busmaster/homebus/hardware/do8/do8_brd.png

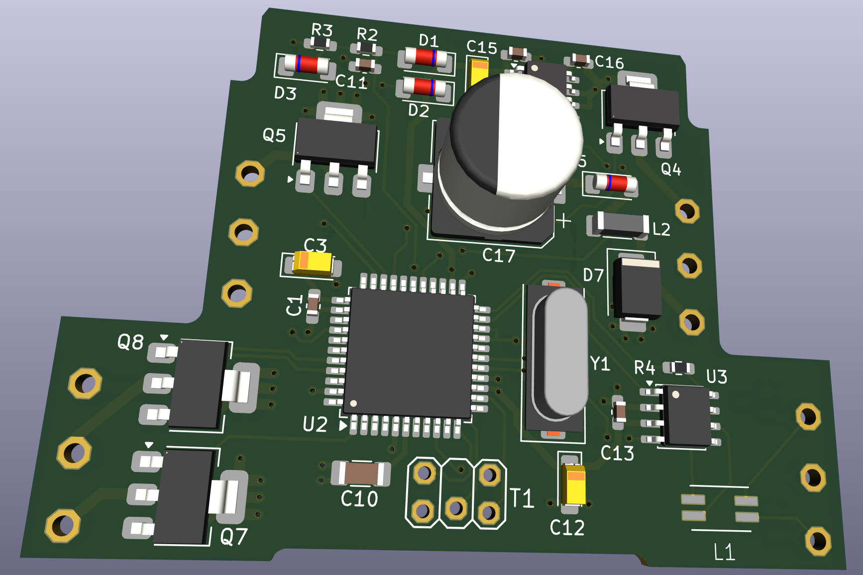
hardware/do8/do8_brd.png
