busmaster/homebus/hardware/cff3100if/cff3100if.jpg

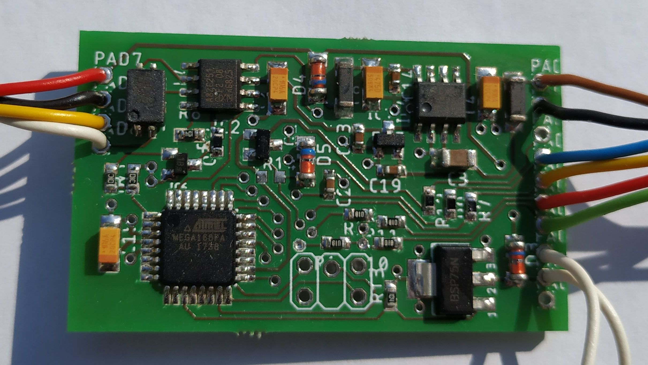
hardware/cff3100if/cff3100if.jpg
