busmaster/homebus/hardware/cff3100if/cff3100.jpg

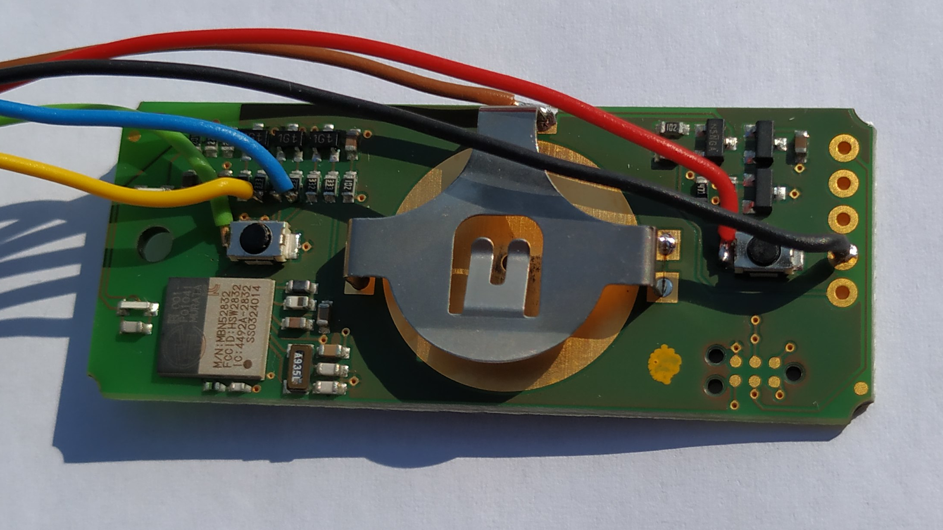
hardware/cff3100if/cff3100.jpg
