busmaster/homebus/hardware/cff3100if/cff3100if_brd.png

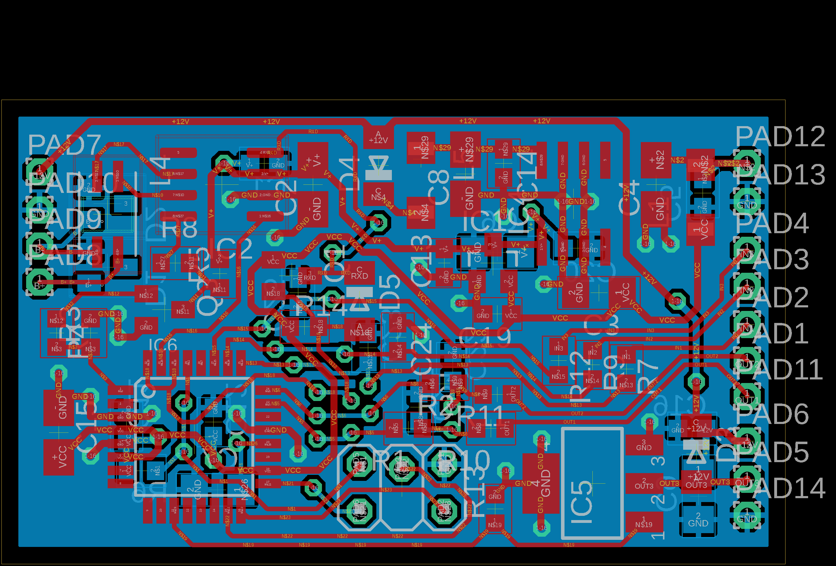
hardware/cff3100if/cff3100if_brd.png
