busmaster/homebus/hardware/cff3100if/cff3100if_sch.png

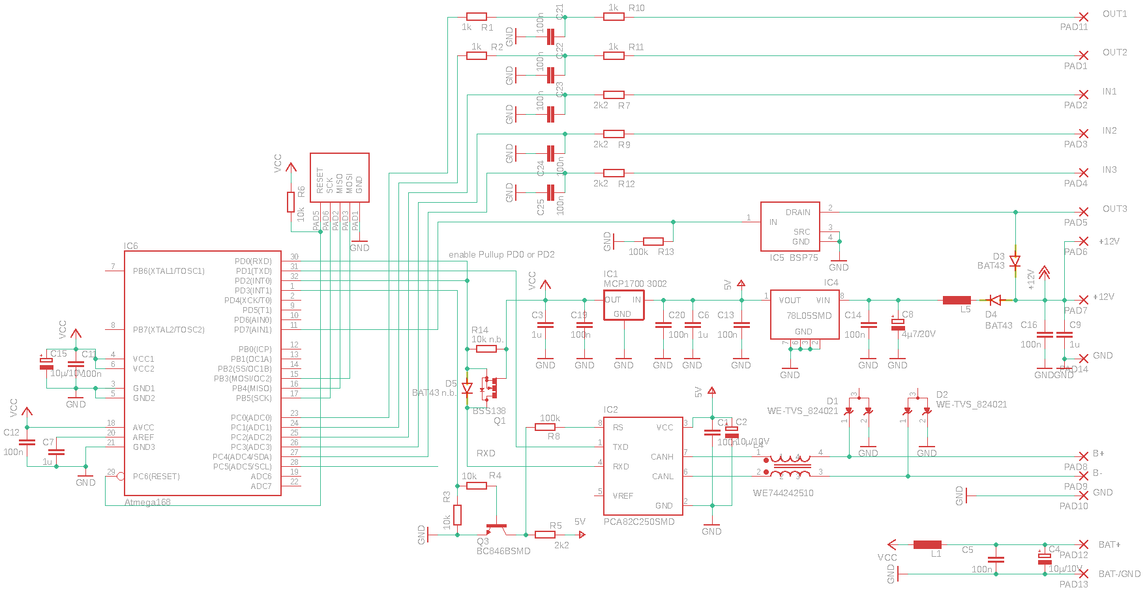
hardware/cff3100if/cff3100if_sch.png
