busmaster/homebus/hardware/do8/do8_sch.png

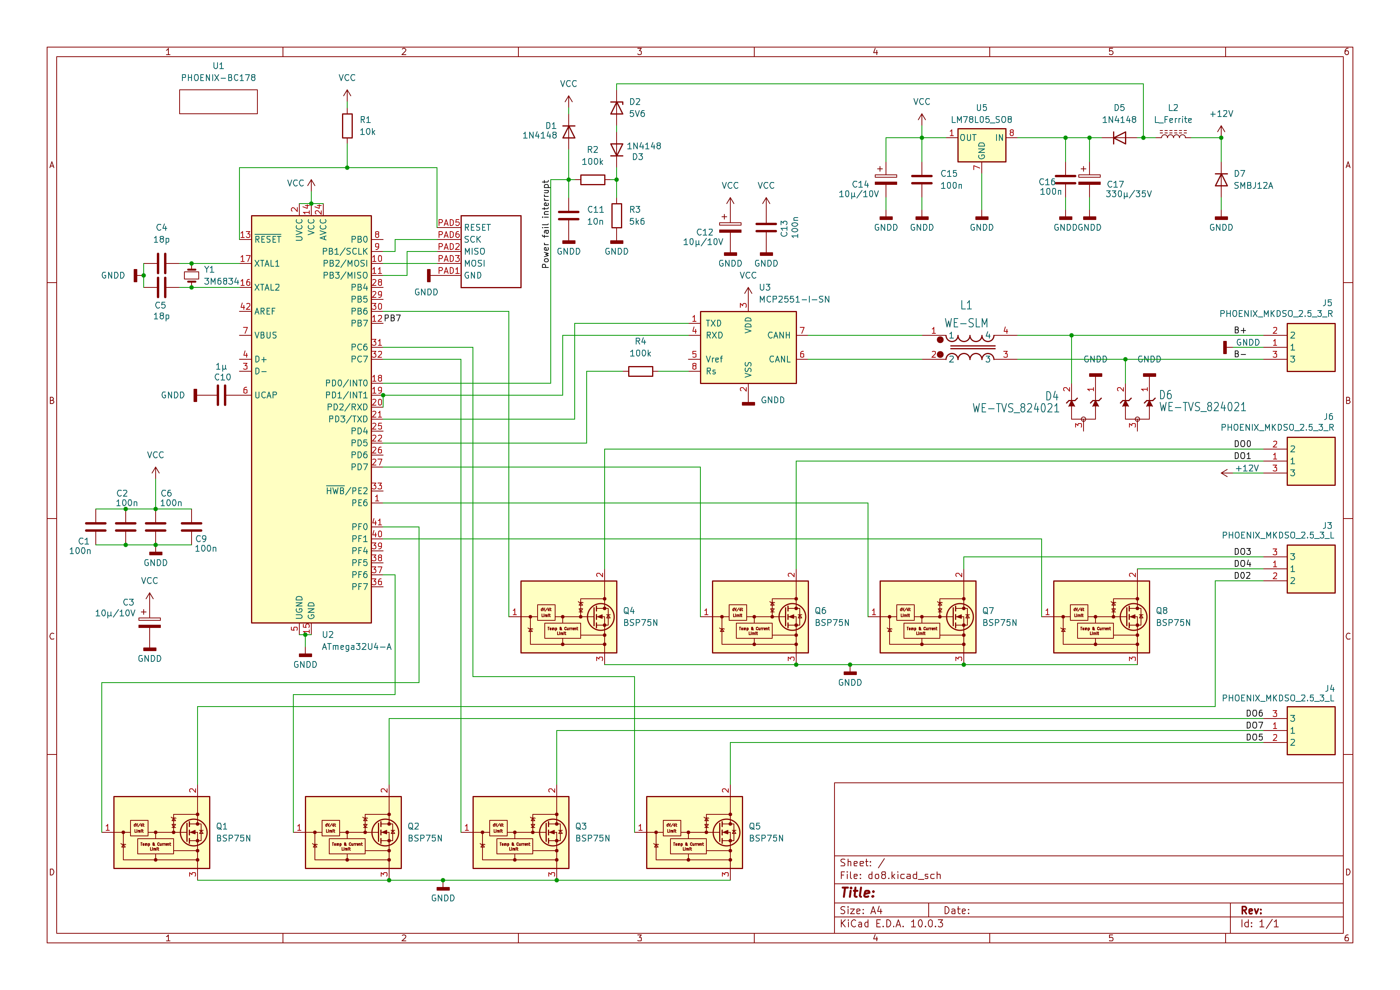
hardware/do8/do8_sch.png
