busmaster/homebus/hardware/do31/do31_brd.png

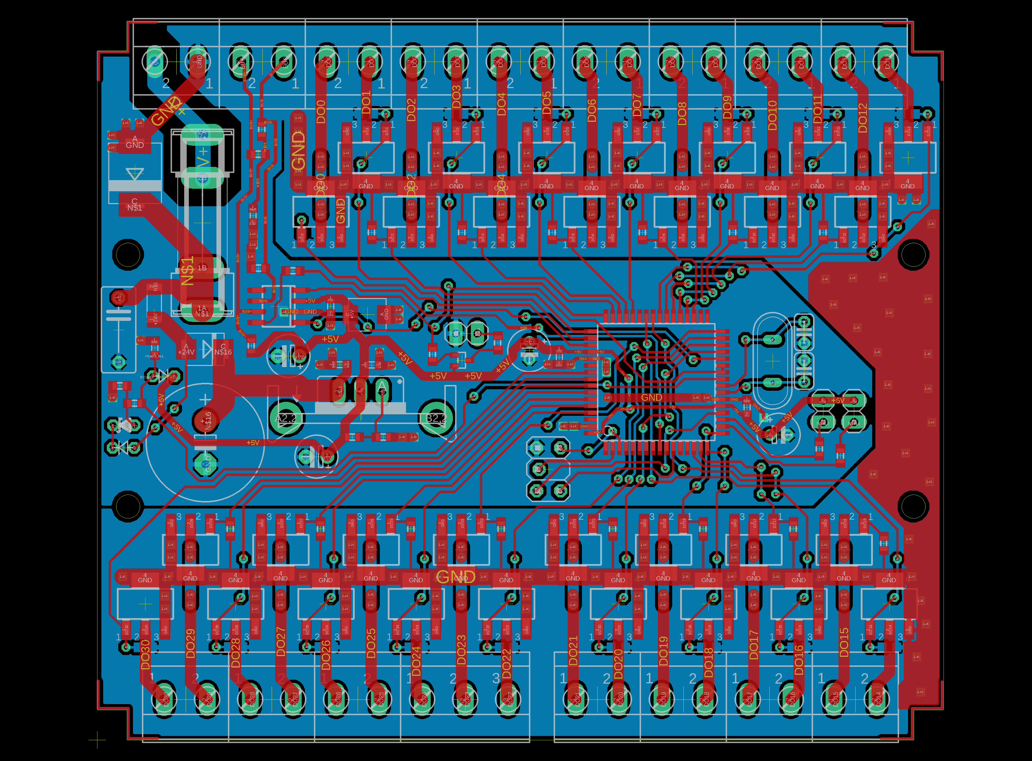
hardware/do31/do31_brd.png
