busmaster/homebus/hardware/do31/do31_sch.png

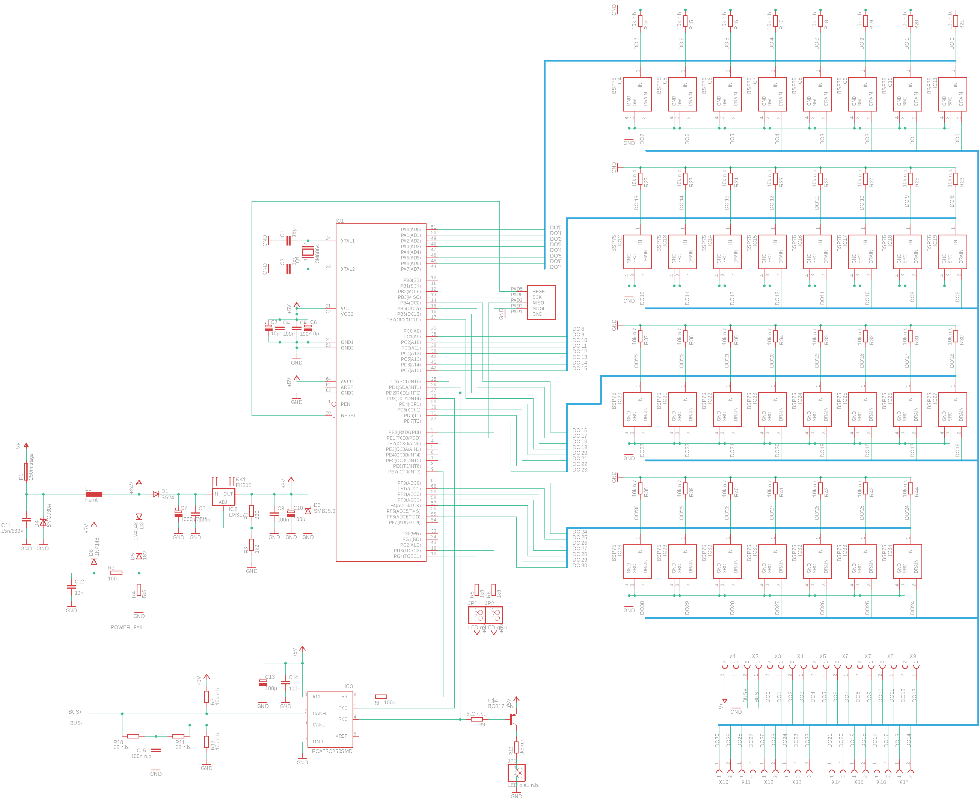
hardware/do31/do31_sch.png
