busmaster/homebus/hardware/smartmeterif/smartmeterif_2_brd.png

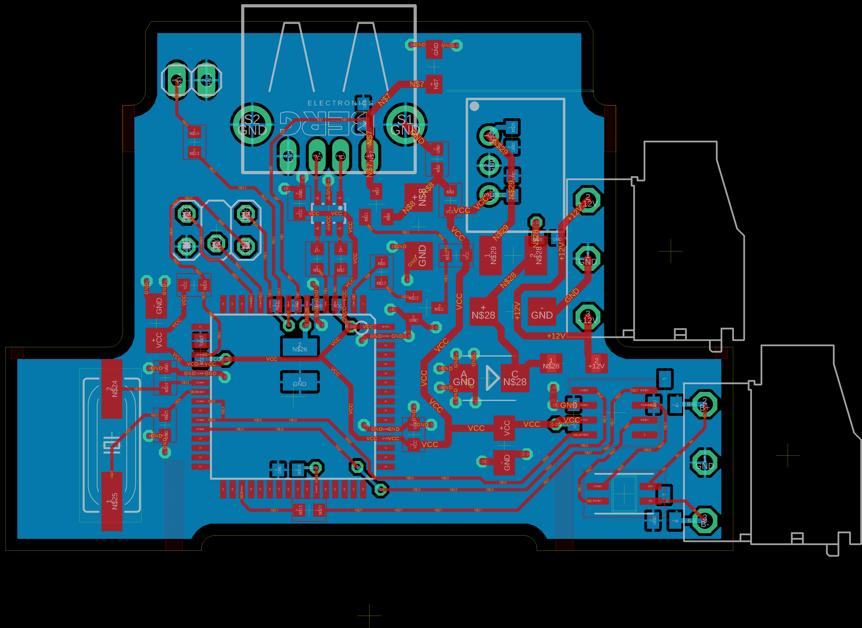
hardware/smartmeterif/smartmeterif_2_brd.png
