busmaster/homebus/hardware/smartmeterif/smartmeterif_2_sch.png

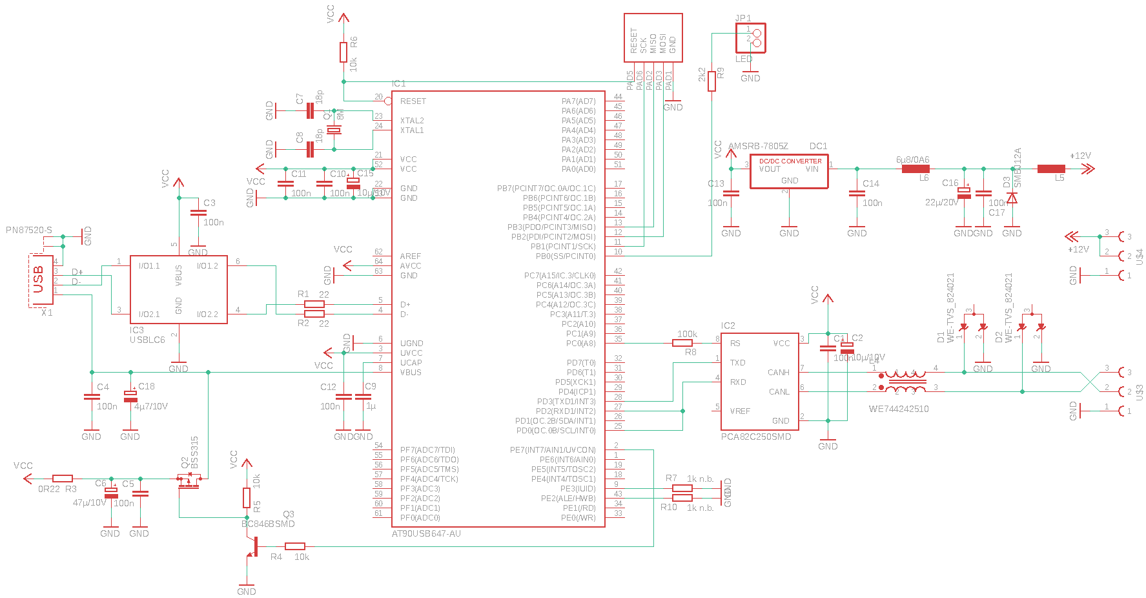
hardware/smartmeterif/smartmeterif_2_sch.png
