busmaster/homebus/hardware/smartmeterif/smartmeterif_brd.png

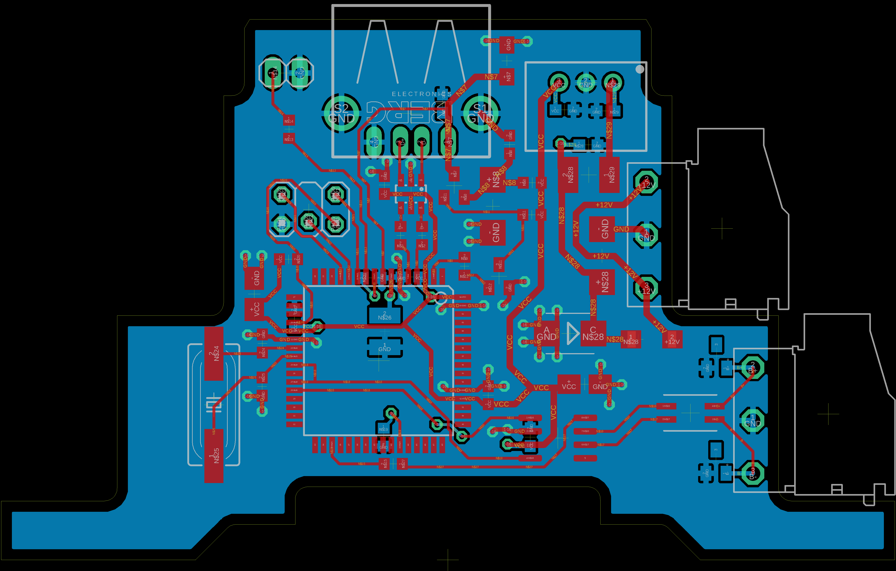
hardware/smartmeterif/smartmeterif_brd.png
