busmaster/homebus/hardware/stoveguard/stoveguard_brd.png

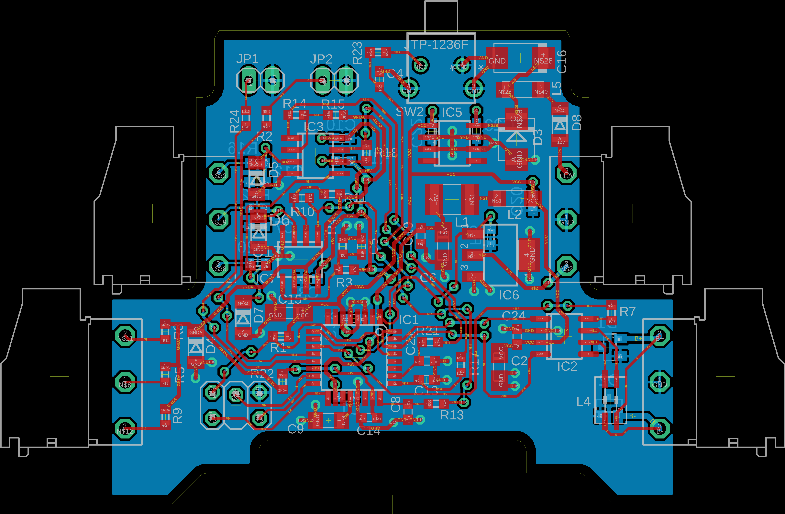
hardware/stoveguard/stoveguard_brd.png
