busmaster/homebus/hardware/stoveguard/stoveguard_sch.png

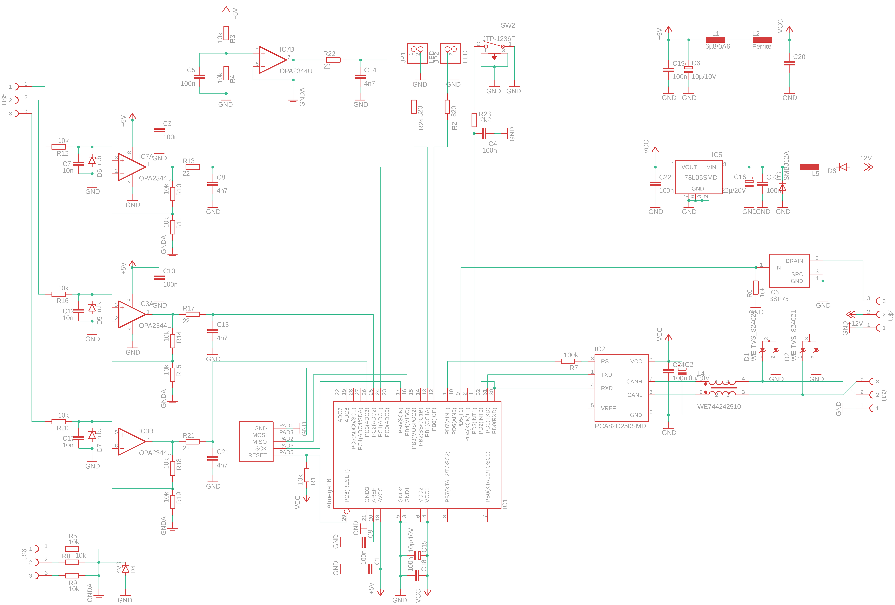
hardware/stoveguard/stoveguard_sch.png
