busmaster/homebus/hardware/usbif/usbif2.png

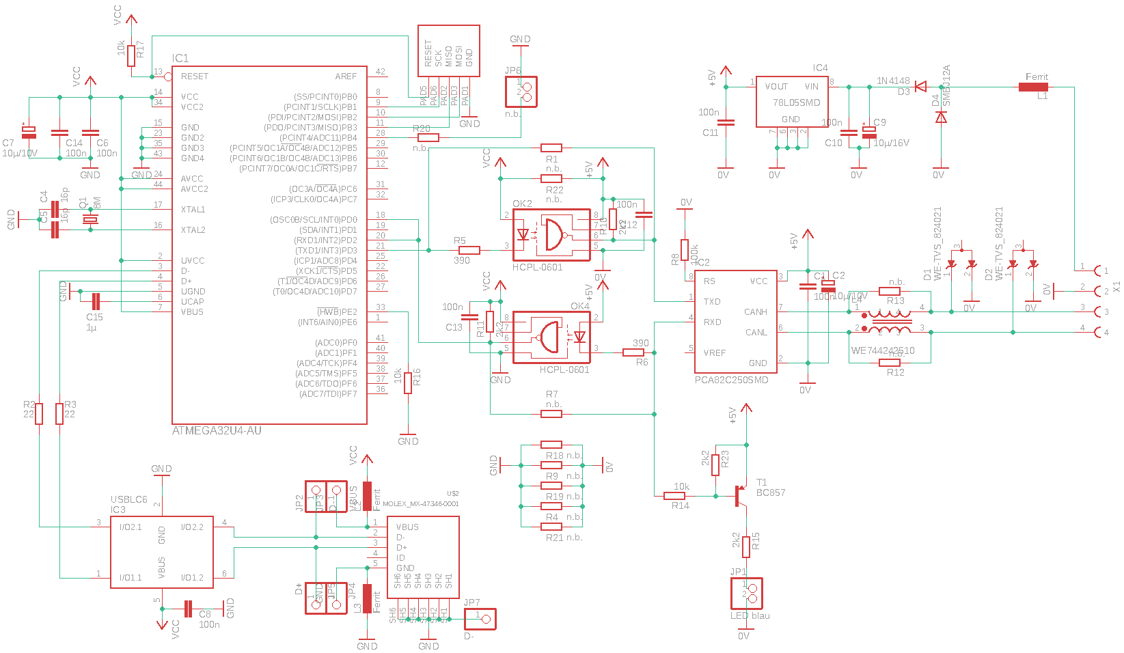
hardware/usbif/usbif2.png
