busmaster/homebus/hardware/do8/do8.kicad_pcb

## KiCad design hardware/do8/do8.kicad_pcb (2026-06-28)

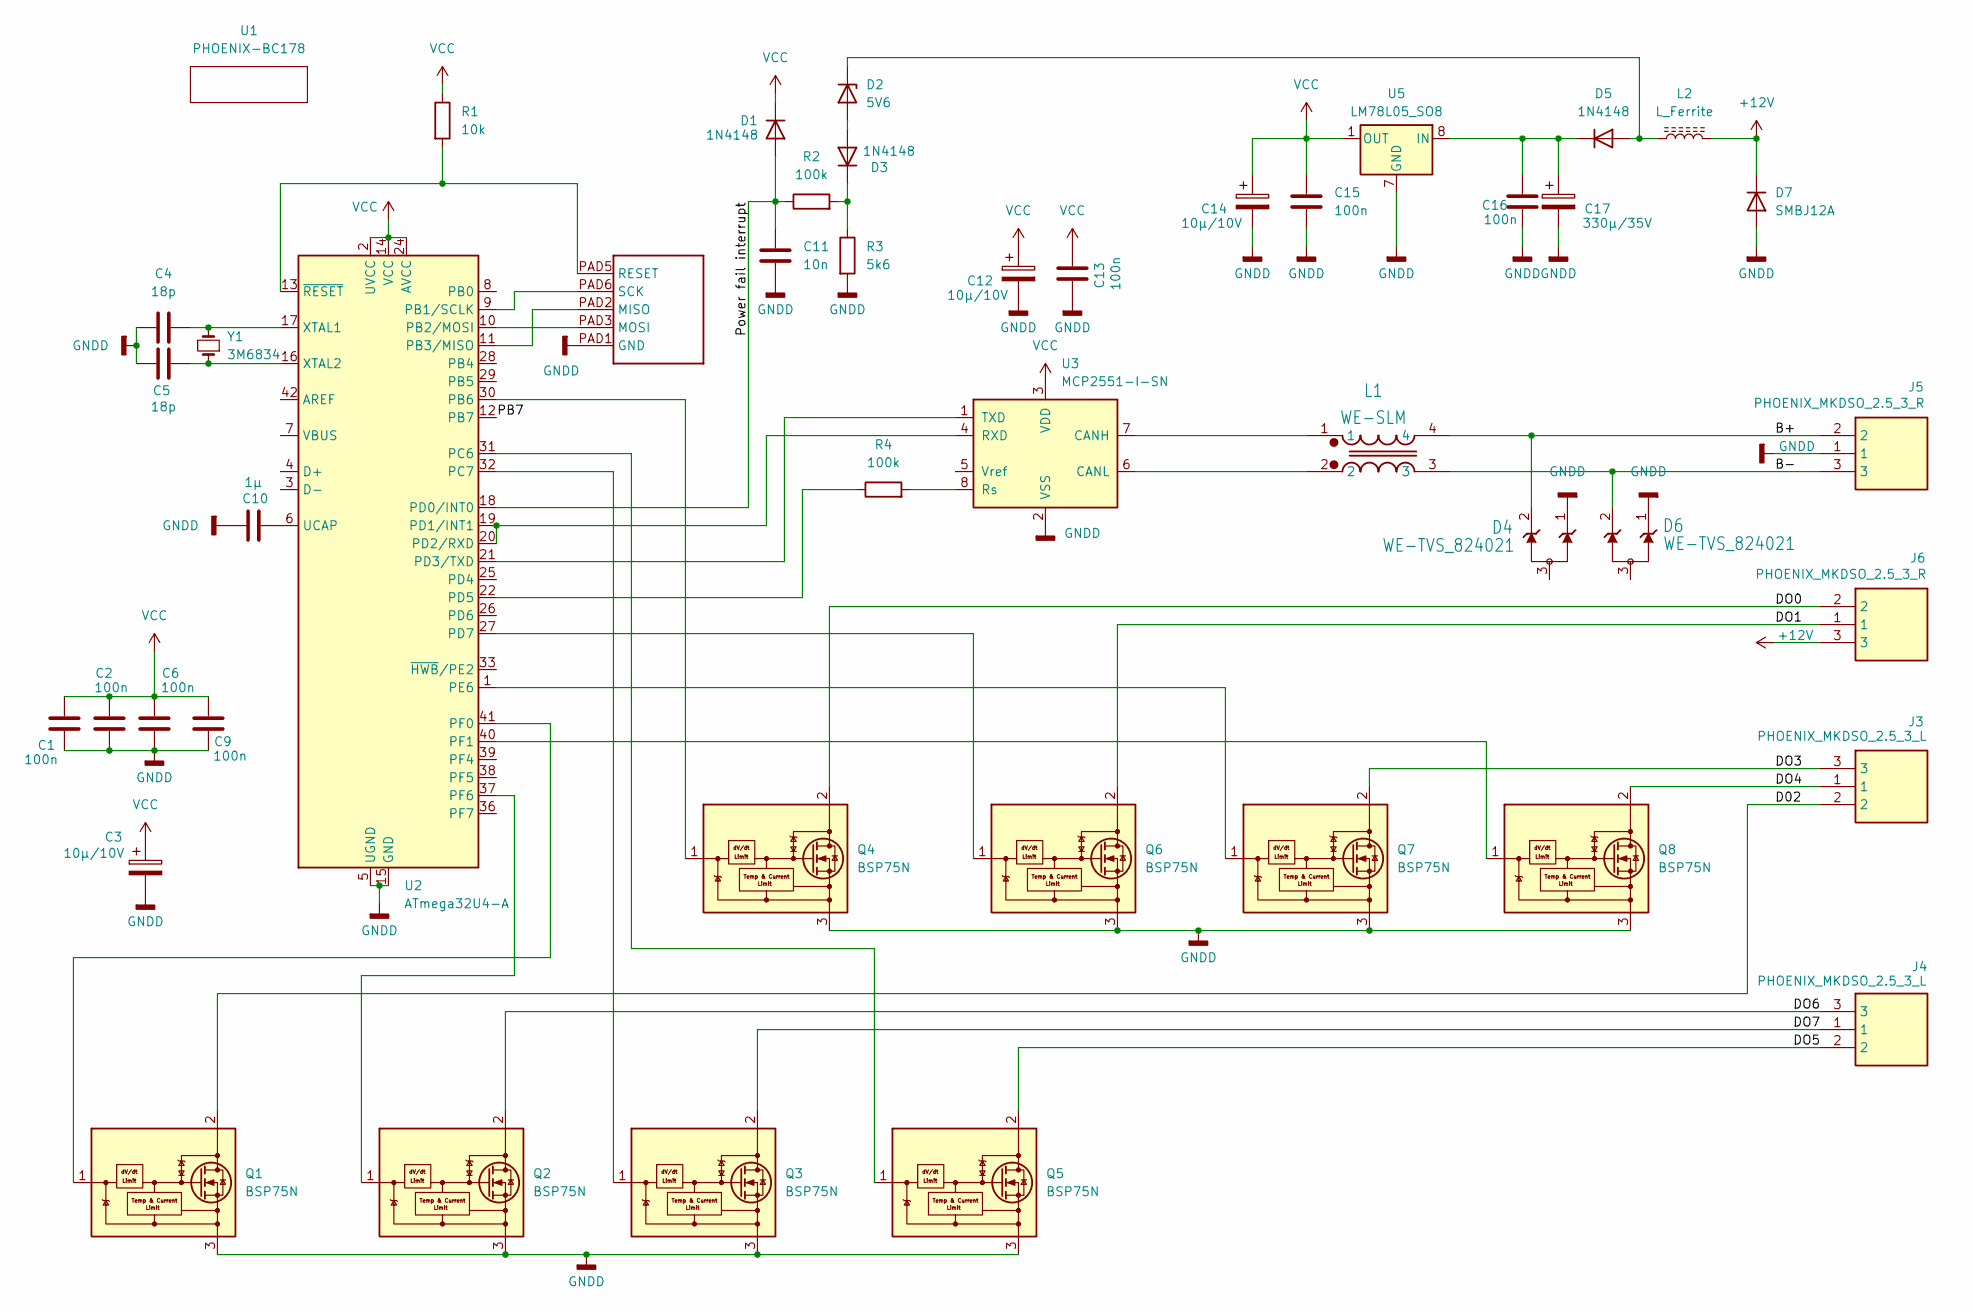
[picture p16: schematic do8.kicad_sch]

Parts:
C1, C2, C6, C9, C13, C15, C16: 100n; C_0603_1608Metric_Pad1.08x0.95mm_HandSolder
C3, C12, C14: 10µ/10V; CP_EIA-3216-18_Kemet-A_HandSolder
C4, C5: 18p; C_0603_1608Metric_Pad1.08x0.95mm_HandSolder
C10: 1µ; C_1206_3216Metric_Pad1.33x1.80mm_HandSolder
C11: 10n; C_0603_1608Metric_Pad1.08x0.95mm_HandSolder
C17: 330µ/35V; CP_Elec_10x10.5
D1, D3, D5: 1N4148; D_MiniMELF
D2: 5V6; D_MiniMELF
D4, D6: WE-TVS_824021
D7: SMBJ12A; D_SMB
J3, J4: PHOENIX_MKDSO_2.5_3_L; phoenix_mkdso_2.5_3_l; Manufacturer_Part_Number 2854102; Mouser Part Number 651-2854102
J5, J6: PHOENIX_MKDSO_2.5_3_R; phoenix_mkdso_2.5_3_r; Manufacturer_Part_Number 2854092; Mouser Part Number 651-2854092
L1: WE-SLM
L2: L_Ferrite; L_1806_4516Metric
Q1, Q2, Q3, Q4, Q5, Q6, Q7, Q8: BSP75N; SOT-223
R1: 10k; R_0603_1608Metric_Pad0.98x0.95mm_HandSolder
R2, R4: 100k; R_0603_1608Metric_Pad0.98x0.95mm_HandSolder
R3: 5k6; R_0603_1608Metric_Pad0.98x0.95mm_HandSolder
T1: atmel-isp
U1: PHOENIX-BC178; phoenix-bc178-reduced-3
U2: ATmega32U4-A; TQFP-44_10x10mm_P0.8mm
U3: MCP2551-I-SN; SOIC-8_3.9x4.9mm_P1.27mm
U5: LM78L05_SO8; SOIC-8_3.9x4.9mm_P1.27mm
Y1: 3M6834; Crystal_SMD_HC49-SD

Connections:
+12V: D7.1 (K), J6.3, L2.2
/B+: D4.2, J5.2, L1.4
/B-: D6.2, J5.3, L1.3
/D02: J3.2, Q1.2 (DRAIN)
/DO0: J6.2, Q4.2 (DRAIN)
/DO1: J6.1, Q6.2 (DRAIN)
/DO3: J3.3, Q7.2 (DRAIN)
/DO4: J3.1, Q8.2 (DRAIN)
/DO5: J4.2, Q5.2 (DRAIN)
/DO6: J4.3, Q2.2 (DRAIN)
/DO7: J4.1, Q3.2 (DRAIN)
/Power fail interrupt: C11.1, D1.2 (A), R2.1, U2.18 (PD0)
GNDD: C1.1, C2.1, C3.2, C4.1, C5.1, C6.1, C9.1, C10.2, C11.2, C12.2, C13.1, C14.2, C15.2, C16.2, C17.2, D4.1, D6.1, D7.2 (A), J5.1, Q1.3 (SOURCE), Q1.4 (SOURCE), Q2.3 (SOURCE), Q2.4 (SOURCE), Q3.3 (SOURCE), Q3.4 (SOURCE), Q4.3 (SOURCE), Q4.4 (SOURCE), Q5.3 (SOURCE), Q5.4 (SOURCE), Q6.3 (SOURCE), Q6.4 (SOURCE), Q7.3 (SOURCE), Q7.4 (SOURCE), Q8.3 (SOURCE), Q8.4 (SOURCE), R3.2, T1.PAD1 (GND), U2.5 (UGND), U2.15 (GND), U2.23 (GND), U2.35 (GND), U2.43 (GND), U3.2 (VSS), U5.2 (GND), U5.3 (GND), U5.6 (GND), U5.7 (GND)
unnamed: D2.2 (A), D3.2 (A)
unnamed: D2.1 (K), D5.2 (A), L2.1
unnamed: D3.1 (K), R2.2, R3.1
unnamed: C16.1, C17.1, D5.1 (K), U5.8 (IN)
unnamed: Q1.1 (IN), U2.41 (PF0)
unnamed: Q2.1 (IN), U2.37 (PF6)
unnamed: Q3.1 (IN), U2.32 (PC7)
unnamed: Q4.1 (IN), U2.30 (PB6)
unnamed: Q5.1 (IN), U2.31 (PC6)
unnamed: Q6.1 (IN), U2.27 (PD7)
unnamed: Q7.1 (IN), U2.1 (PE6)
unnamed: Q8.1 (IN), U2.40 (PF1)
unnamed: T1.PAD2 (MISO), U2.11 (PB3)
unnamed: T1.PAD3 (MOSI), U2.10 (PB2)
unnamed: R1.2, T1.PAD5 (RESET), U2.13 (~RESET)
unnamed: T1.PAD6 (SCK), U2.9 (PB1)
unnamed: U2.19 (PD1), U2.20 (PD2), U3.4 (RXD)
unnamed: U2.21 (PD3), U3.1 (TXD)
unnamed: R4.1, U2.22 (PD5)
unnamed: C10.1, U2.6 (UCAP)
unnamed: C4.2, U2.17 (XTAL1), Y1.2
unnamed: C5.2, U2.16 (XTAL2), Y1.1
unnamed: L1.1, U3.7 (CANH)
unnamed: L1.2, U3.6 (CANL)
unnamed: R4.2, U3.8 (Rs)
VCC: C1.2, C2.2, C3.1, C6.2, C9.2, C12.1, C13.2, C14.1, C15.1, D1.1 (K), R1.1, U2.2 (UVCC), U2.14 (VCC), U2.24 (AVCC), U2.34 (VCC), U2.44 (AVCC), U3.3 (VDD), U5.1 (OUT)

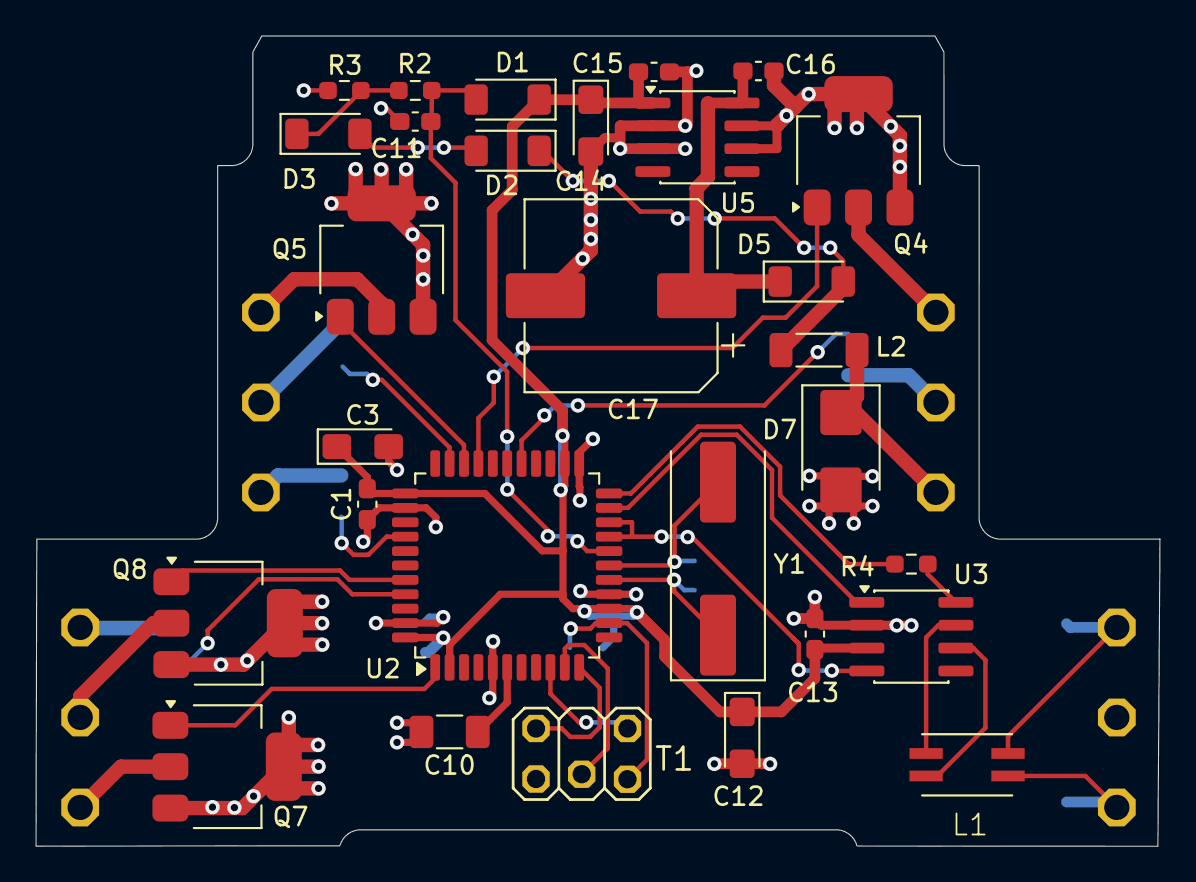
[picture p17: board do8.kicad_pcb from above]

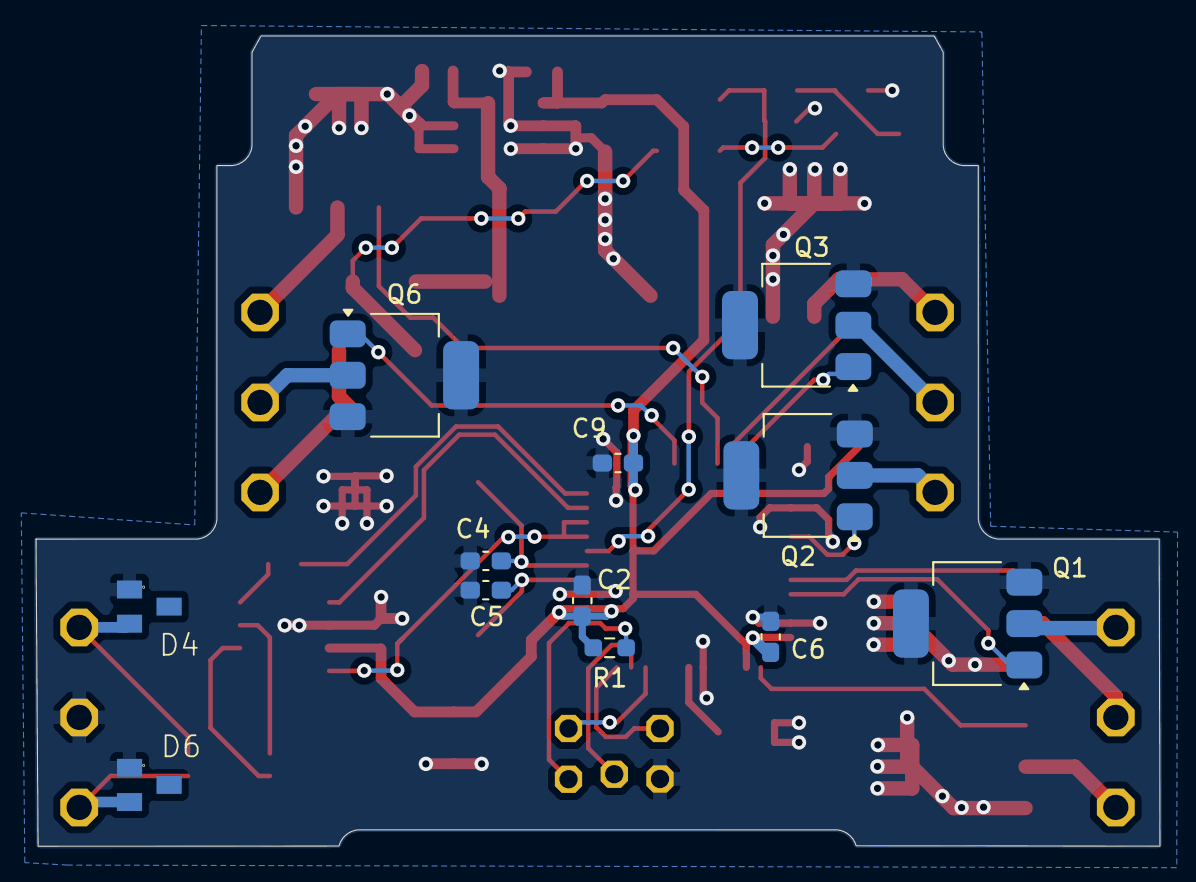
[picture p18: board do8.kicad_pcb from below]

Board: 2 copper layers, 62.4 x 45.0 mm, 46 parts (12 on the bottom side), 39 nets.
