busmaster/homebus/hardware/do31/do31.brd

## EAGLE design hardware/do31/do31.brd (2023-08-31)

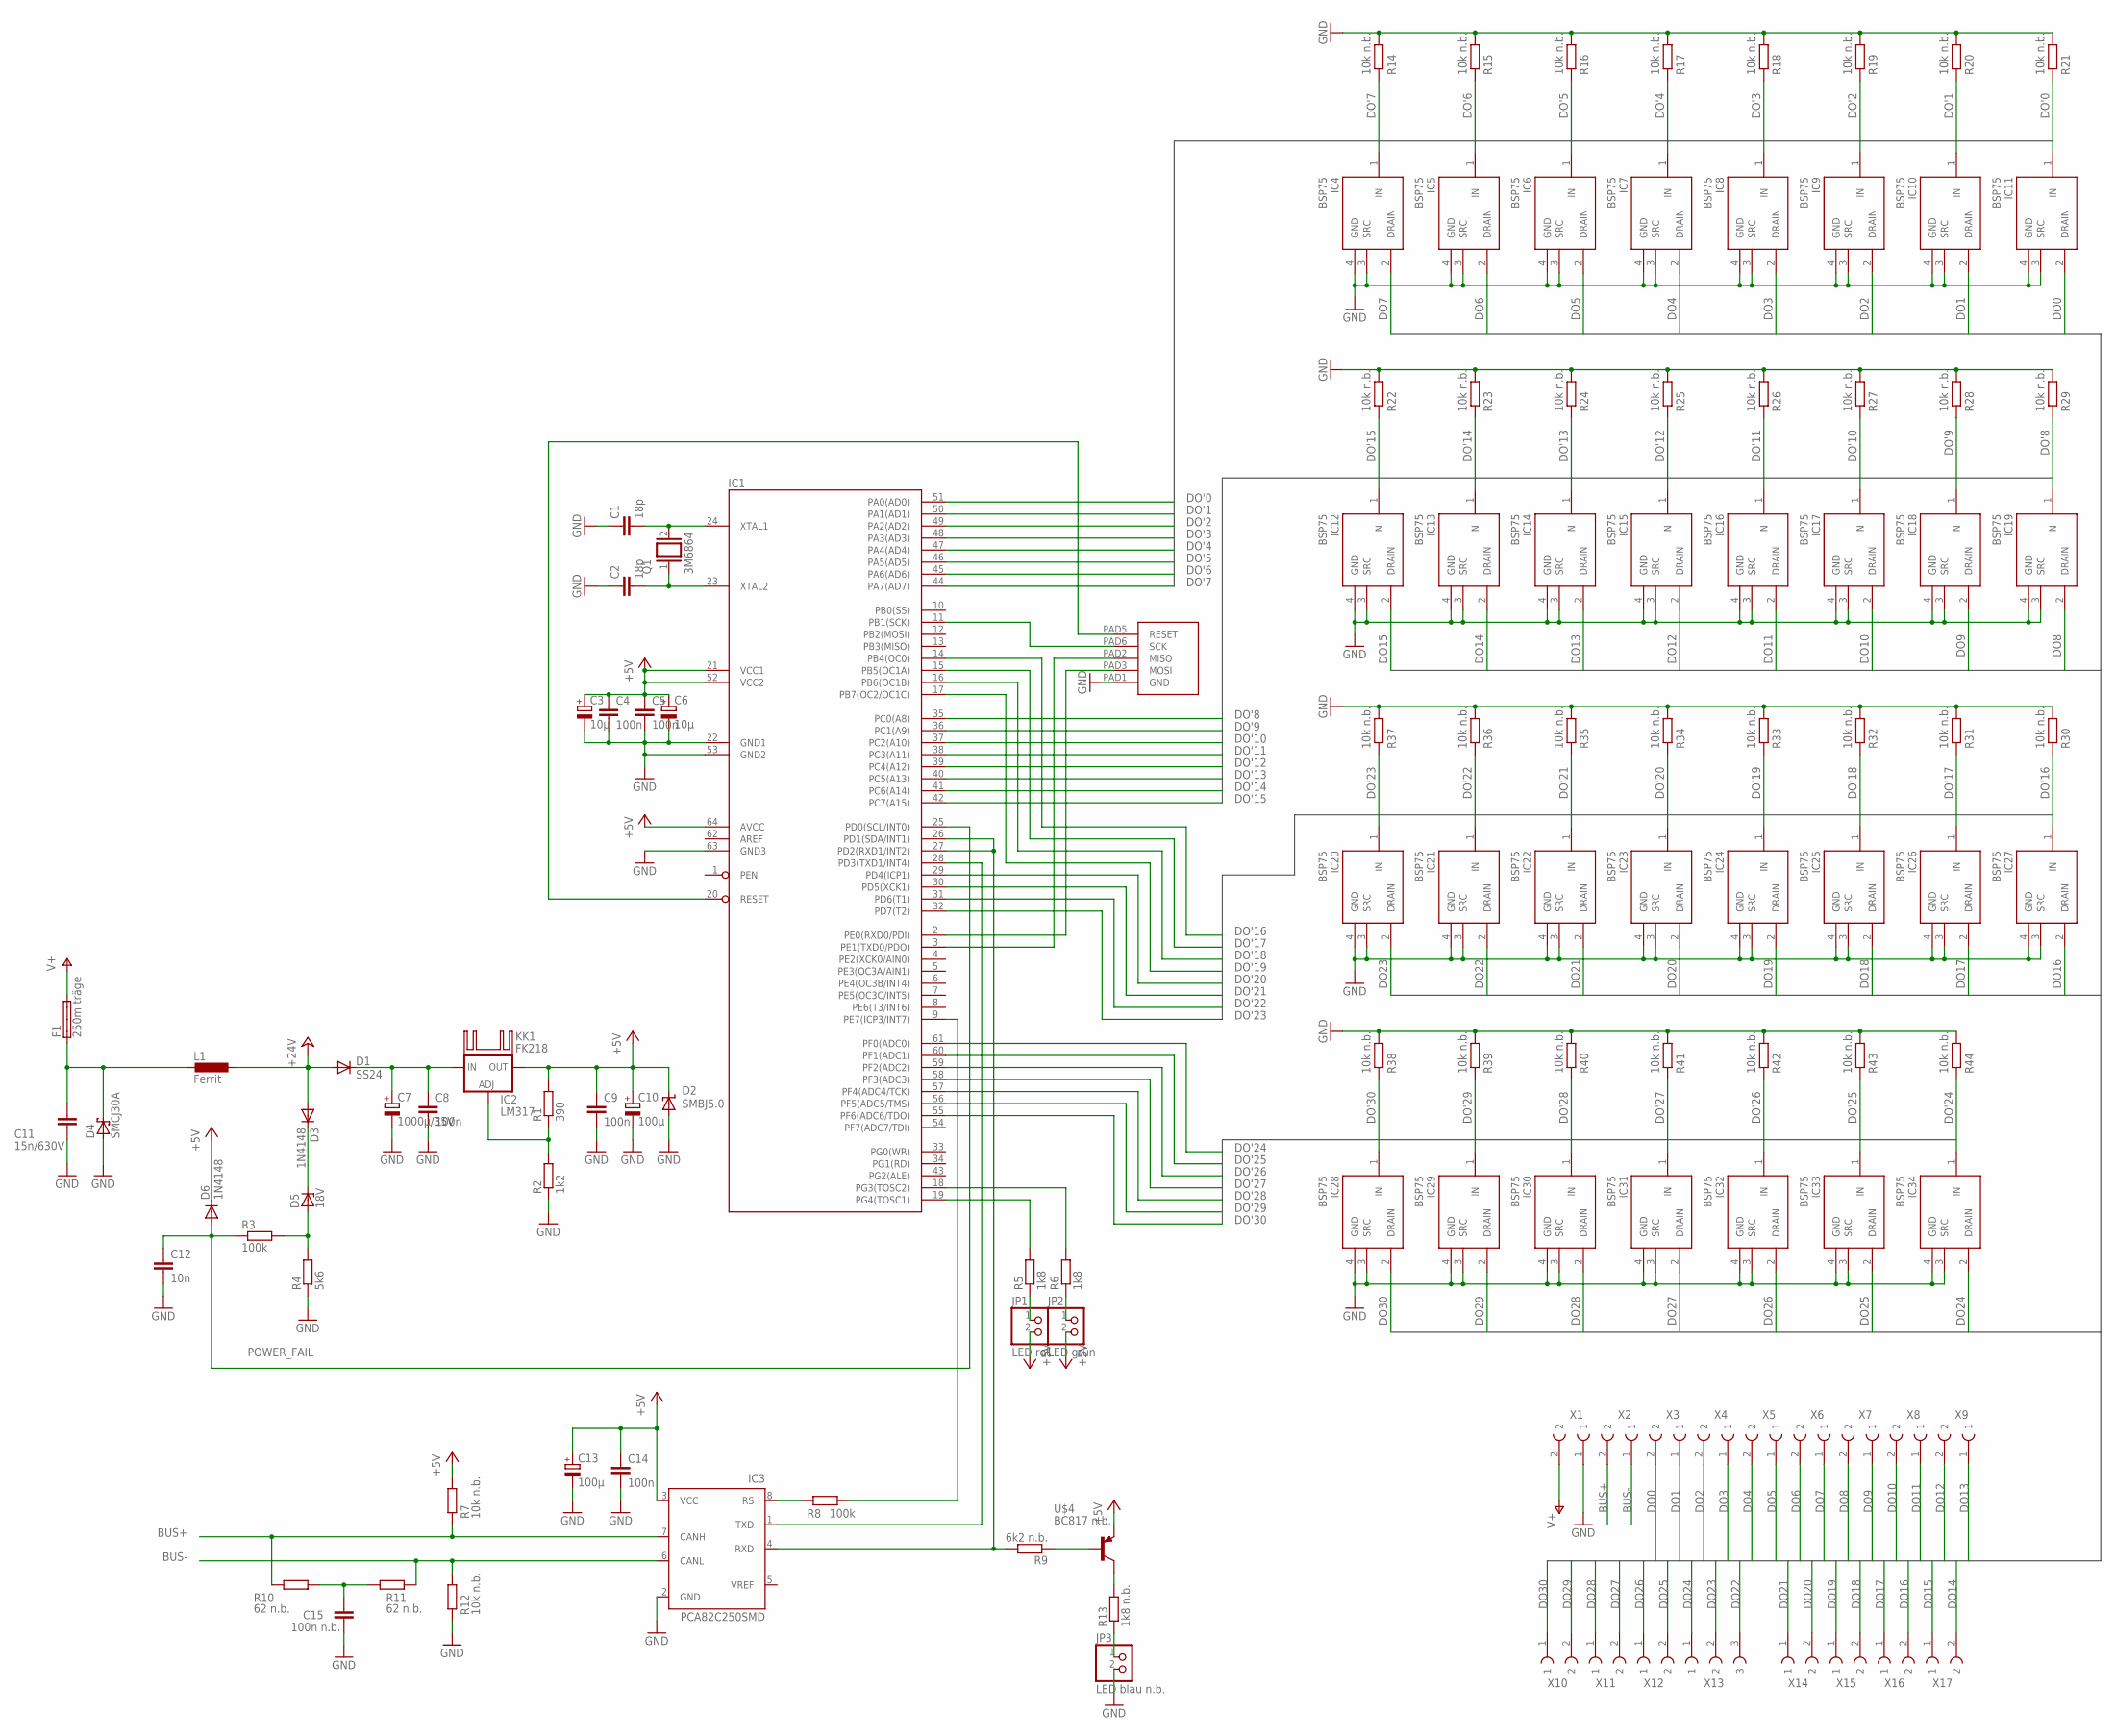
[picture p19: schematic do31.sch]

Parts:
C1, C2: 18p; C025-024X044
C3, C6: 10µ; E2-5
C4, C5, C8, C9, C14: 100n; C0603K
C7: 1000µ/35V; E5-13
C10, C13: 100µ; E2,5-5
C11: 15n/630V; C075-042X103
C12: 10n; C0603K
C15: 100n n.b.; C0603K
D1: SS24; SMB
D2: SMBJ5.0; SMBJ
D3, D6: 1N4148; D-2.5
D4: SMCJ30A; SMC
D5: 18V; ZDIO-2.5
F1: 250m träge; SHK20L
IC1: ATMEGA128; TQFP64
IC2: LM317; 317TS
IC3: PCA82C250SMD; SO8
IC4, IC5, IC6, IC7, IC8, IC9, IC10, IC11, IC12, IC13, IC14, IC15, IC16, IC17, IC18, IC19, IC20, IC21, IC22, IC23, IC24, IC25, IC26, IC27, IC28, IC29, IC30, IC31, IC32, IC33, IC34: BSP75; SOT223
JP1: LED rot; 1X02
JP2: LED grün; 1X02
JP3: LED blau n.b.; 1X02
KK1: FK218
L1: Ferrit; L1806
Q1: 3M6864; QS
R1: 390; R0603
R2: 1k2; R0603
R3, R8: 100k; R0603
R4: 5k6; R0603
R5, R6: 1k8; R0603
R7, R12, R14, R15, R16, R17, R18, R19, R20, R21, R22, R23, R24, R25, R26, R27, R28, R29, R30, R31, R32, R33, R34, R35, R36, R37, R38, R39, R40, R41, R42, R43, R44: 10k n.b.; R0603
R9: 6k2 n.b.; R0603
R10, R11: 62 n.b.; R0603
R13: 1k8 n.b.; R0603
U$1: ATMEL_ISP
U$4: BC817 n.b.; SOT323-BEC
X1, X2, X3, X4, X5, X6, X7, X8, X9, X10, X11, X12, X14, X15, X16, X17: AR-KLEMME_508_2POLPTR; W237-2E
X13: AR-KLEMME_508_3POLPTR; W237-3E

Connections:
+5V: C3.+, C4.1, C5.1, C6.+, C9.1, C10.+, C13.+, C14.1, D2.C, D6.C, IC1.21 (VCC1), IC1.52 (VCC2), IC1.64 (AVCC), IC2.2 (OUT), IC3.3 (VCC), JP1.2, JP2.2, R1.2, R7.1, U$4.E
+24V: D1.A, D3.A, L1.1
/RESET: IC1.20 (RESET), U$1.PAD5 (RESET)
AREF: IC1.62 (AREF)
BUS+: IC3.7 (CANH), R7.2, R10.2, X2.2
BUS-: IC3.6 (CANL), R11.1, R12.1, X2.1
DO0: IC11.2 (DRAIN), X3.2
DO1: IC10.2 (DRAIN), X3.1
DO2: IC9.2 (DRAIN), X4.2
DO3: IC8.2 (DRAIN), X4.1
DO4: IC7.2 (DRAIN), X5.2
DO5: IC6.2 (DRAIN), X5.1
DO6: IC5.2 (DRAIN), X6.2
DO7: IC4.2 (DRAIN), X6.1
DO8: IC19.2 (DRAIN), X7.2
DO9: IC18.2 (DRAIN), X7.1
DO10: IC17.2 (DRAIN), X8.2
DO11: IC16.2 (DRAIN), X8.1
DO12: IC15.2 (DRAIN), X9.2
DO13: IC14.2 (DRAIN), X9.1
DO14: IC13.2 (DRAIN), X17.2
DO15: IC12.2 (DRAIN), X17.1
DO16: IC27.2 (DRAIN), X16.2
DO17: IC26.2 (DRAIN), X16.1
DO18: IC25.2 (DRAIN), X15.2
DO19: IC24.2 (DRAIN), X15.1
DO20: IC23.2 (DRAIN), X14.2
DO21: IC22.2 (DRAIN), X14.1
DO22: IC21.2 (DRAIN), X13.3
DO23: IC20.2 (DRAIN), X13.2
DO24: IC34.2 (DRAIN), X13.1
DO25: IC33.2 (DRAIN), X12.2
DO26: IC32.2 (DRAIN), X12.1
DO27: IC31.2 (DRAIN), X11.2
DO28: IC30.2 (DRAIN), X11.1
DO29: IC29.2 (DRAIN), X10.2
DO30: IC28.2 (DRAIN), X10.1
DO'0: IC1.51 (PA0(AD0)), IC11.1 (IN), R21.2
DO'1: IC1.50 (PA1(AD1)), IC10.1 (IN), R20.2
DO'2: IC1.49 (PA2(AD2)), IC9.1 (IN), R19.2
DO'3: IC1.48 (PA3(AD3)), IC8.1 (IN), R18.2
DO'4: IC1.47 (PA4(AD4)), IC7.1 (IN), R17.2
DO'5: IC1.46 (PA5(AD5)), IC6.1 (IN), R16.2
DO'6: IC1.45 (PA6(AD6)), IC5.1 (IN), R15.2
DO'7: IC1.44 (PA7(AD7)), IC4.1 (IN), R14.2
DO'8: IC1.35 (PC0(A8)), IC19.1 (IN), R29.2
DO'9: IC1.36 (PC1(A9)), IC18.1 (IN), R28.2
DO'10: IC1.37 (PC2(A10)), IC17.1 (IN), R27.2
DO'11: IC1.38 (PC3(A11)), IC16.1 (IN), R26.2
DO'12: IC1.39 (PC4(A12)), IC15.1 (IN), R25.2
DO'13: IC1.40 (PC5(A13)), IC14.1 (IN), R24.2
DO'14: IC1.41 (PC6(A14)), IC13.1 (IN), R23.2
DO'15: IC1.42 (PC7(A15)), IC12.1 (IN), R22.2
DO'16: IC1.14 (PB4(OC0)), IC27.1 (IN), R30.2
DO'17: IC1.15 (PB5(OC1A)), IC26.1 (IN), R31.2
DO'18: IC1.16 (PB6(OC1B)), IC25.1 (IN), R32.2
DO'19: IC1.17 (PB7(OC2/OC1C)), IC24.1 (IN), R33.2
DO'20: IC1.29 (PD4(ICP1)), IC23.1 (IN), R34.2
DO'21: IC1.30 (PD5(XCK1)), IC22.1 (IN), R35.2
DO'22: IC1.31 (PD6(T1)), IC21.1 (IN), R36.2
DO'23: IC1.32 (PD7(T2)), IC20.1 (IN), R37.2
DO'24: IC1.61 (PF0(ADC0)), IC34.1 (IN), R44.2
DO'25: IC1.60 (PF1(ADC1)), IC33.1 (IN), R43.2
DO'26: IC1.59 (PF2(ADC2)), IC32.1 (IN), R42.2
DO'27: IC1.58 (PF3(ADC3)), IC31.1 (IN), R41.2
DO'28: IC1.57 (PF4(ADC4/TCK)), IC30.1 (IN), R40.2
DO'29: IC1.56 (PF5(ADC5/TMS)), IC29.1 (IN), R39.2
DO'30: IC1.55 (PF6(ADC6/TDO)), IC28.1 (IN), R38.2
GND: C1.1, C2.1, C3.-, C4.2, C5.2, C6.-, C7.-, C8.2, C9.2, C10.-, C11.2, C12.2, C13.-, C14.2, C15.1, D2.A, D4.A, IC1.22 (GND1), IC1.53 (GND2), IC1.63 (GND3), IC3.2 (GND), IC4.3 (SRC), IC4.4 (GND), IC5.3 (SRC), IC5.4 (GND), IC6.3 (SRC), IC6.4 (GND), IC7.3 (SRC), IC7.4 (GND), IC8.3 (SRC), IC8.4 (GND), IC9.3 (SRC), IC9.4 (GND), IC10.3 (SRC), IC10.4 (GND), IC11.3 (SRC), IC11.4 (GND), IC12.3 (SRC), IC12.4 (GND), IC13.3 (SRC), IC13.4 (GND), IC14.3 (SRC), IC14.4 (GND), IC15.3 (SRC), IC15.4 (GND), IC16.3 (SRC), IC16.4 (GND), IC17.3 (SRC), IC17.4 (GND), IC18.3 (SRC), IC18.4 (GND), IC19.3 (SRC), IC19.4 (GND), IC20.3 (SRC), IC20.4 (GND), IC21.3 (SRC), IC21.4 (GND), IC22.3 (SRC), IC22.4 (GND), IC23.3 (SRC), IC23.4 (GND), IC24.3 (SRC), IC24.4 (GND), IC25.3 (SRC), IC25.4 (GND), IC26.3 (SRC), IC26.4 (GND), IC27.3 (SRC), IC27.4 (GND), IC28.3 (SRC), IC28.4 (GND), IC29.3 (SRC), IC29.4 (GND), IC30.3 (SRC), IC30.4 (GND), IC31.3 (SRC), IC31.4 (GND), IC32.3 (SRC), IC32.4 (GND), IC33.3 (SRC), IC33.4 (GND), IC34.3 (SRC), IC34.4 (GND), JP3.2, R2.1, R4.1, R12.2, R14.1, R15.1, R16.1, R17.1, R18.1, R19.1, R20.1, R21.1, R22.1, R23.1, R24.1, R25.1, R26.1, R27.1, R28.1, R29.1, R30.1, R31.1, R32.1, R33.1, R34.1, R35.1, R36.1, R37.1, R38.1, R39.1, R40.1, R41.1, R42.1, R43.1, R44.1, U$1.PAD1 (GND), X1.1
MISO: IC1.3 (PE1(TXD0/PDO)), U$1.PAD2 (MISO)
MOSI: IC1.2 (PE0(RXD0/PDI)), U$1.PAD3 (MOSI)
unnamed: C11.1, D4.C, F1.1A, L1.2
unnamed: D3.C, D5.C
unnamed: D5.A, R3.2, R4.2
unnamed: C1.2, IC1.24 (XTAL1), Q1.2
unnamed: C2.2, IC1.23 (XTAL2), Q1.1
unnamed: IC3.8 (RS), R8.2
unnamed: IC1.9 (PE7(ICP3/INT7)), R8.1
unnamed: IC2.1 (ADJ), R1.1, R2.2
unnamed: R9.1, U$4.B
unnamed: R13.2, U$4.C
unnamed: C7.+, C8.1, D1.C, IC2.3 (IN)
unnamed: JP3.1, R13.1
unnamed: C15.2, R10.1, R11.2
unnamed: JP1.1, R5.1
unnamed: JP2.1, R6.1
unnamed: IC1.19 (PG4(TOSC1)), R5.2
unnamed: IC1.18 (PG3(TOSC2)), R6.2
POWER_FAIL: C12.1, D6.A, IC1.25 (PD0(SCL/INT0)), R3.1
RXD: IC1.26 (PD1(SDA/INT1)), IC1.27 (PD2(RXD1/INT2)), IC3.4 (RXD), R9.2
SCK: IC1.11 (PB1(SCK)), U$1.PAD6 (SCK)
TXD: IC1.28 (PD3(TXD1/INT4)), IC3.1 (TXD)
V+: F1.2A, X1.2

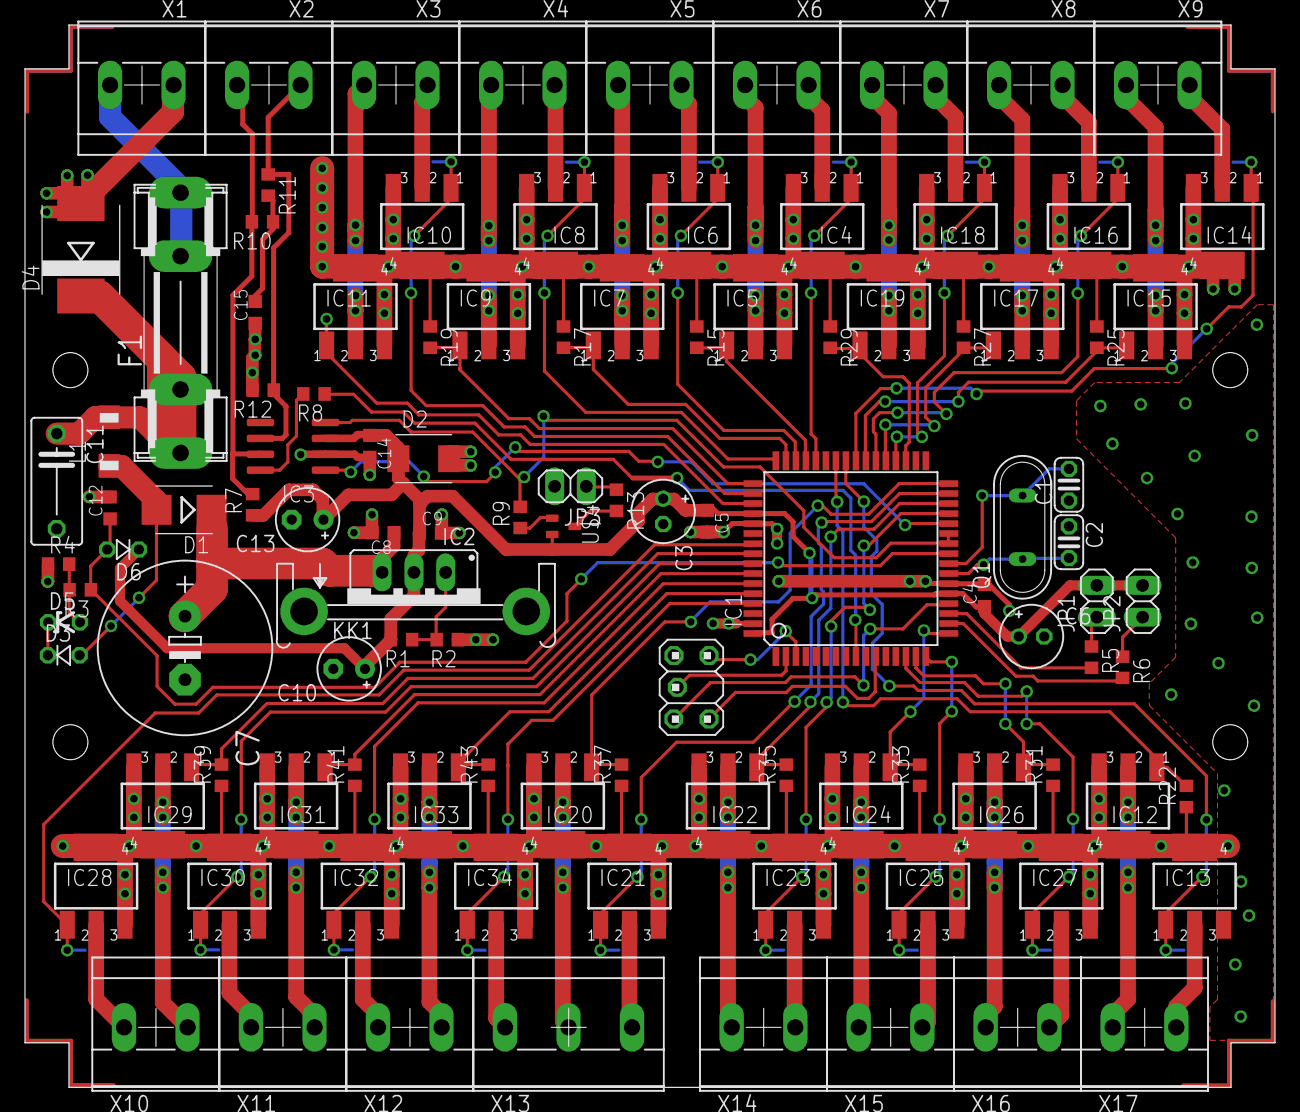
[picture p20: board do31.brd from above]

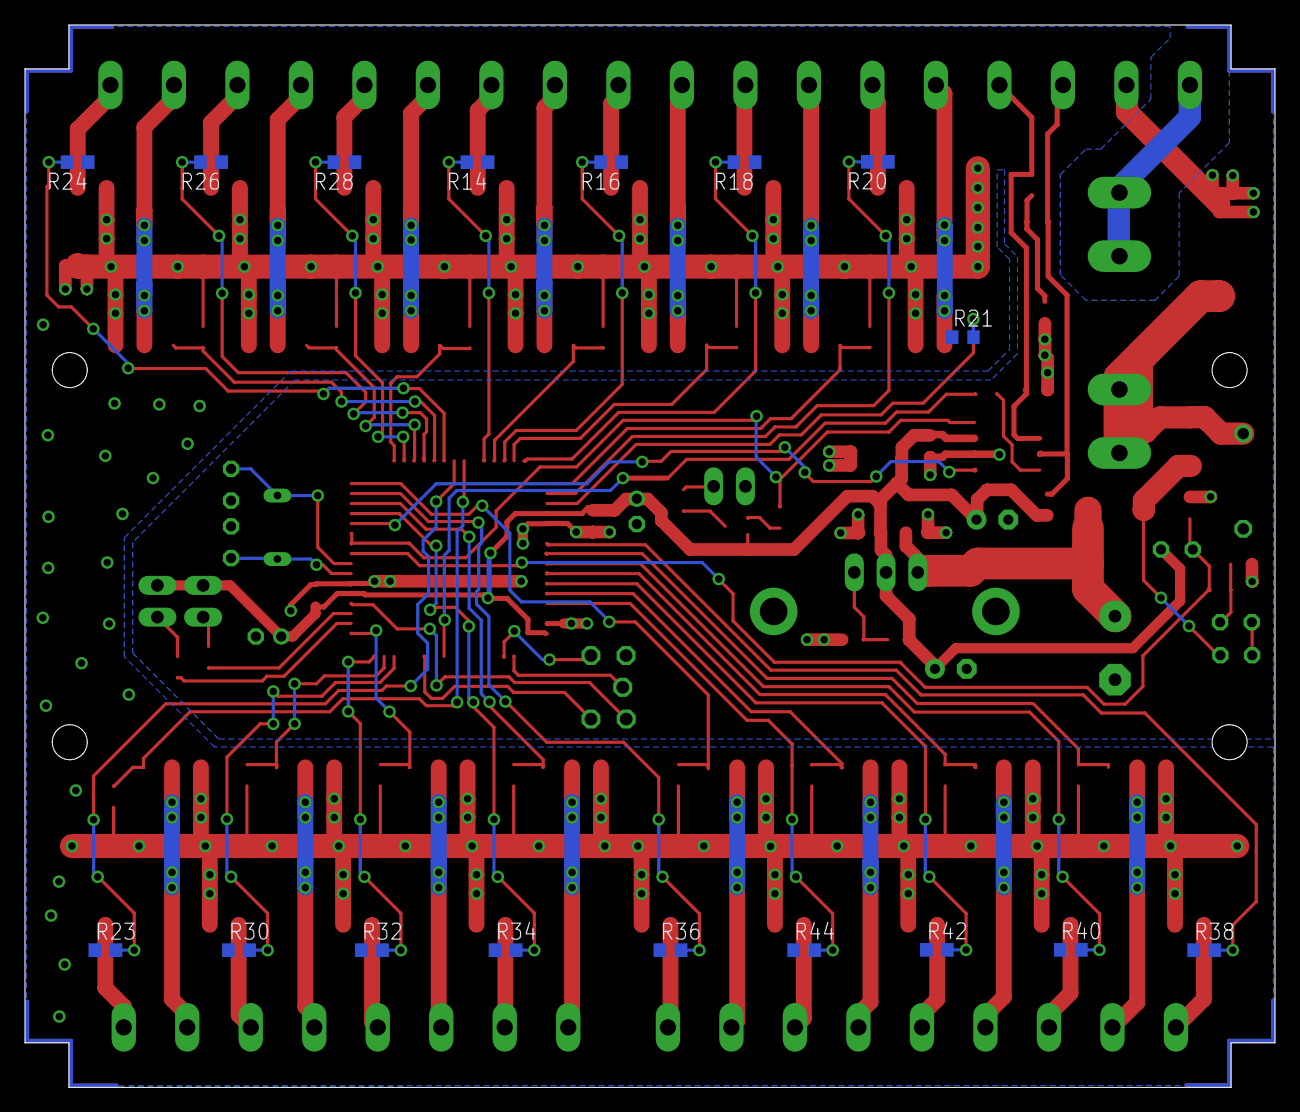
[picture p21: board do31.brd from below]

Board: 2 copper layers, 100.0 x 85.0 mm, 126 parts (17 on the bottom side), 92 nets.

Other parts of the board:
U$3: GEHÄUSE_MR6
