busmaster/homebus/hardware/smartmeterif/smartmeterif_2.brd

## EAGLE design hardware/smartmeterif/smartmeterif_2.brd (2022-07-30)

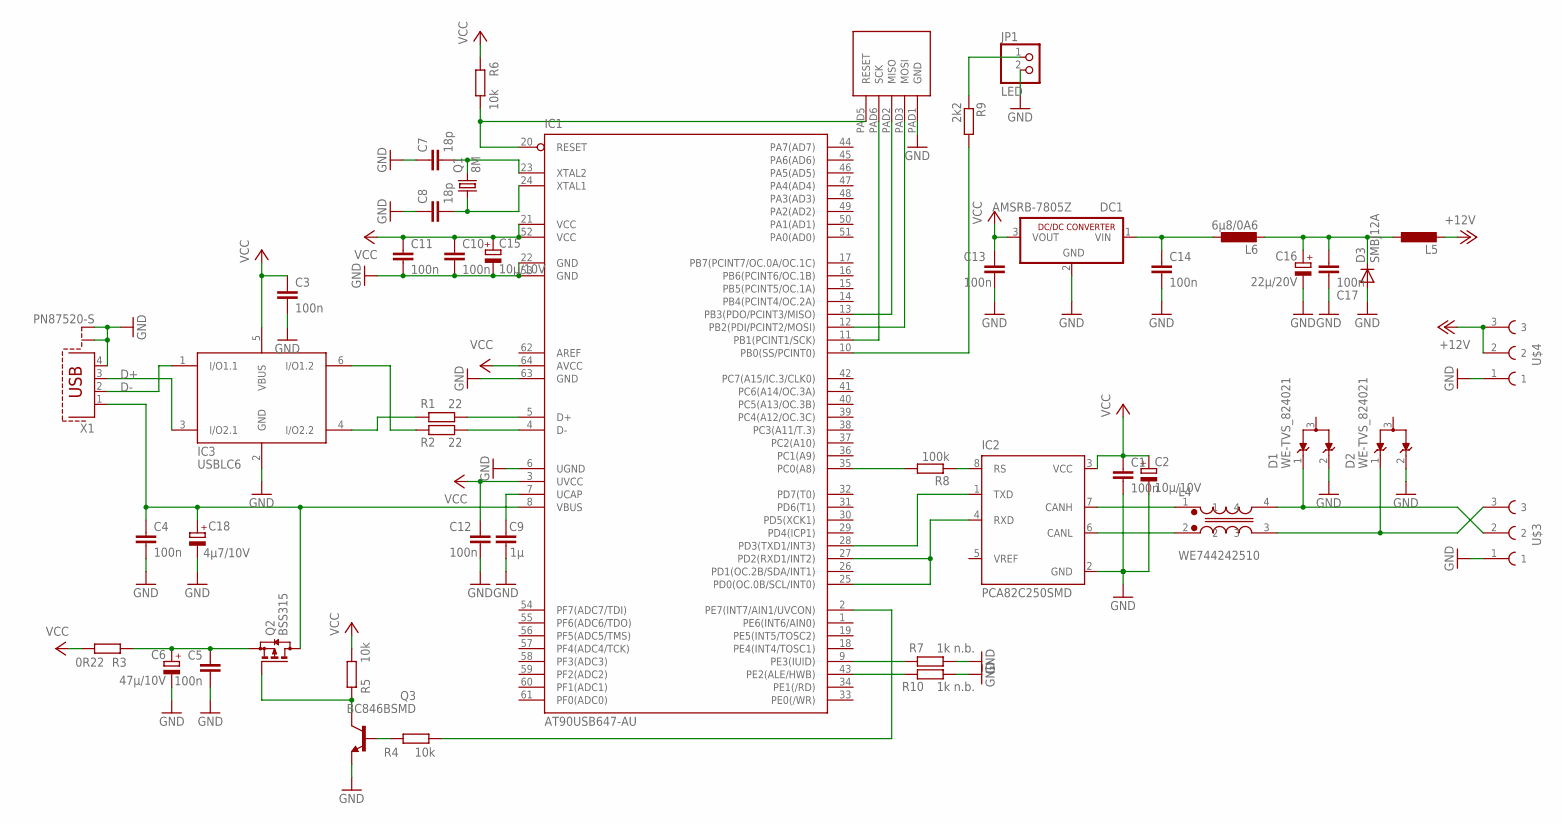
[picture p22: schematic smartmeterif_2.sch]

Parts:
C1, C3, C4, C5, C10, C11, C12, C13, C14, C17: 100n; C0603
C2, C15: 10µ/10V; A/3216-18W
C6: 47µ/10V; SMC_C
C7, C8: 18p; C0603
C9: 1µ; C1210K
C16: 22µ/20V; SMC_C
C18: 4µ7/10V; SMC_A
D1, D2: WE-TVS_824021; WE-TVS_SOT23-3L
D3: SMBJ12A; SMB
DC1: AMSRB-7805Z; SIP3
IC1: AT90USB647-AU; TQFP64
IC2: PCA82C250SMD; SO8
IC3: USBLC6; SOT23-6L
JP1: LED; 1X02
L4: WE744242510; WE-SLM
L5: L-EUL1806; L1806
L6: 6µ8/0A6; L1812
Q1: 8M; SM49
Q2: BSS315; SOT23
Q3: BC846BSMD; SOT23
R1, R2: 22; R0603
R3: 0R22; R0603
R4, R5, R6: 10k; R0603
R7, R10: 1k n.b.; R0603
R8: 100k; R0603
R9: 2k2; R0603
U$2: ATMEL_ISP
U$3, U$4: MKDSO_2.5/3_L; PHOENIX_MKDSO_2.5/3_L
X1: PN87520-S

Connections:
+12V: L5.2, U$4.2, U$4.3
.D+: IC3.4 (I/O2.2), R1.1
.D-: IC3.6 (I/O1.2), R2.1
B+: D1.1, L4.4, U$3.2
B-: D2.1, L4.3, U$3.3
D+: IC3.3 (I/O2.1), X1.3
D-: IC3.1 (I/O1.1), X1.2
GND: C1.2, C2.-, C3.2, C4.2, C5.2, C6.-, C7.1, C8.1, C9.1, C10.2, C11.2, C12.2, C13.2, C14.2, C15.-, C16.-, C17.2, C18.-, D1.2, D2.2, D3.A, DC1.2 (GND), IC1.6 (UGND), IC1.22 (GND), IC1.53 (GND), IC1.63 (GND), IC2.2 (GND), IC3.2 (GND), JP1.2, Q3.2 (E), R7.2, R10.2, U$2.PAD1 (GND), U$3.1, U$4.1, X1.4, X1.S1, X1.S2
unnamed: IC1.5 (D+), R1.2
unnamed: IC1.4 (D-), R2.2
unnamed: C4.1, C18.+, IC1.8 (VBUS), Q2.3 (D), X1.1
unnamed: C5.1, C6.+, Q2.2 (S), R3.1
unnamed: IC1.2 (PE7(INT7/AIN1/UVCON)), R4.2
unnamed: IC2.7 (CANH), L4.1
unnamed: Q2.1 (G), Q3.3 (C), R5.1
unnamed: Q3.1 (B), R4.1
unnamed: IC1.10 (PB0(SS/PCINT0)), R9.2
unnamed: JP1.1, R9.1
unnamed: IC1.35 (PC0(A8)), R8.2
unnamed: IC1.28 (PD3(TXD1/INT3)), IC2.1 (TXD)
unnamed: IC2.6 (CANL), L4.2
unnamed: IC1.25 (PD0(OC.0B/SCL/INT0)), IC1.27 (PD2(RXD1/INT2)), IC2.4 (RXD)
unnamed: IC1.43 (PE2(ALE/HWB)), R10.1
unnamed: IC1.20 (RESET), R6.2, U$2.PAD5 (RESET)
unnamed: IC1.11 (PB1(PCINT1/SCK)), U$2.PAD6 (SCK)
unnamed: IC1.12 (PB2(PDI/PCINT2/MOSI)), U$2.PAD3 (MOSI)
unnamed: IC1.13 (PB3(PDO/PCINT3/MISO)), U$2.PAD2 (MISO)
unnamed: C7.2, IC1.23 (XTAL2), Q1.2
unnamed: C8.2, IC1.24 (XTAL1), Q1.1
unnamed: C9.2, IC1.7 (UCAP)
unnamed: IC2.8 (RS), R8.1
unnamed: C16.+, C17.1, D3.C, L5.1, L6.2
unnamed: C14.1, DC1.1 (VIN), L6.1
unnamed: IC1.9 (PE3(IUID)), R7.1
VCC: C1.1, C2.+, C3.1, C10.1, C11.1, C12.1, C13.1, C15.+, DC1.3 (VOUT), IC1.3 (UVCC), IC1.21 (VCC), IC1.52 (VCC), IC1.64 (AVCC), IC2.3 (VCC), IC3.5 (VBUS), R3.2, R5.2, R6.1

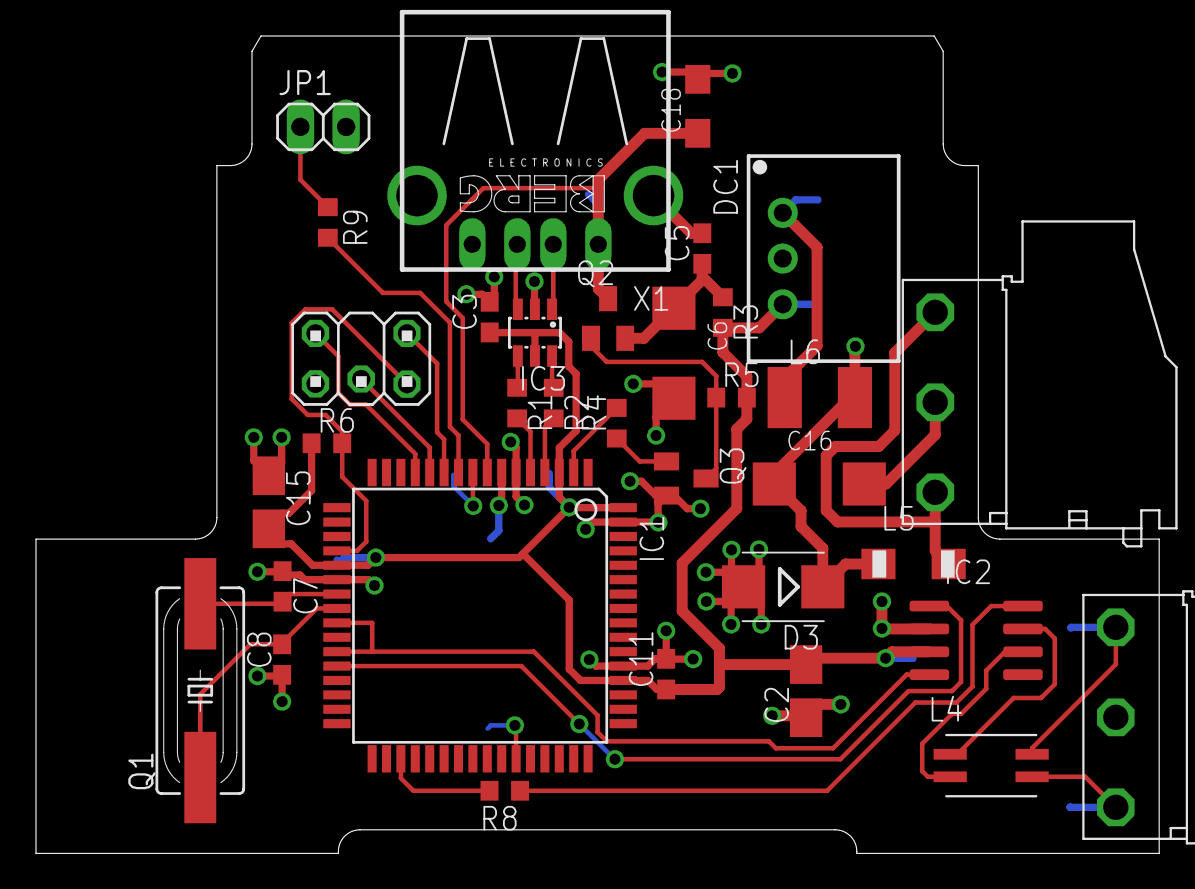
[picture p23: board smartmeterif_2.brd from above]

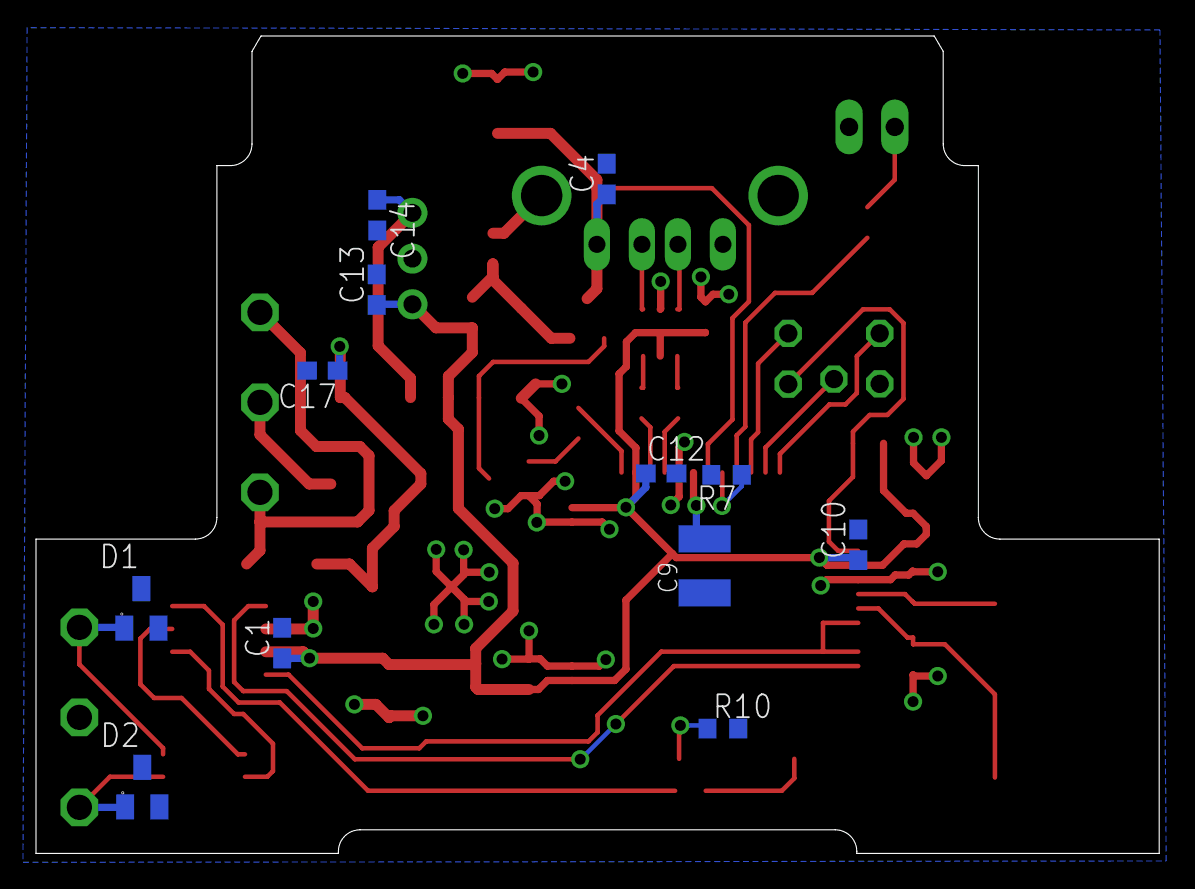
[picture p24: board smartmeterif_2.brd from below]

Board: 2 copper layers, 62.4 x 45.4 mm, 47 parts (12 on the bottom side), 35 nets.

Other parts of the board:
U$5: GEHÄUSE_PHOENIX_BC_17.8_REDUCED_REDUCED
