busmaster/homebus/hardware/stoveguard/stoveguard.brd

## EAGLE design hardware/stoveguard/stoveguard.brd (2021-12-08)

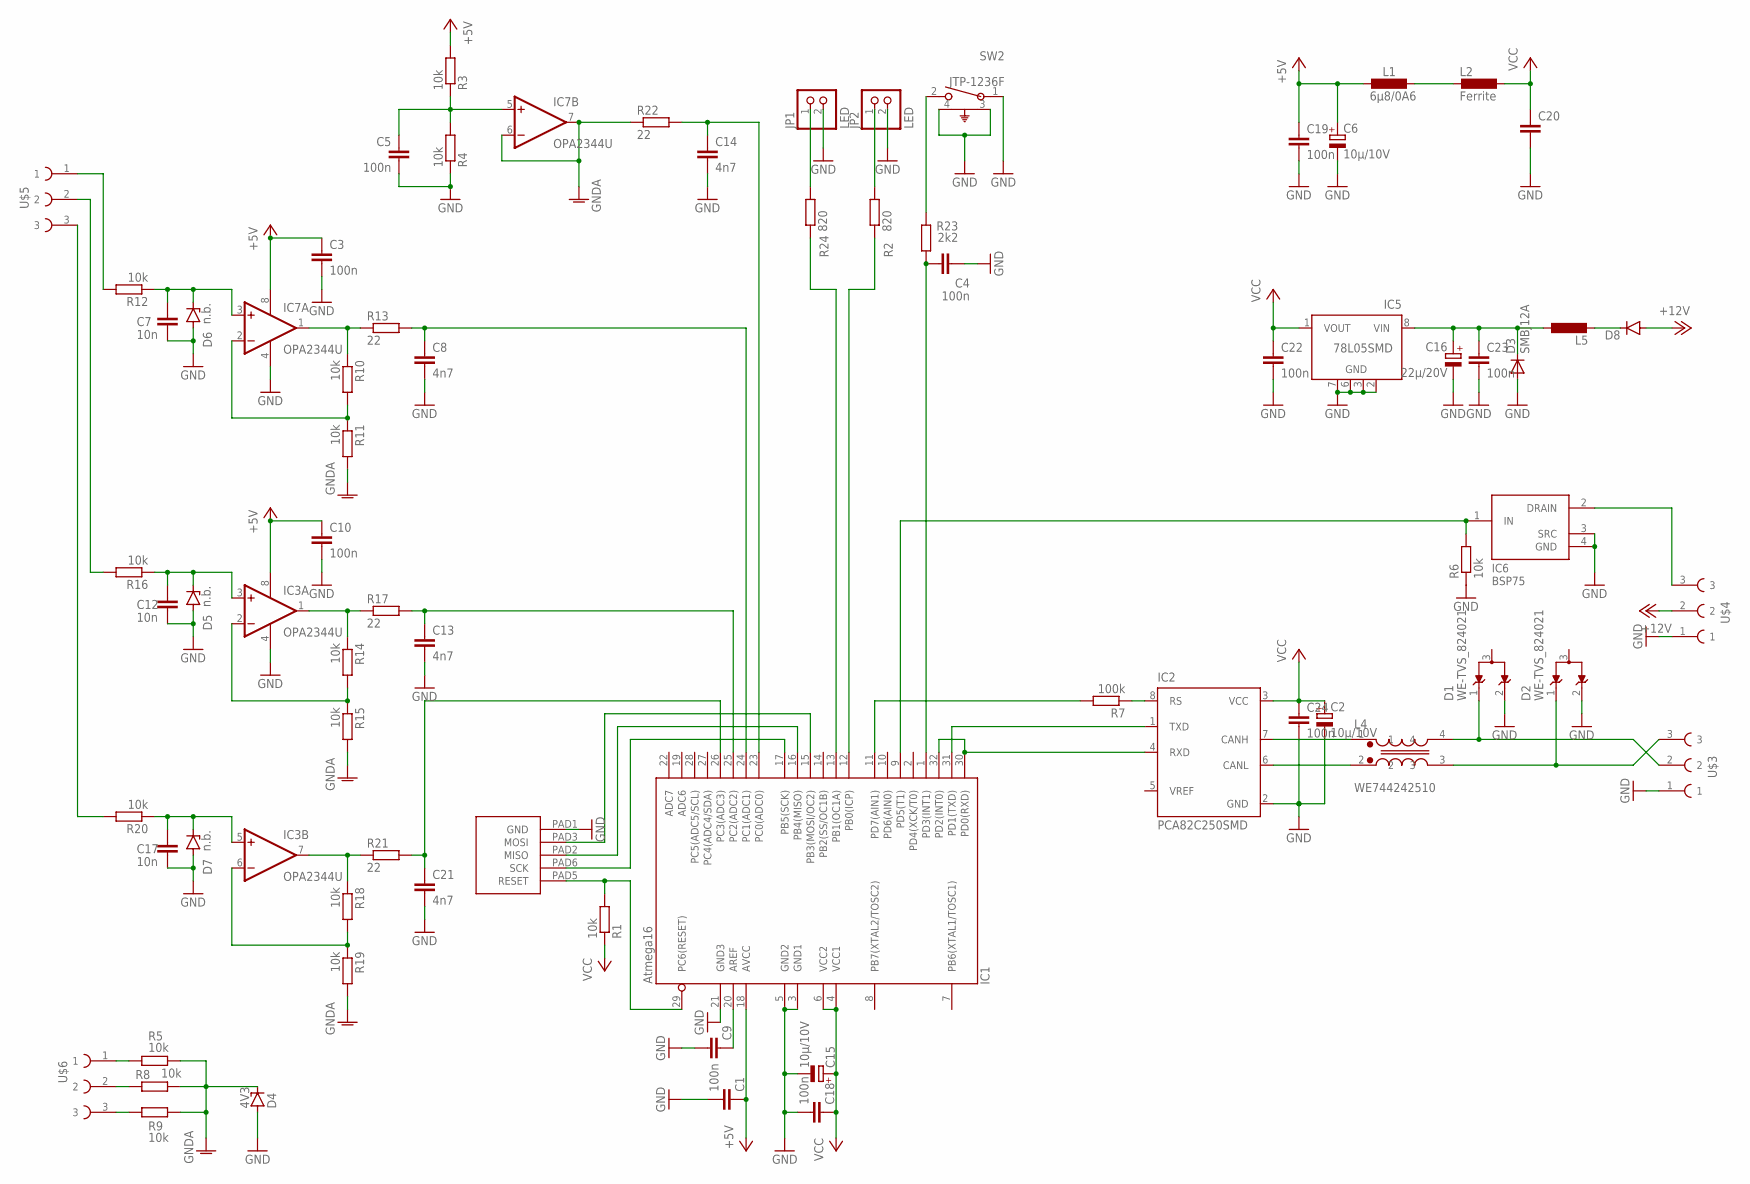
[picture p25: schematic stoveguard.sch]

Parts:
C1, C3, C4, C5, C10, C18, C19, C22, C23, C24: 100n; C0603
C2, C6, C15: 10µ/10V; A/3216-18W
C7, C12, C17: 10n; C0603
C8, C13, C14, C21: 4n7; C0603
C9: CC1206; C1206
C16: 22µ/20V; SMC_C
C20: CC0603; C0603
D1, D2: WE-TVS_824021; WE-TVS_SOT23-3L
D3: SMBJ12A; SMB
D4: 4V3; SOD80C
D5, D6, D7: n.b.; SOD80C
D8: DIODE-MINIMELF; MINIMELF
IC1: Atmega16; TQFP32-08
IC2: PCA82C250SMD; SO8
IC3, IC7: OPA2344U; SO08
IC5: 78L05SMD; SO08
IC6: BSP75; SOT223
JP1, JP2: LED; 1X02
L1: 6µ8/0A6; L1812
L2: Ferrite; L1806
L4: WE744242510; WE-SLM
L5: L-EUL1806; L1806
R1, R3, R4, R5, R6, R8, R9, R10, R11, R12, R14, R15, R16, R18, R19, R20: 10k; R0603
R2, R24: 820; R0603
R7: 100k; R0603
R13, R17, R21, R22: 22; R0603
R23: 2k2; R0603
SW2: JTP-1236F; SW2_1825027-E
U$2: ATMEL_ISP
U$3, U$4: MKDSO_2.5/3_L; PHOENIX_MKDSO_2.5/3_L
U$5, U$6: MKDSO_2.5/3_R; PHOENIX_MKDSO_2.5/3_R

Connections:
+5V: C1.1, C3.1, C6.+, C10.1, C19.1, IC1.18 (AVCC), IC3.8 (V+), IC7.8 (V+), L1.2, R3.2
+12V: D8.A, U$4.2
B+: D1.1, L4.4, U$3.2
B-: D2.1, L4.3, U$3.3
GND: C1.2, C2.-, C3.2, C4.1, C5.2, C6.-, C7.2, C8.2, C9.2, C10.2, C12.2, C13.2, C14.2, C15.-, C16.-, C17.2, C18.2, C19.2, C20.2, C21.2, C22.2, C23.2, C24.2, D1.2, D2.2, D3.A, D4.A, D5.A, D6.A, D7.A, IC1.3 (GND1), IC1.5 (GND2), IC1.21 (GND3), IC2.2 (GND), IC3.4 (V-), IC5.2 (GND), IC5.3 (GND), IC5.6 (GND), IC5.7 (GND), IC6.3 (SRC), IC6.4 (GND), IC7.4 (V-), JP1.2, JP2.2, R4.1, R6.1, SW2.1, SW2.3, SW2.4, U$2.PAD1 (GND), U$3.1, U$4.1
GNDA: D4.C, IC7.6 (-IN), IC7.7 (OUT), R5.1, R8.1, R9.1, R11.2, R15.2, R19.2, R22.1
unnamed: L1.1, L2.2
unnamed: IC6.2 (DRAIN), U$4.3
unnamed: C9.1, IC1.20 (AREF)
unnamed: IC1.15 (PB3(MOSI/OC2)), U$2.PAD3 (MOSI)
unnamed: IC1.16 (PB4(MISO)), U$2.PAD2 (MISO)
unnamed: IC1.17 (PB5(SCK)), U$2.PAD6 (SCK)
unnamed: IC1.9 (PD5(T1)), IC6.1 (IN), R6.2
unnamed: R5.2, U$6.1
unnamed: C5.1, IC7.5 (+IN), R3.1, R4.2
unnamed: IC2.7 (CANH), L4.1
unnamed: R8.2, U$6.2
unnamed: R9.2, U$6.3
unnamed: JP1.1, R24.2
unnamed: IC1.12 (PB0(ICP)), R2.1
unnamed: IC1.11 (PD7(AIN1)), R7.2
unnamed: IC1.31 (PD1(TXD)), IC2.1 (TXD)
unnamed: IC2.6 (CANL), L4.2
unnamed: IC1.30 (PD0(RXD)), IC1.32 (PD2(INT0)), IC2.4 (RXD)
unnamed: R12.2, U$5.1
unnamed: IC1.29 (PC6(RESET)), R1.2, U$2.PAD5 (RESET)
unnamed: C7.1, D6.C, IC7.3 (+IN), R12.1
unnamed: IC7.2 (-IN), R10.2, R11.1
unnamed: IC7.1 (OUT), R10.1, R13.1
unnamed: C4.2, IC1.1 (PD3(INT1)), R23.2
unnamed: R23.1, SW2.2
unnamed: C8.1, IC1.24 (PC1(ADC1)), R13.2
unnamed: IC2.8 (RS), R7.1
unnamed: C16.+, C23.1, D3.C, IC5.8 (VIN), L5.1
unnamed: C12.1, D5.C, IC3.3 (+IN), R16.1
unnamed: IC3.2 (-IN), R14.2, R15.1
unnamed: IC3.1 (OUT), R14.1, R17.1
unnamed: C13.1, IC1.25 (PC2(ADC2)), R17.2
unnamed: R16.2, U$5.2
unnamed: C17.1, D7.C, IC3.5 (+IN), R20.1
unnamed: IC3.6 (-IN), R18.2, R19.1
unnamed: IC3.7 (OUT), R18.1, R21.1
unnamed: C21.1, IC1.26 (PC3(ADC3)), R21.2
unnamed: R20.2, U$5.3
unnamed: C14.1, IC1.23 (PC0(ADC0)), R22.2
unnamed: D8.C, L5.2
unnamed: IC1.13 (PB1(OC1A)), R24.1
unnamed: JP2.1, R2.2
VCC: C2.+, C15.+, C18.1, C20.1, C22.1, C24.1, IC1.4 (VCC1), IC1.6 (VCC2), IC2.3 (VCC), IC5.1 (VOUT), L2.1, R1.1

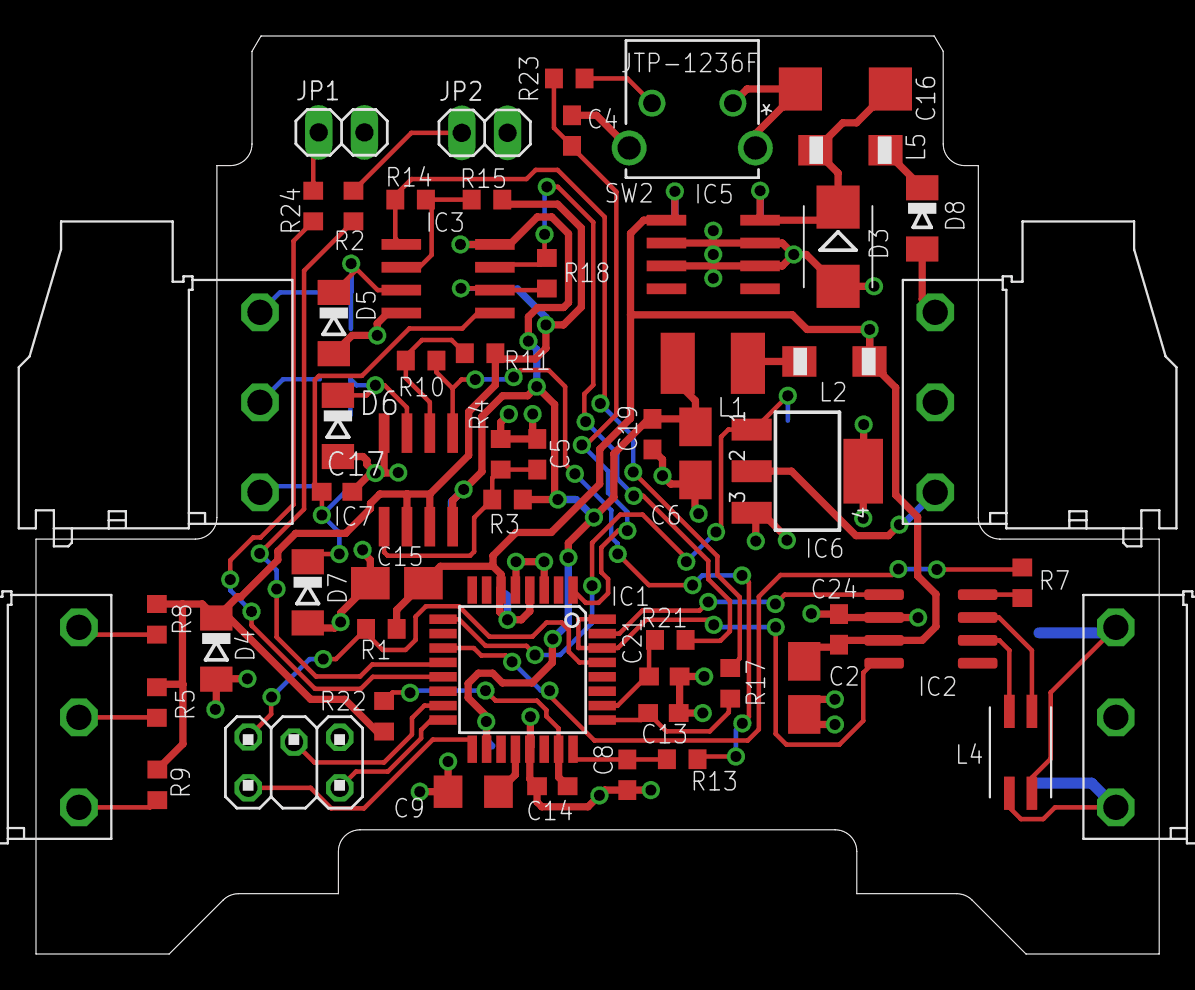
[picture p26: board stoveguard.brd from above]

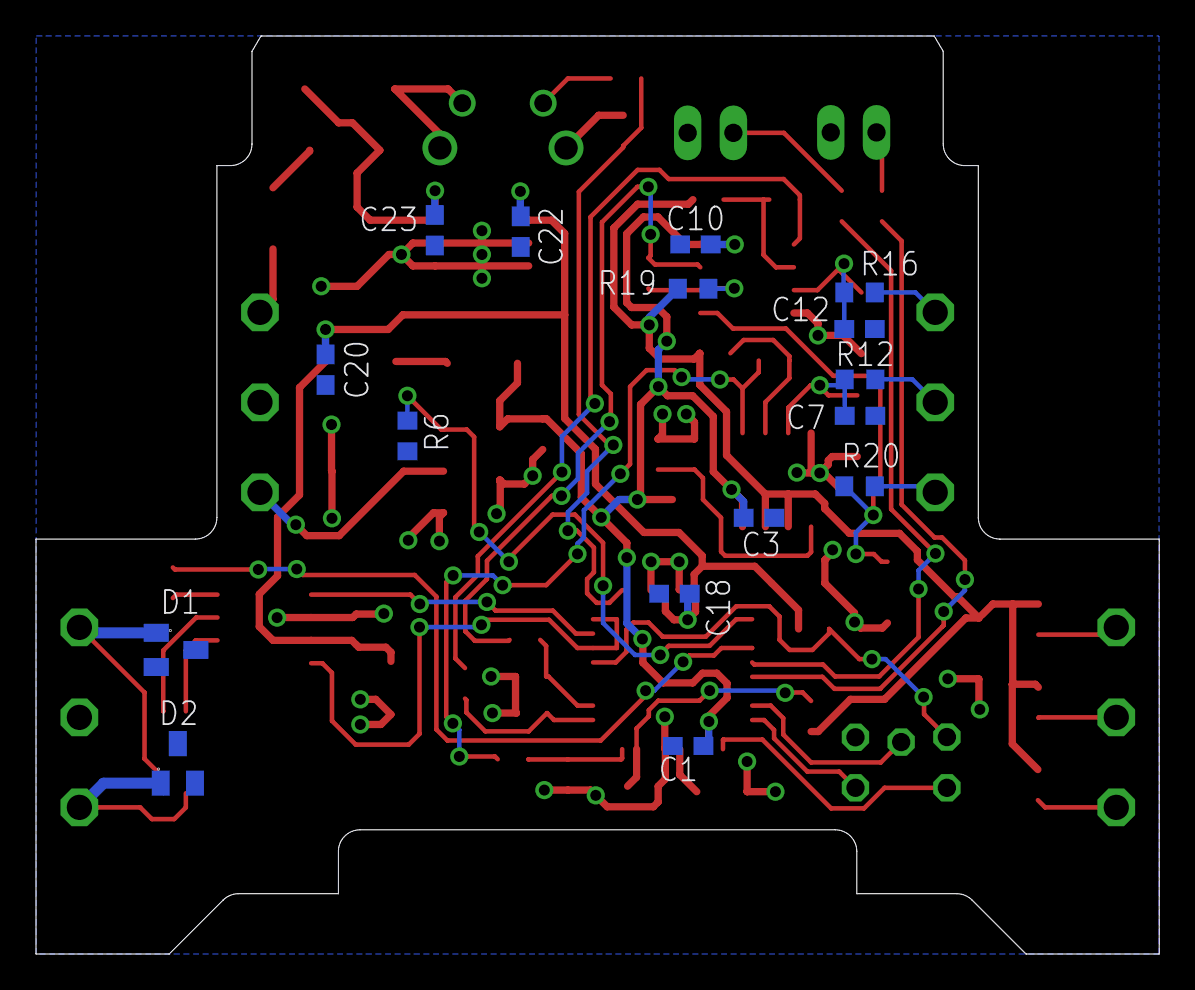
[picture p27: board stoveguard.brd from below]

Board: 2 copper layers, 62.4 x 51.0 mm, 74 parts (16 on the bottom side), 49 nets.

Other parts of the board:
U$7: GEHÄUSE_PHOENIX_BC_17.8_REDUCED
