busmaster/homebus/hardware/sw8/sw8.brd

## EAGLE design hardware/sw8/sw8.brd (2021-08-23)

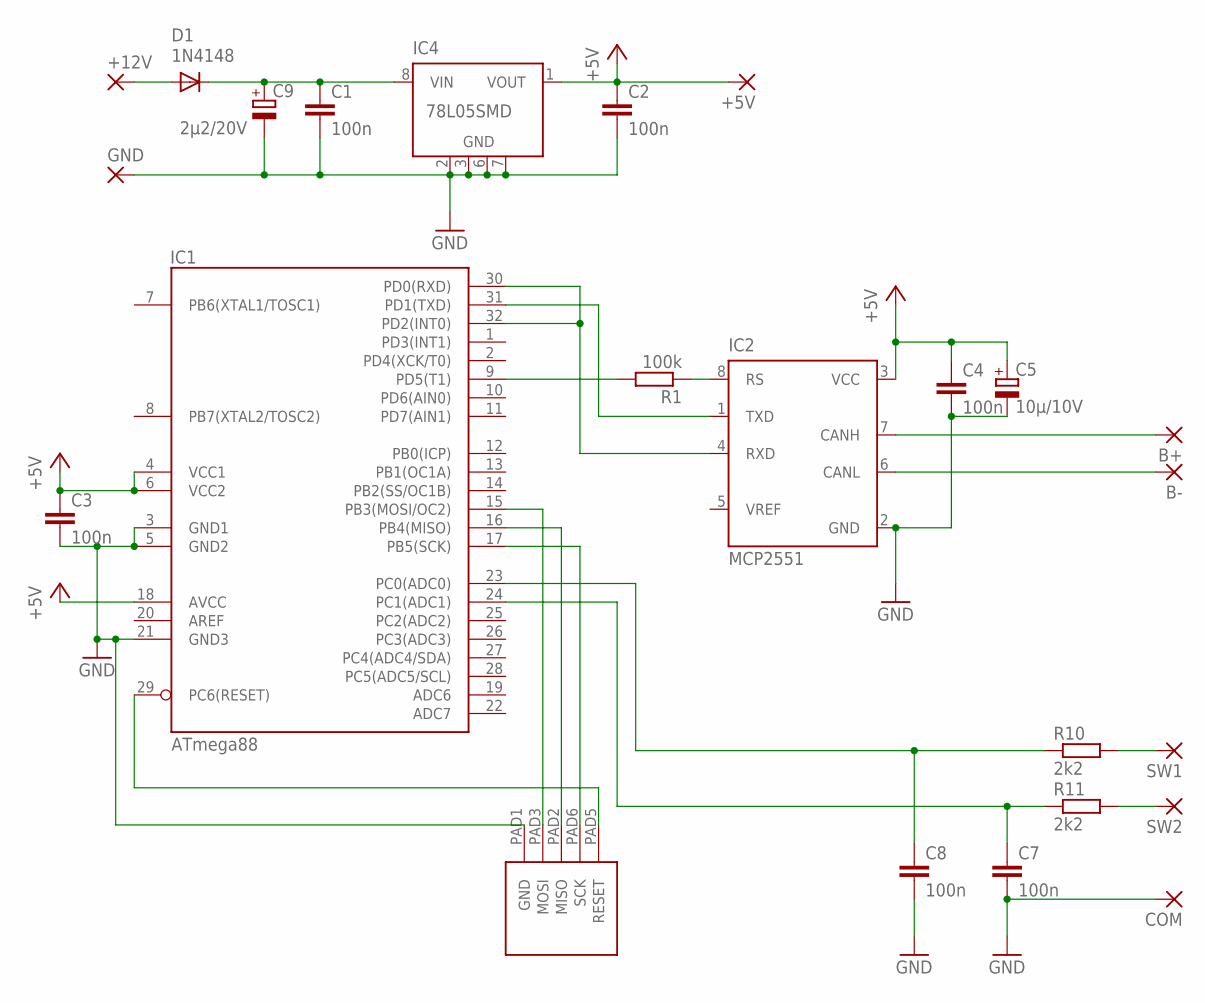
[picture p28: schematic sw8.sch]

Parts:
+5V, +12V: 1,6/0,8
B+: 1,6/0,8
B-: 1,6/0,8
C1, C2, C3, C4, C7, C8: 100n; C0603
C5: 10µ/10V; A/3216-18W
C9: 2µ2/20V; A/3216-18W
COM: 1,6/0,8
D1: 1N4148; SOD80C
GND: 1,6/0,8
IC1: ATmega88; TQFP32-08
IC2: MCP2551; SO8
IC4: 78L05SMD; SO08
R1: 100k; R0603
R10, R11: 2k2; R0603
SW1, SW2: 1,6/0,8
U$1: ATMEL_ISP

Connections:
+5V: +5V.1, C2.1, C3.1, C4.1, C5.+, IC1.4 (VCC1), IC1.6 (VCC2), IC1.18 (AVCC), IC2.3 (VCC), IC4.1 (VOUT)
AREF: IC1.20 (AREF)
GND: C1.2, C2.2, C3.2, C4.2, C5.-, C7.2, C8.2, C9.-, COM.1, GND.1, IC1.3 (GND1), IC1.5 (GND2), IC1.21 (GND3), IC2.2 (GND), IC4.2 (GND), IC4.3 (GND), IC4.6 (GND), IC4.7 (GND), U$1.PAD1 (GND)
MISO: IC1.16 (PB4(MISO)), U$1.PAD2 (MISO)
MOSI: IC1.15 (PB3(MOSI/OC2)), U$1.PAD3 (MOSI)
unnamed: B+.1, IC2.7 (CANH)
unnamed: B-.1, IC2.6 (CANL)
unnamed: IC1.31 (PD1(TXD)), IC2.1 (TXD)
unnamed: IC1.30 (PD0(RXD)), IC1.32 (PD2(INT0)), IC2.4 (RXD)
unnamed: IC2.8 (RS), R1.1
unnamed: IC1.9 (PD5(T1)), R1.2
unnamed: C1.1, C9.+, D1.C, IC4.8 (VIN)
unnamed: C7.1, IC1.24 (PC1(ADC1)), R11.1
unnamed: C8.1, IC1.23 (PC0(ADC0)), R10.1
unnamed: +12V.1, D1.A
unnamed: R10.2, SW1.1
unnamed: R11.2, SW2.1
RESET: IC1.29 (PC6(RESET)), U$1.PAD5 (RESET)
SCK: IC1.17 (PB5(SCK)), U$1.PAD6 (SCK)

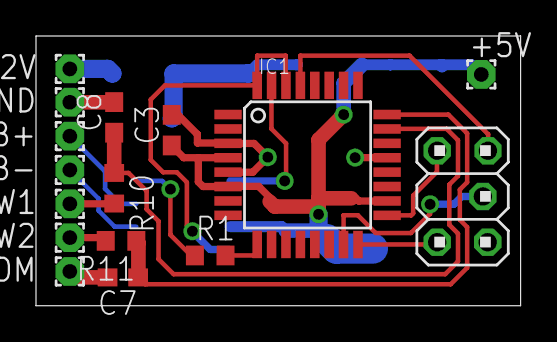
[picture p29: board sw8.brd from above]

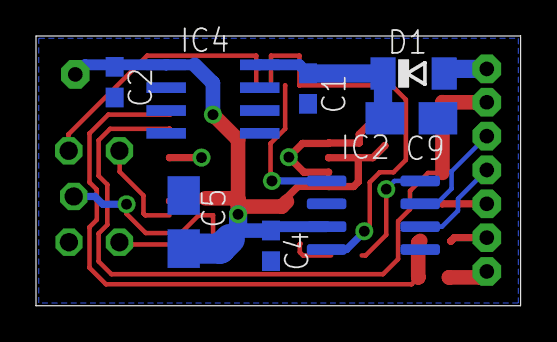
[picture p30: board sw8.brd from below]

Board: 2 copper layers, 26.9 x 15.0 mm, 24 parts (8 on the bottom side), 18 nets.
