busmaster/homebus/hardware/cff3100if/cff3100if.brd

## EAGLE design hardware/cff3100if/cff3100if.brd (2021-08-23)

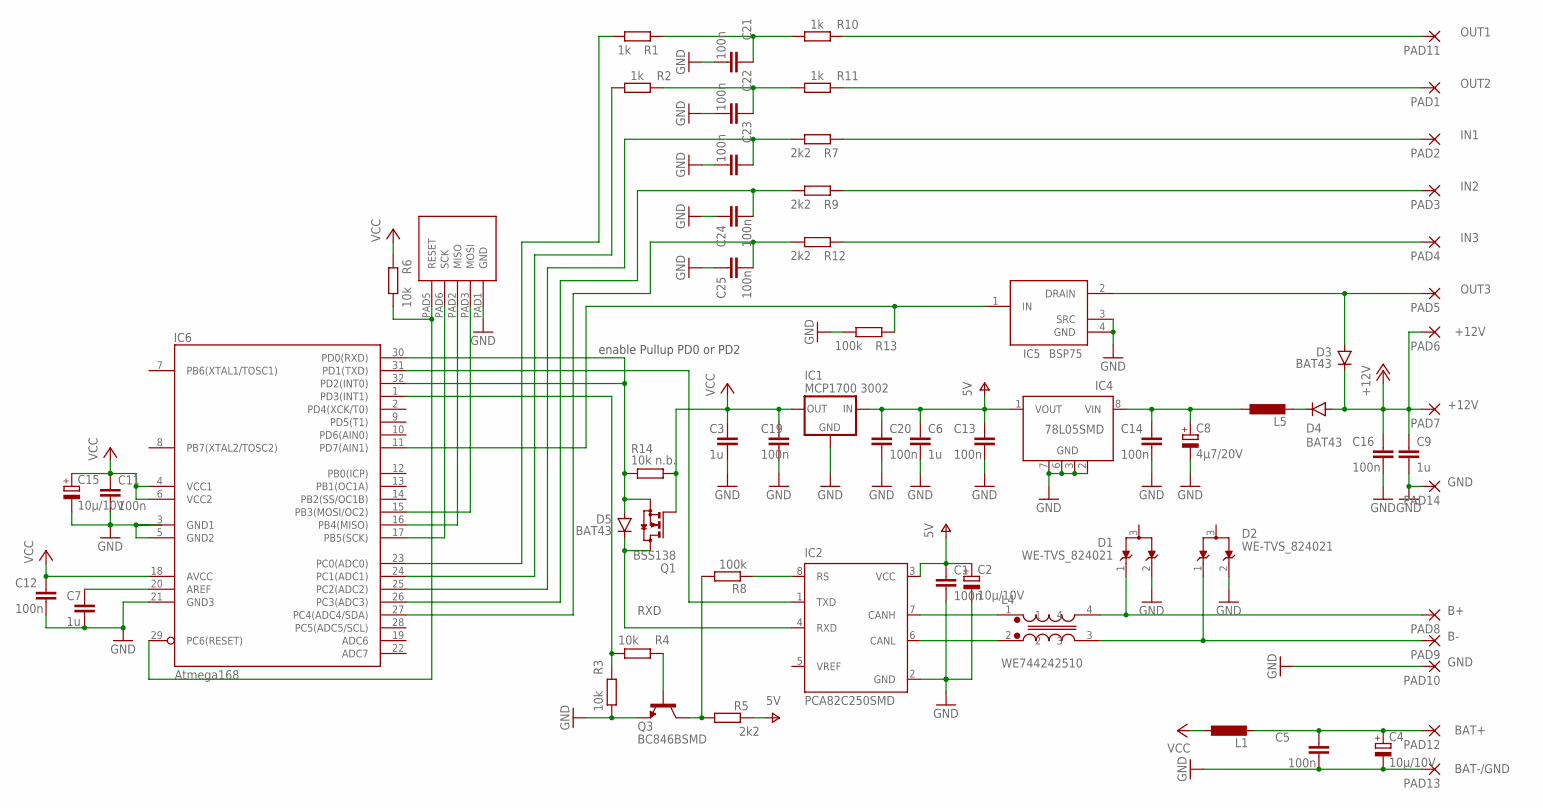
[picture p31: schematic cff3100if.sch]

Parts:
C1, C5, C11, C12, C13, C14, C16, C19, C20, C21, C22, C23, C24, C25: 100n; C0603
C2, C4, C15: 10µ/10V; A/3216-18W
C3, C6, C7, C9: 1u; C1206
C8: 4µ7/20V; A/3216-18W
D1, D2: WE-TVS_824021; WE-TVS_SOT23-3L
D3, D4, D5: BAT43; MINIMELF
IC1: MCP1700 3002; SOT23
IC2: PCA82C250SMD; SO8
IC4: 78L05SMD; SO08
IC5: BSP75; SOT223
IC6: Atmega168; TQFP32-08
L1, L5: L-EUL1806; L1806
L4: WE744242510; WE-SLM
PAD1, PAD2, PAD3, PAD4, PAD5, PAD7, PAD8, PAD9, PAD10, PAD11, PAD14: 1,6/0,9
PAD6: +12V; 1,6/0,9
PAD12: BAT+; 1,6/0,9
PAD13: BAT-/GND; 1,6/0,9
Q1: BSS138; SOT23
Q3: BC846BSMD; SOT23
R1, R2, R10, R11: 1k; R0603
R3, R4, R6: 10k; R0603
R5, R7, R9, R12: 2k2; R0603
R8, R13: 100k; R0603
R14: 10k n.b.; R0603
U$2: ATMEL_ISP

Connections:
+12V: C9.1, C16.1, D3.C, D4.A, PAD6.1, PAD7.1
B+: D1.1, L4.4, PAD8.1
B-: D2.1, L4.3, PAD9.1
GND: C1.2, C2.-, C3.2, C4.-, C5.2, C6.2, C7.2, C8.-, C9.2, C11.2, C12.2, C13.2, C14.2, C15.-, C16.2, C19.2, C20.2, C21.2, C22.2, C23.2, C24.1, C25.1, D1.2, D2.2, IC1.1 (GND), IC2.2 (GND), IC4.2 (GND), IC4.3 (GND), IC4.6 (GND), IC4.7 (GND), IC5.3 (SRC), IC5.4 (GND), IC6.3 (GND1), IC6.5 (GND2), IC6.21 (GND3), PAD10.1, PAD13.1, PAD14.1, Q3.2 (E), R3.2, R13.2, U$2.PAD1 (GND)
IN1: PAD2.1, R7.1
IN2: PAD3.1, R9.1
IN3: PAD4.1, R12.1
unnamed: IC6.29 (PC6(RESET)), R6.2, U$2.PAD5 (RESET)
unnamed: C4.+, C5.1, L1.2, PAD12.1
unnamed: IC6.1 (PD3(INT1)), R3.1, R4.2
unnamed: D4.C, L5.2
unnamed: IC6.23 (PC0(ADC0)), R1.2
unnamed: IC6.24 (PC1(ADC1)), R2.2
unnamed: C21.1, R1.1, R10.2
unnamed: C22.1, R2.1, R11.2
unnamed: IC2.7 (CANH), L4.1
unnamed: Q3.3 (C), R5.1, R8.2
unnamed: Q3.1 (B), R4.1
unnamed: C23.1, IC6.25 (PC2(ADC2)), R7.2
unnamed: C24.2, IC6.26 (PC3(ADC3)), R9.2
unnamed: C25.2, IC6.27 (PC4(ADC4/SDA)), R12.2
unnamed: IC2.1 (TXD), IC6.31 (PD1(TXD))
unnamed: IC2.6 (CANL), L4.2
unnamed: D5.A, IC6.30 (PD0(RXD)), IC6.32 (PD2(INT0)), Q1.2 (S), R14.2
unnamed: IC5.1 (IN), IC6.11 (PD7(AIN1)), R13.1
unnamed: IC6.17 (PB5(SCK)), U$2.PAD6 (SCK)
unnamed: IC6.15 (PB3(MOSI/OC2)), U$2.PAD3 (MOSI)
unnamed: IC6.16 (PB4(MISO)), U$2.PAD2 (MISO)
unnamed: C7.1, IC6.20 (AREF)
unnamed: IC2.8 (RS), R8.1
unnamed: C8.+, C14.1, IC4.8 (VIN), L5.1
OUT1: PAD11.1, R10.1
OUT2: PAD1.1, R11.1
OUT3: D3.A, IC5.2 (DRAIN), PAD5.1
RXD: D5.C, IC2.4 (RXD), Q1.3 (D)
V+: C1.1, C2.+, C6.1, C13.1, C20.1, IC1.3 (IN), IC2.3 (VCC), IC4.1 (VOUT), R5.2
VCC: C3.1, C11.1, C12.1, C15.+, C19.1, IC1.2 (OUT), IC6.4 (VCC1), IC6.6 (VCC2), IC6.18 (AVCC), L1.1, Q1.1 (G), R6.1, R14.1

Notes on the sheet:
enable Pullup PD0 or PD2

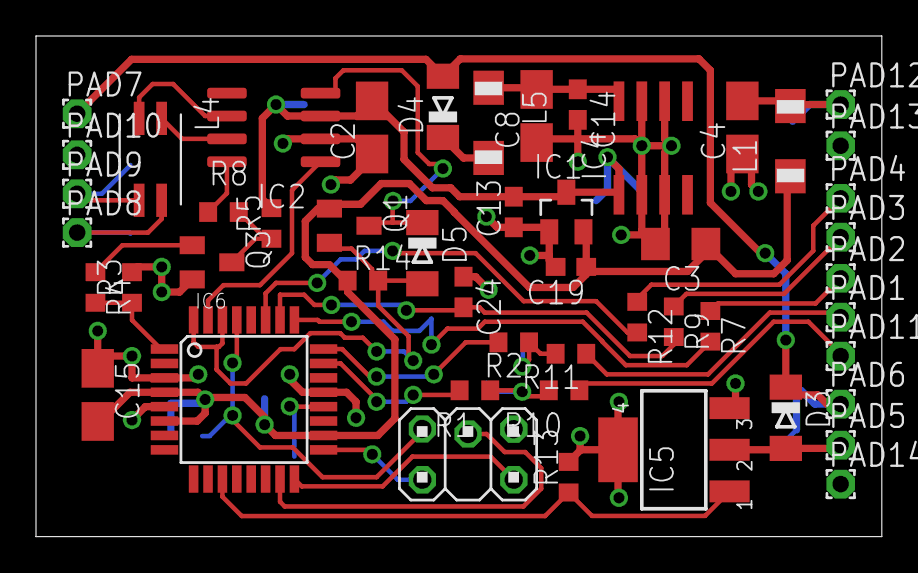
[picture p32: board cff3100if.brd from above]

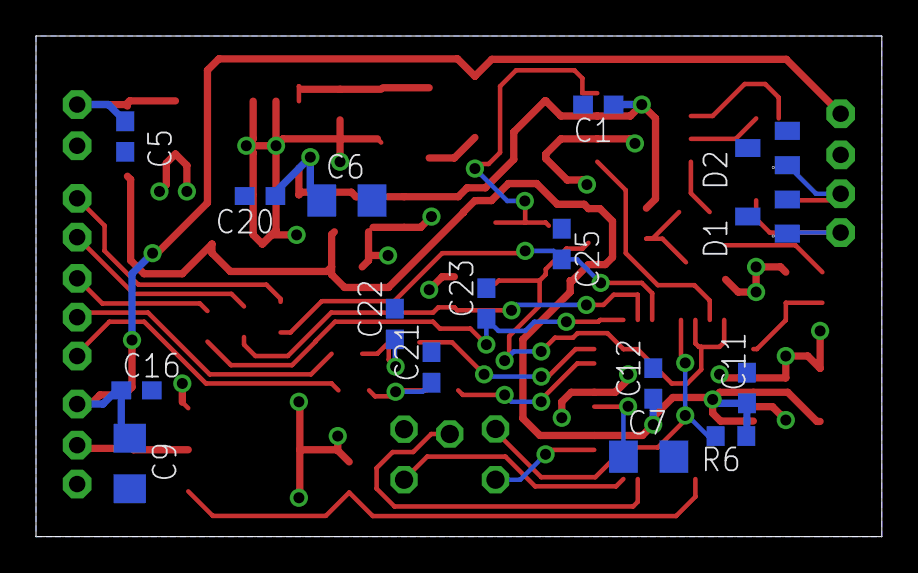
[picture p33: board cff3100if.brd from below]

Board: 2 copper layers, 47.0 x 27.8 mm, 66 parts (16 on the bottom side), 37 nets.
