busmaster/homebus/hardware/usbif/usbif3.brd

## EAGLE design hardware/usbif/usbif3.brd (2017-12-11)

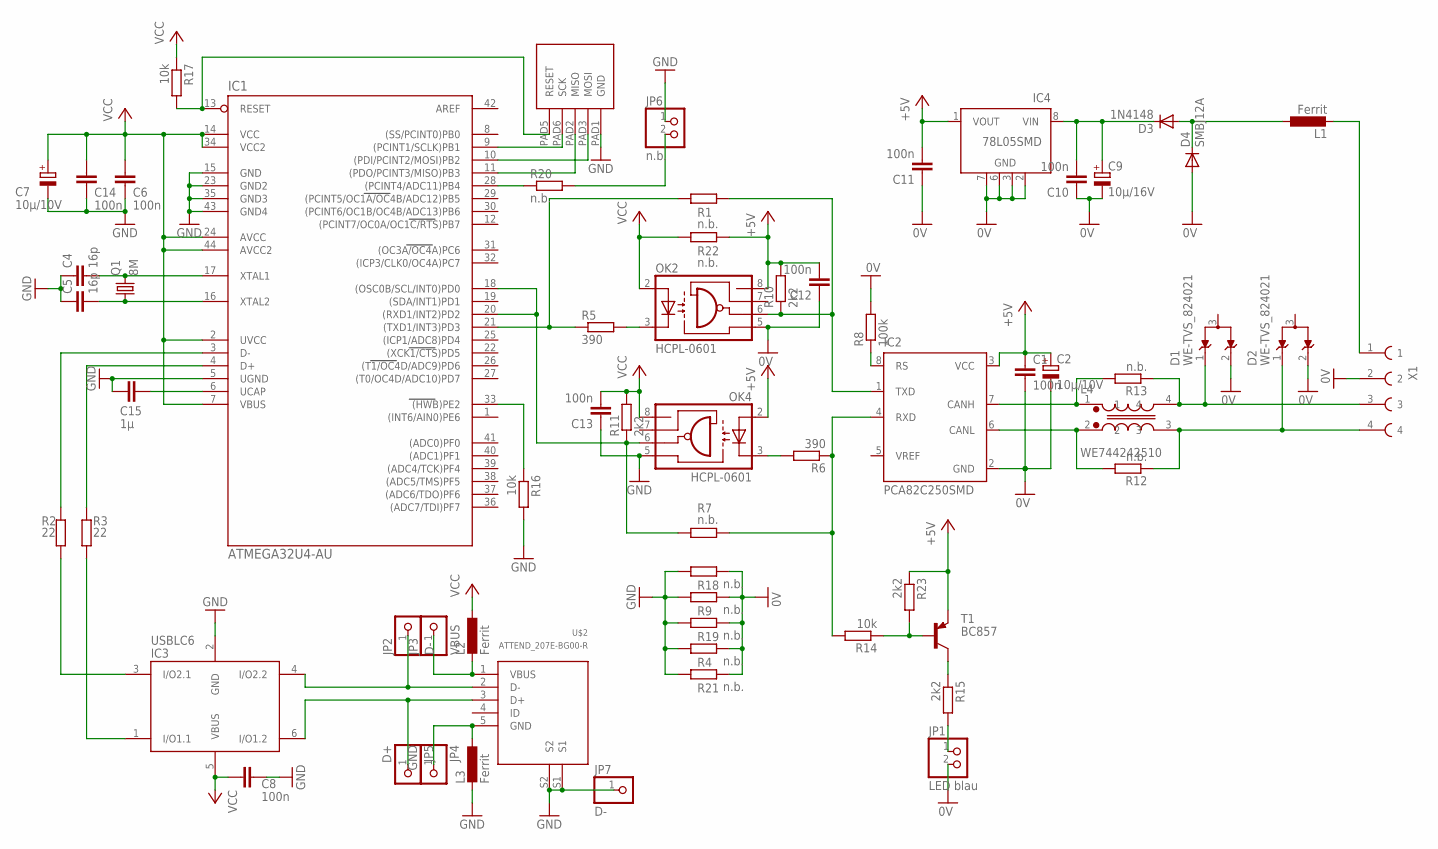
[picture p34: schematic usbif3.sch]

Parts:
C1, C6, C8, C10, C11, C12, C13, C14: 100n; C0603
C2, C7: 10µ/10V; A/3216-18W
C4, C5: 16p; C0603
C9: 10µ/16V; A/3216-18W
C15: 1µ; C1210K
D1, D2: WE-TVS_824021; WE-TVS_SOT23-3L
D3: 1N4148; SOD80C
D4: SMBJ12A; SMB
IC1: ATMEGA32U4-AU; TQFP44
IC2: PCA82C250SMD; SO8
IC3: USBLC6; SOT23-6L
IC4: 78L05SMD; SO08
JP1: LED blau; 1X02
JP2, JP7: D-; 1X01
JP3: VBUS; 1X01
JP4: GND; 1X01
JP5: D+; 1X01
JP6: n.b.; 1X02
L1, L2, L3: Ferrit; L1806
L4: WE744242510; WE-SLM
OK2, OK4: HCPL-0601; SOIC08
Q1: 8M; SM49
R1, R4, R7, R9, R18, R19, R21, R22: n.b.; MINI_MELF-0204R
R2, R3: 22; R0603
R5, R6: 390; R0603
R8: 100k; R0603
R10, R11, R15, R23: 2k2; R0603
R12, R13, R20: n.b.; R0603
R14, R16, R17: 10k; R0603
T1: BC857; SOT323-BEC
U$1: ATMEL_ISP
U$2: ATTEND_207E-BG00-R
X1: DEGSON_15EDGRC-3.5_4

Connections:
0V: C1.2, C2.-, C9.-, C10.1, C11.1, C12.1, D1.2, D2.2, D4.A, IC2.2 (GND), IC4.2 (GND), IC4.3 (GND), IC4.6 (GND), IC4.7 (GND), JP1.2, OK2.5 (GND), R4.1, R8.2, R9.1, R18.1, R19.1, R21.1, X1.2
#RESET: IC1.13 (RESET), R17.2, U$1.PAD5 (RESET)
+5V: C1.1, C2.+, C11.2, C12.2, IC2.3 (VCC), IC4.1 (VOUT), OK2.8 (VCC), OK4.2 (A), R10.2, R22.1, R23.1, T1.E
+12V: L1.2, X1.1
B+: D1.1, L4.4, R13.1, X1.3
B-: D2.1, L4.3, R12.1, X1.4
D+: IC3.6 (I/O1.2), JP5.1, U$2.3 (D+)
D-: IC3.4 (I/O2.2), JP2.1, U$2.2 (D-)
GND: C4.1, C5.1, C6.1, C7.-, C8.1, C13.1, C14.1, C15.2, IC1.5 (UGND), IC1.15 (GND), IC1.23 (GND2), IC1.35 (GND3), IC1.43 (GND4), IC3.2 (GND), JP6.1, JP7.1, L3.2, OK4.5 (GND), R4.2, R9.2, R16.2, R18.2, R19.2, R21.2, U$1.PAD1 (GND), U$2.S1, U$2.S2
unnamed: OK2.3 (C), R5.2
unnamed: IC1.18 ((OSC0B/SCL/INT0)PD0), IC1.20 ((RXD1/INT2)PD2), OK4.6 (VO), R7.2, R11.1
unnamed: IC2.1 (TXD), OK2.6 (VO), R1.1, R10.1
unnamed: IC2.4 (RXD), R6.1, R7.1, R14.2
unnamed: IC1.10 ((PDI/PCINT2/MOSI)PB2), U$1.PAD3 (MOSI)
unnamed: IC1.11 ((PDO/PCINT3/MISO)PB3), U$1.PAD2 (MISO)
unnamed: IC1.9 ((PCINT1/SCLK)PB1), U$1.PAD6 (SCK)
unnamed: IC1.4 (D+), R3.1
unnamed: IC2.7 (CANH), L4.1, R13.2
unnamed: C15.1, IC1.6 (UCAP)
unnamed: IC1.3 (D-), R2.1
unnamed: IC3.1 (I/O1.1), R3.2
unnamed: IC3.3 (I/O2.1), R2.2
unnamed: C4.2, IC1.17 (XTAL1), Q1.2
unnamed: C5.2, IC1.16 (XTAL2), Q1.1
unnamed: IC2.6 (CANL), L4.2, R12.2
unnamed: JP6.2, R20.2
unnamed: IC1.28 ((PCINT4/ADC11)PB4), R20.1
unnamed: D3.A, D4.C, L1.1
unnamed: C9.+, C10.2, D3.C, IC4.8 (VIN)
unnamed: OK4.3 (C), R6.2
unnamed: R15.1, T1.C
unnamed: IC1.33 ((HWB)PE2), R16.1
unnamed: R14.1, R23.2, T1.B
unnamed: JP1.1, R15.2
unnamed: IC2.8 (RS), R8.1
unnamed: JP4.1, L3.1, U$2.5 (GND)
unnamed: IC1.21 ((TXD1/INT3)PD3), R1.2, R5.1
VBUS: JP3.1, L2.2, U$2.1 (VBUS)
VCC: C6.2, C7.+, C8.2, C13.2, C14.2, IC1.2 (UVCC), IC1.7 (VBUS), IC1.14 (VCC), IC1.24 (AVCC), IC1.34 (VCC2), IC1.44 (AVCC2), IC3.5 (VBUS), L2.1, OK2.2 (A), OK4.8 (VCC), R11.2, R17.1, R22.2

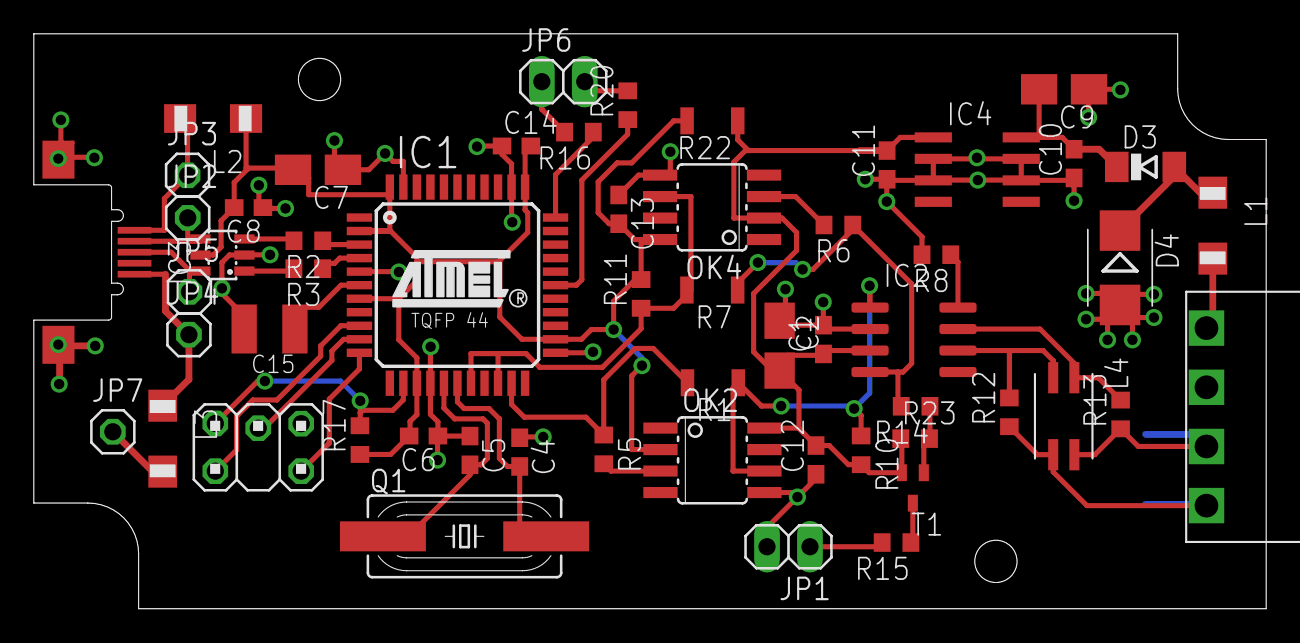
[picture p35: board usbif3.brd from above]

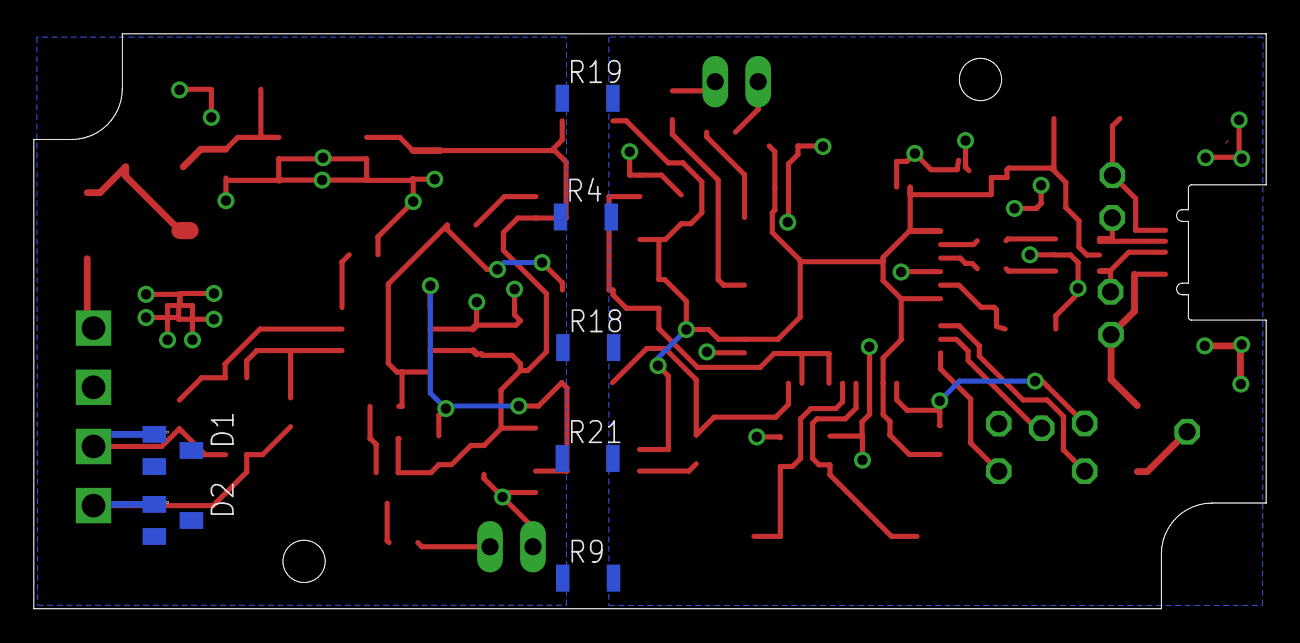
[picture p36: board usbif3.brd from below]

Board: 2 copper layers, 72.9 x 34.0 mm, 63 parts (7 on the bottom side), 39 nets.
