busmaster/homebus/hardware/pwm4/pwm4.brd

## EAGLE design hardware/pwm4/pwm4.brd (2016-10-24)

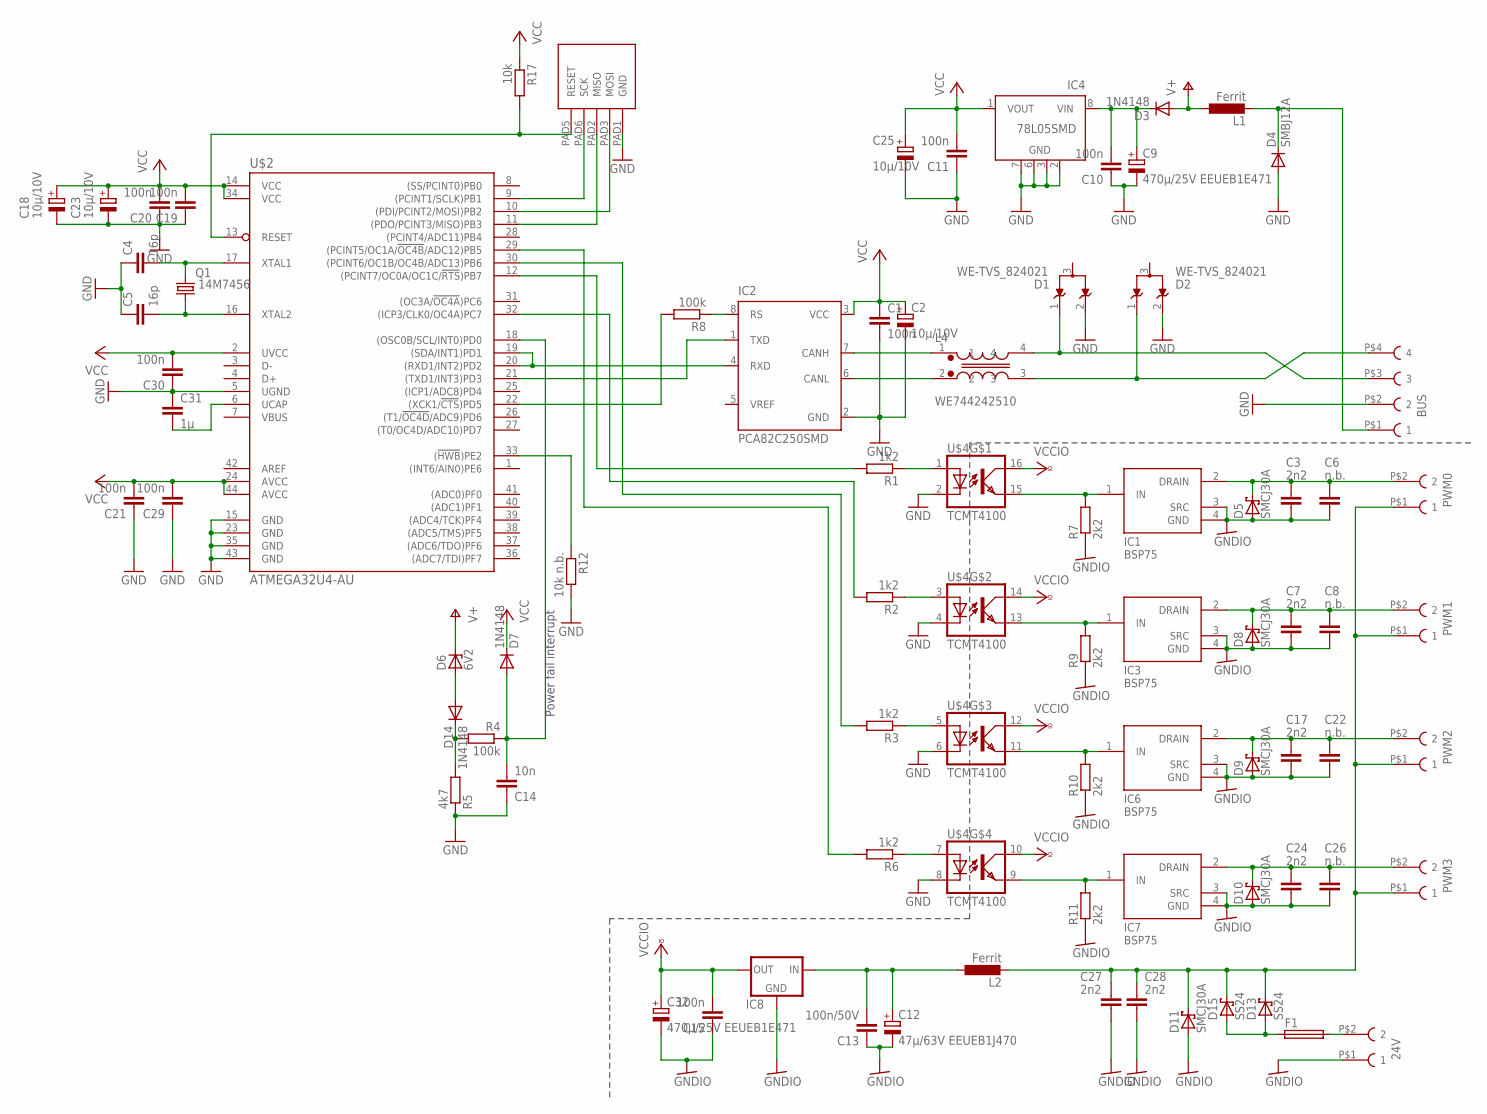
[picture p37: schematic pwm4.sch]

Parts:
24V: TBG-3.5-PW-2P
BUS: TBG-3.5-PW-4P
C1, C10, C11, C15, C19, C20, C21, C29, C30: 100n; C0603
C2, C18, C23, C25: 10µ/10V; A/3216-18W
C3, C7, C17, C24, C27, C28: 2n2; C025-040X050
C4, C5: 16p; C0603
C6, C8, C22, C26: n.b.; C025-040X050
C9, C32: 470µ/25V EEUEB1E471; E5-10,5
C12: 47µ/63V EEUEB1J470; E3,5-8
C13: 100n/50V; C0603
C14: 10n; C0603
C31: 1µ; C1210K
D1, D2: WE-TVS_824021; WE-TVS_SOT23-3L
D3, D7, D14: 1N4148; SOD80C
D4: SMBJ12A; SMB
D5, D8, D9, D10, D11: SMCJ30A; SMC
D6: 6V2; SOD80C
D13, D15: SS24; SMB
F1: SHK20L
IC1, IC3, IC6, IC7: BSP75; SOT223
IC2: PCA82C250SMD; SO8
IC4: 78L05SMD; SO08
IC8: 78XXS
L1, L2: Ferrit; L1806
L4: WE744242510; WE-SLM
PWM0, PWM1, PWM2, PWM3: TBG-3.5-PW-2P
Q1: 14M7456; SM49
R1, R2, R3, R6: 1k2; R0603
R4, R8: 100k; R0603
R5: 4k7; R0603
R7, R9, R10, R11: 2k2; R0603
R12: 10k n.b.; R0603
R17: 10k; R0603
U$1: ATMEL_ISP
U$2: ATMEGA32U4-AU; TQFP44
U$4: TCMT4100; SOIC16

Connections:
#RESET: R17.2, U$1.PAD5 (RESET), U$2.13 (RESET)
B+: BUS.P$3 (3), D1.1, L4.4
B-: BUS.P$4 (4), D2.1, L4.3
GND: BUS.P$2 (2), C1.2, C2.-, C4.1, C5.1, C9.-, C10.1, C11.1, C14.1, C18.-, C19.1, C20.1, C21.1, C23.-, C25.-, C29.1, C30.1, C31.1, D1.2, D2.2, D4.A, IC2.2 (GND), IC4.2 (GND), IC4.3 (GND), IC4.6 (GND), IC4.7 (GND), R5.1, R12.2, U$1.PAD1 (GND), U$2.5 (UGND), U$2.15 (GND), U$2.23 (GND), U$2.35 (GND), U$2.43 (GND), U$4.2 (C), U$4.4 (C), U$4.6 (C), U$4.8 (C)
GNDIO: 24V.P$1 (1), C3.1, C6.1, C7.1, C8.1, C12.-, C13.1, C15.1, C17.1, C22.1, C24.1, C26.1, C27.1, C28.1, C32.-, D5.A, D8.A, D9.A, D10.A, D11.A, IC1.3 (SRC), IC1.4 (GND), IC3.3 (SRC), IC3.4 (GND), IC6.3 (SRC), IC6.4 (GND), IC7.3 (SRC), IC7.4 (GND), IC8.GND, R7.1, R9.1, R10.1, R11.1
MISO: U$1.PAD2 (MISO), U$2.11 ((PDO/PCINT3/MISO)PB3)
MOSI: U$1.PAD3 (MOSI), U$2.10 ((PDI/PCINT2/MOSI)PB2)
unnamed: R8.2, U$2.22 ((XCK1/!CTS!)PD5)
unnamed: C3.2, C6.2, D5.C, IC1.2 (DRAIN), PWM0.P$2 (2)
unnamed: IC2.1 (TXD), U$2.21 ((TXD1/INT3)PD3)
unnamed: C9.+, C10.2, D3.C, IC4.8 (VIN)
unnamed: C7.2, C8.2, D8.C, IC3.2 (DRAIN), PWM1.P$2 (2)
unnamed: IC2.7 (CANH), L4.1
unnamed: R1.1, U$4.1 (A)
unnamed: IC2.4 (RXD), U$2.19 ((SDA/INT1)PD1), U$2.20 ((RXD1/INT2)PD2)
unnamed: C17.2, C22.2, D9.C, IC6.2 (DRAIN), PWM2.P$2 (2)
unnamed: C24.2, C26.2, D10.C, IC7.2 (DRAIN), PWM3.P$2 (2)
unnamed: C4.2, Q1.2, U$2.17 (XTAL1)
unnamed: C5.2, Q1.1, U$2.16 (XTAL2)
unnamed: IC2.6 (CANL), L4.2
unnamed: C12.+, C13.2, IC8.IN, L2.1
unnamed: C27.2, C28.2, D11.C, D13.C, D15.C, L2.2, PWM0.P$1 (1), PWM1.P$1 (1), PWM2.P$1 (1), PWM3.P$1 (1)
unnamed: BUS.P$1 (1), D4.C, L1.2
unnamed: 24V.P$2 (2), F1.2A
unnamed: D6.A, D14.A
unnamed: D13.A, D15.A, F1.1A
unnamed: R2.1, U$4.3 (A)
unnamed: R3.1, U$4.5 (A)
unnamed: R6.1, U$4.7 (A)
unnamed: IC2.8 (RS), R8.1
unnamed: D14.C, R4.2, R5.2
unnamed: IC1.1 (IN), R7.2, U$4.15 (EMIT)
unnamed: IC3.1 (IN), R9.2, U$4.13 (EMIT)
unnamed: IC6.1 (IN), R10.2, U$4.11 (EMIT)
unnamed: IC7.1 (IN), R11.2, U$4.9 (EMIT)
unnamed: C31.2, U$2.6 (UCAP)
unnamed: R12.1, U$2.33 ((!HWB!)PE2)
unnamed: C14.2, D7.A, R4.1, U$2.18 ((OSC0B/SCL/INT0)PD0)
PWM0: R1.2, U$2.12 ((PCINT7/OC0A/OC1C/!RTS!)PB7)
PWM1: R2.2, U$2.32 ((ICP3/CLK0/OC4A)PC7)
PWM2: R3.2, U$2.30 ((PCINT6/OC1B/OC4B/ADC13)PB6)
PWM3: R6.2, U$2.29 ((PCINT5/OC1A/!OC4B!/ADC12)PB5)
SCK: U$1.PAD6 (SCK), U$2.9 ((PCINT1/SCLK)PB1)
V+: D3.A, D6.C, L1.1
VCC: C1.1, C2.+, C11.2, C18.+, C19.2, C20.2, C21.2, C23.+, C25.+, C29.2, C30.2, D7.C, IC2.3 (VCC), IC4.1 (VOUT), R17.1, U$2.2 (UVCC), U$2.14 (VCC), U$2.24 (AVCC), U$2.34 (VCC), U$2.44 (AVCC)
VCCIO: C15.2, C32.+, IC8.OUT, U$4.10 (COL), U$4.12 (COL), U$4.14 (COL), U$4.16 (COL)

Notes on the sheet:
Power fail interrupt

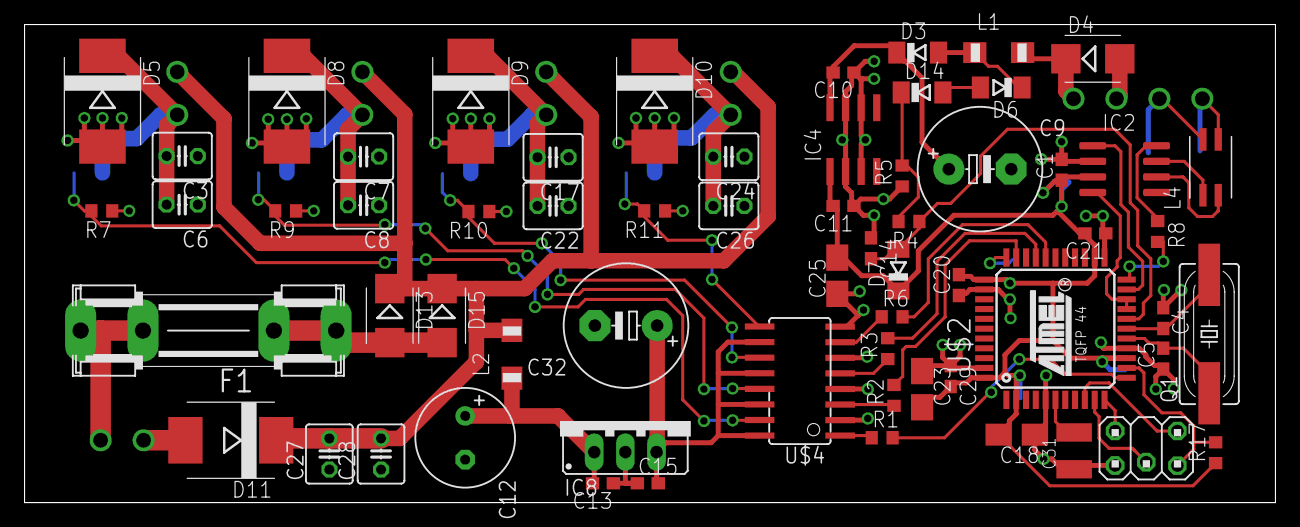
[picture p38: board pwm4.brd from above]

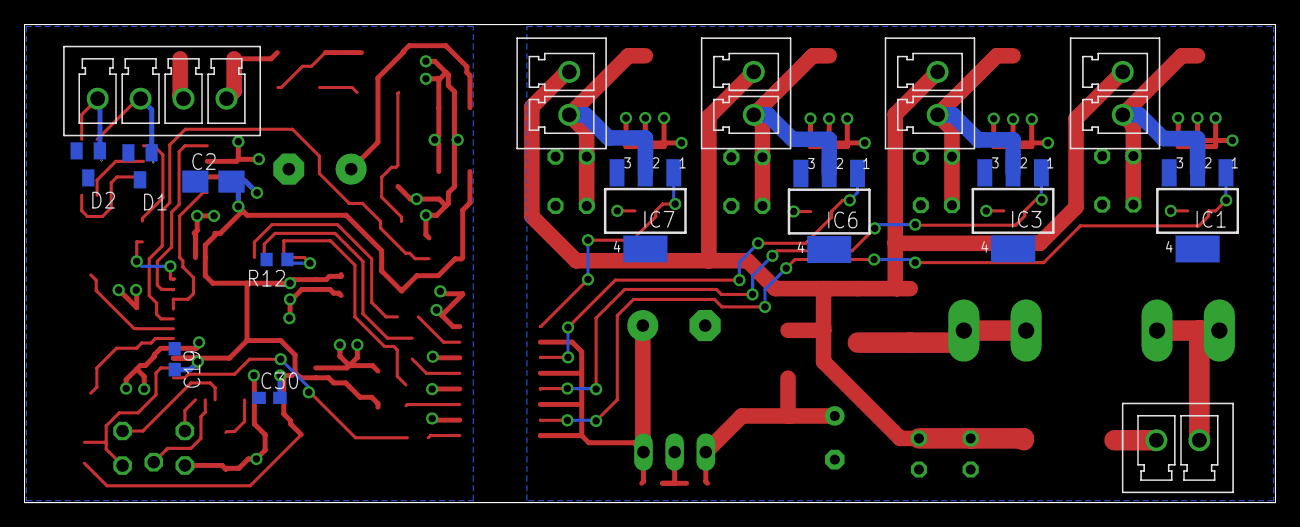
[picture p39: board pwm4.brd from below]

Board: 2 copper layers, 102.0 x 39.0 mm, 79 parts (16 on the bottom side), 46 nets.
