busmaster/homebus/hardware/rs485if/rs485if.brd

## EAGLE design hardware/rs485if/rs485if.brd (2016-03-19)

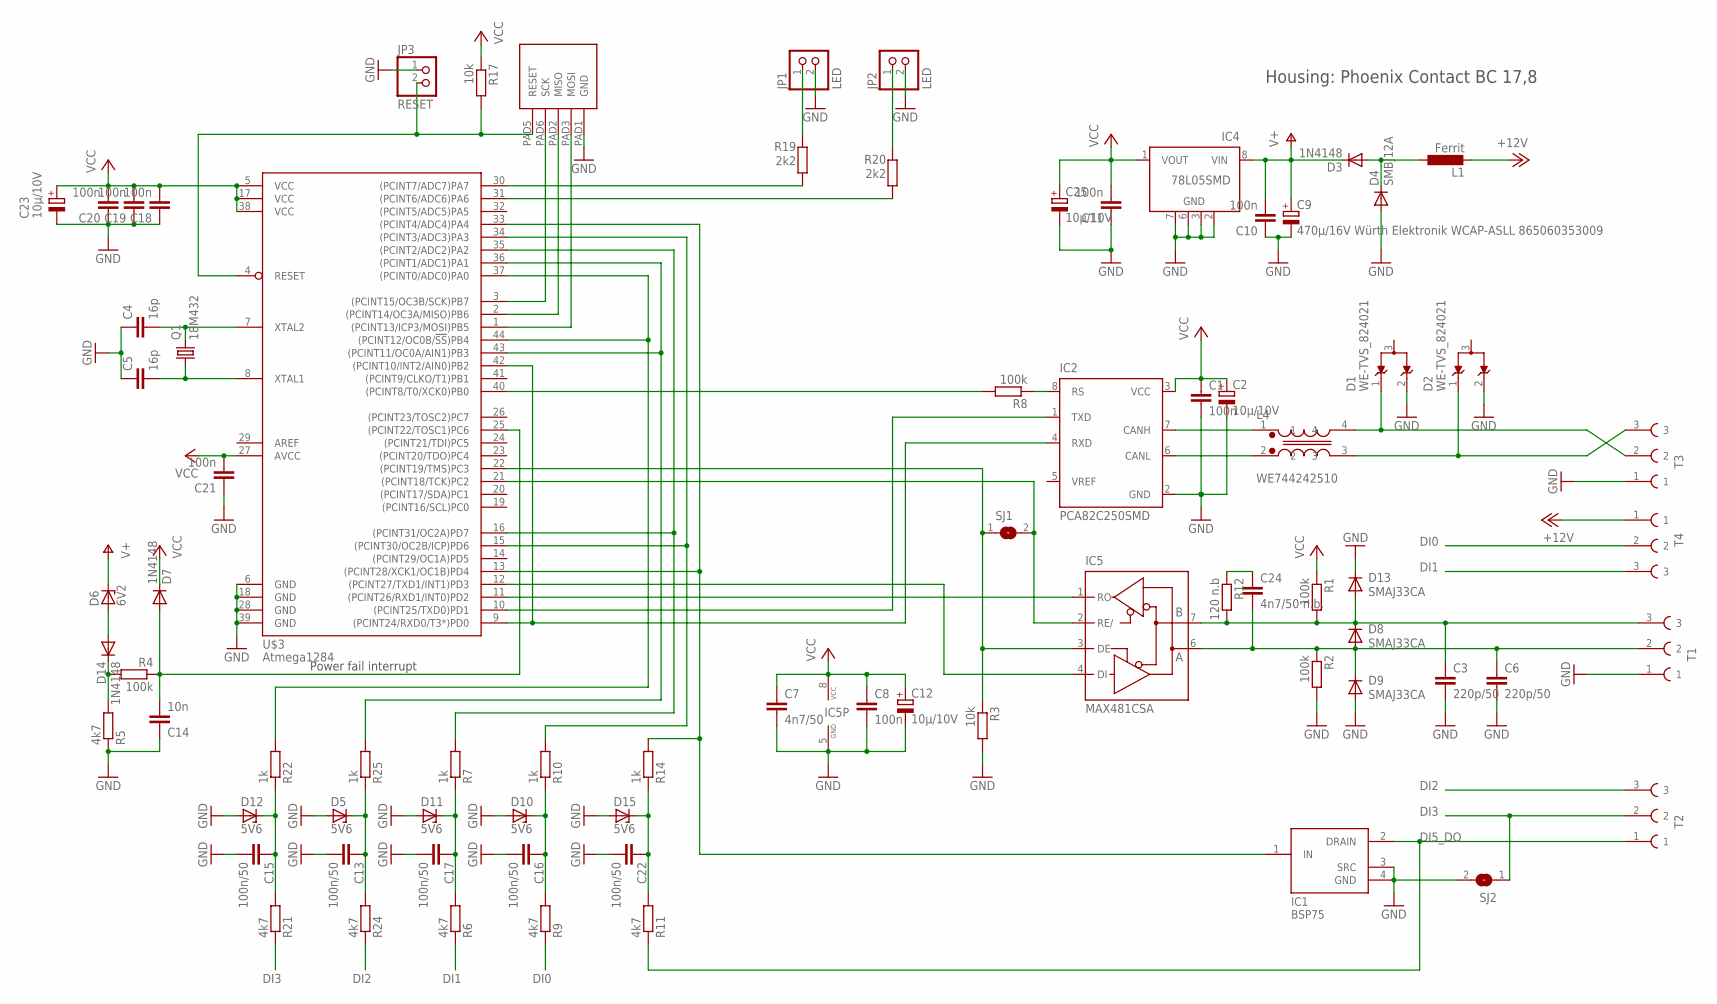
[picture p40: schematic rs485if.sch]

Parts:
C1, C8, C10, C11, C18, C19, C20, C21: 100n; C0603
C2, C12, C23, C25: 10µ/10V; A/3216-18W
C3, C6: 220p/50; C0603
C4, C5: 16p; C0603
C7: 4n7/50; C0603
C9: 470µ/16V Würth Elektronik WCAP-ASLL 865060353009; SANYO-OSCON_SMD_E7
C13, C15, C16, C17, C22: 100n/50; C0603
C14: 10n; C0603
C24: 4n7/50 n.b.; C0603
D1, D2: WE-TVS_824021; WE-TVS_SOT23-3L
D3, D7, D14: 1N4148; SOD80C
D4: SMBJ12A; SMB
D5, D10, D11, D12, D15: 5V6; SOD80C
D6: 6V2; SOD80C
D8, D9, D13: SMAJ33CA; DO214AC
IC1: BSP75; SOT223
IC2: PCA82C250SMD; SO8
IC4: 78L05SMD; SO08
IC5: MAX481CSA; SO08
JP1, JP2: LED; 1X02
JP3: RESET; 1X02
L1: Ferrit; L1806
L4: WE744242510; WE-SLM
Q1: 18M432; SM49
R1, R2, R4, R8: 100k; R0603
R3, R17: 10k; R0603
R5, R6, R9, R11, R21, R24: 4k7; R0603
R7, R10, R14, R22, R25: 1k; R0603
R12: 120 n.b; R0603
R19, R20: 2k2; R0603
SJ1, SJ2: SJ
T1, T2: MKDSO_2.5/3_R; PHOENIX_MKDSO_2.5/3_R
T3, T4: MKDSO_2.5/3_L; PHOENIX_MKDSO_2.5/3_L
U$1: ATMEL_ISP
U$3: Atmega1284; TQFP44

Connections:
#RESET: JP3.2, R17.2, U$1.PAD5 (RESET), U$3.4 (RESET)
+12V: L1.2, T4.1
A: C6.1, C24.2, D8.A, D9.C, IC5.6 (A), R2.1, T1.2
B: C3.1, D8.C, D13.A, IC5.7 (B), R1.2, R12.2, T1.3
B+: D1.1, L4.4, T3.2
B-: D2.1, L4.3, T3.3
DI0: R9.1, T4.2
DI1: R6.1, T4.3
DI2: R24.1, T2.3
DI3: R21.1, SJ2.1, T2.2
DI5_DO: IC1.2 (DRAIN), R11.1, T2.1
GND: C1.2, C2.-, C3.2, C4.1, C5.1, C6.2, C7.2, C8.2, C9.-, C10.1, C11.1, C12.-, C13.2, C14.1, C15.2, C16.2, C17.2, C18.1, C19.1, C20.1, C21.1, C22.2, C23.-, C25.-, D1.2, D2.2, D4.A, D5.A, D9.A, D10.A, D11.A, D12.A, D13.C, D15.A, IC1.3 (SRC), IC1.4 (GND), IC2.2 (GND), IC4.2 (GND), IC4.3 (GND), IC4.6 (GND), IC4.7 (GND), IC5.5 (GND), JP1.2, JP2.2, JP3.1, R2.2, R3.2, R5.1, SJ2.2, T1.1, T3.1, U$1.PAD1 (GND), U$3.6 (GND), U$3.18 (GND), U$3.28 (GND), U$3.39 (GND)
unnamed: R8.2, U$3.40 ((PCINT8/T0/XCK0)PB0)
unnamed: C24.1, R12.1
unnamed: IC2.1 (TXD), U$3.10 ((PCINT25/TXD0)PD1)
unnamed: U$1.PAD3 (MOSI), U$3.1 ((PCINT13/ICP3/MOSI)PB5)
unnamed: U$1.PAD2 (MISO), U$3.2 ((PCINT14/OC3A/MISO)PB6)
unnamed: U$1.PAD6 (SCK), U$3.3 ((PCINT15/OC3B/SCK)PB7)
unnamed: IC1.1 (IN), R14.2, U$3.13 ((PCINT28/XCK1/OC1B)PD4), U$3.33 ((PCINT4/ADC4)PA4)
unnamed: C13.1, D5.C, R24.2, R25.1
unnamed: IC2.7 (CANH), L4.1
unnamed: IC5.4 (DI), U$3.12 ((PCINT27/TXD1/INT1)PD3)
unnamed: IC2.4 (RXD), U$3.9 ((PCINT24/RXD0/T3*)PD0), U$3.42 ((PCINT10/INT2/AIN0)PB2)
unnamed: IC5.1 (RO), U$3.11 ((PCINT26/RXD1/INT0)PD2)
unnamed: IC5.3 (DE), R3.1, SJ1.1, U$3.22 ((PCINT19/TMS)PC3)
unnamed: C4.2, Q1.2, U$3.7 (XTAL2)
unnamed: C5.2, Q1.1, U$3.8 (XTAL1)
unnamed: IC2.6 (CANL), L4.2
unnamed: C15.1, D12.C, R21.2, R22.1
unnamed: C16.1, D10.C, R9.2, R10.1
unnamed: D3.A, D4.C, L1.1
unnamed: C17.1, D11.C, R6.2, R7.1
unnamed: D6.A, D14.A
unnamed: JP2.1, R20.1
unnamed: R19.2, U$3.30 ((PCINT7/ADC7)PA7)
unnamed: R20.2, U$3.31 ((PCINT6/ADC6)PA6)
unnamed: IC5.2 (RE/), SJ1.2, U$3.21 ((PCINT18/TCK)PC2)
unnamed: IC2.8 (RS), R8.1
unnamed: D14.C, R4.2, R5.2
unnamed: C22.1, D15.C, R11.2, R14.1
unnamed: R10.2, U$3.15 ((PCINT30/OC2B/ICP)PD6), U$3.34 ((PCINT3/ADC3)PA3)
unnamed: R7.2, U$3.16 ((PCINT31/OC2A)PD7), U$3.35 ((PCINT2/ADC2)PA2)
unnamed: R25.2, U$3.36 ((PCINT1/ADC1)PA1), U$3.43 ((PCINT11/OC0A/AIN1)PB3)
unnamed: R22.2, U$3.37 ((PCINT0/ADC0)PA0), U$3.44 ((PCINT12/OC0B/!SS!)PB4)
unnamed: JP1.1, R19.1
unnamed: C14.2, D7.A, R4.1, U$3.25 ((PCINT22/TOSC1)PC6)
V+: C9.+, C10.2, D3.C, D6.C, IC4.8 (VIN)
VCC: C1.1, C2.+, C7.1, C8.1, C11.2, C12.+, C18.2, C19.2, C20.2, C21.2, C23.+, C25.+, D7.C, IC2.3 (VCC), IC4.1 (VOUT), IC5.8 (VCC), R1.1, R17.1, U$3.5 (VCC), U$3.17 (VCC), U$3.27 (AVCC), U$3.38 (VCC)

Notes on the sheet:
Power fail interrupt
Housing: Phoenix Contact BC 17,8

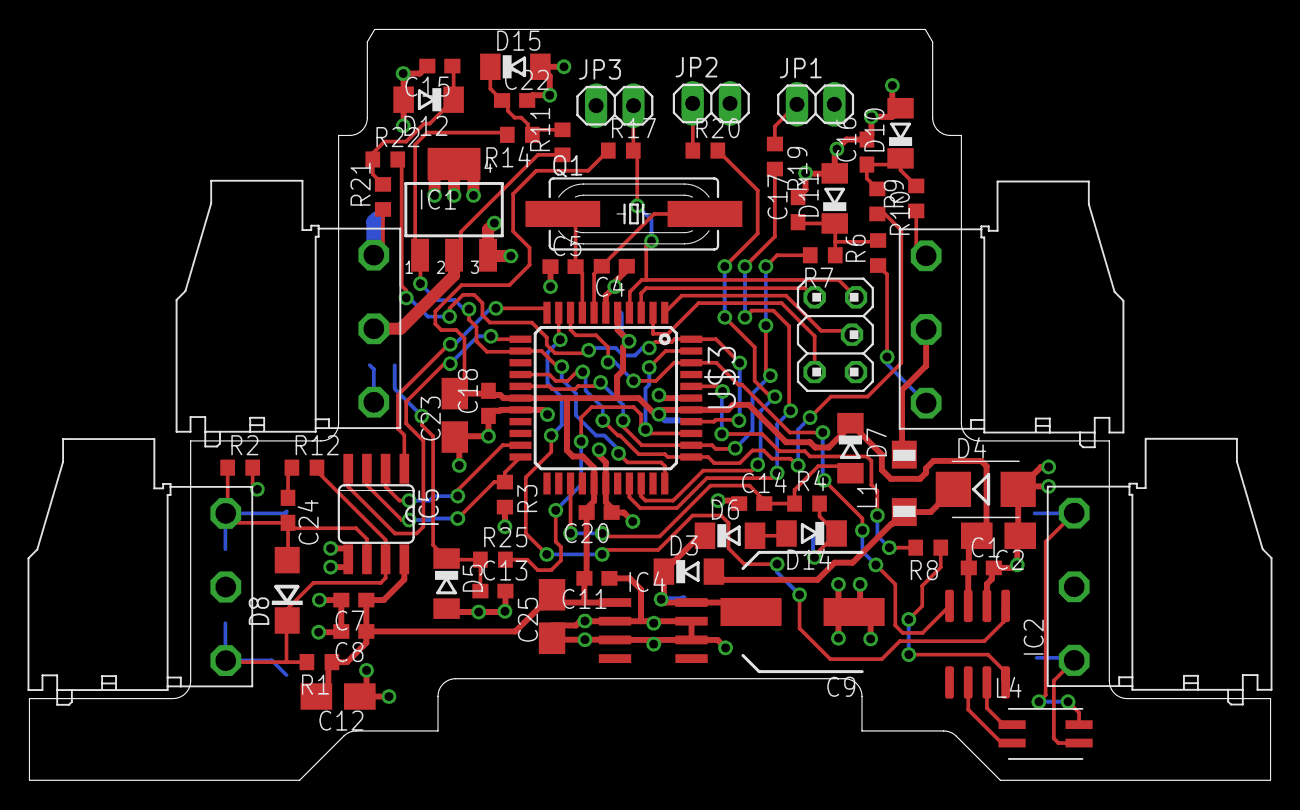
[picture p41: board rs485if.brd from above]

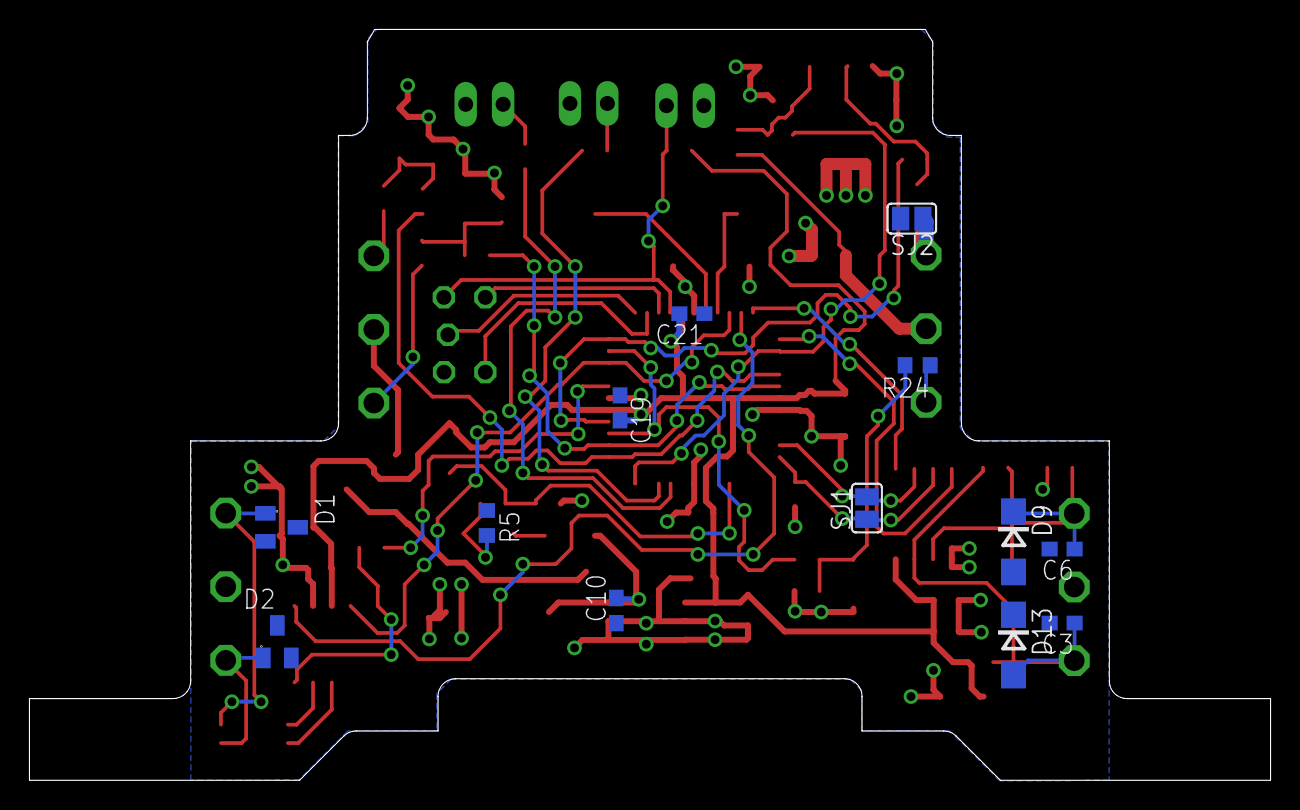
[picture p42: board rs485if.brd from below]

Board: 2 copper layers, 84.3 x 51.0 mm, 79 parts (13 on the bottom side), 48 nets.

Other parts of the board:
U$4: GEHÄUSE_PHOENIX_BC_17.8
