busmaster/homebus/include/do31/board.h

#ifndef _BOARD_H
#define _BOARD_H

/*-----------------------------------------------------------------------------
*  Includes
*/
#include <avr/io.h>

/*-----------------------------------------------------------------------------
*  Macros
*/                     

/* LED auf JP1 (nicht interruptsicher)*/
#define LED1_ON     PORTG &= ~0x10
#define LED1_OFF    PORTG |= 0x10
#define LED1_STATE  ((PORTG & 0x10) == 0)

/* LED auf JP2 (nicht interruptsicher)*/
#define LED2_ON     PORTG &= ~0x08
#define LED2_OFF    PORTG |= 0x08
#define LED2_STATE  ((PORTG & 0x08) == 0)

#define LED_ON      1
#define LED_OFF     0

#define NUM_LED     2

#define POWER_GOOD   ((PIND & 0b00000001) != 0)

#define BUS_TRANSCEIVER_POWER_DOWN   (PORTE |= 0b10000000)
#define BUS_TRANSCEIVER_POWER_UP     (PORTE &= ~0b10000000)
                       
/* Anzahl der digitalen Ausgänge */                       
#define NUM_DIGOUT   31


/* Ausgänge */

/* Port A-D wären Bit-adressierbar */

#define DIGOUT_0_ON       (PORTA |=  0b00000001)
#define DIGOUT_0_OFF      (PORTA &= ~0b00000001)
#define DIGOUT_0_STATE    ((PORTA &  0b00000001) != 0)
#define DIGOUT_0_TOGGLE   (DIGOUT_0_STATE ? DIGOUT_0_OFF : DIGOUT_0_ON)

#define DIGOUT_1_ON       (PORTA |=  0b00000010)
#define DIGOUT_1_OFF      (PORTA &= ~0b00000010)
#define DIGOUT_1_STATE    ((PORTA &  0b00000010) != 0)
#define DIGOUT_1_TOGGLE   (DIGOUT_1_STATE ? DIGOUT_1_OFF : DIGOUT_1_ON)

#define DIGOUT_2_ON       (PORTA |=  0b00000100)
#define DIGOUT_2_OFF      (PORTA &= ~0b00000100)
#define DIGOUT_2_STATE    ((PORTA &  0b00000100) != 0)
#define DIGOUT_2_TOGGLE   (DIGOUT_2_STATE ? DIGOUT_2_OFF : DIGOUT_2_ON)

#define DIGOUT_3_ON       (PORTA |=  0b00001000)
#define DIGOUT_3_OFF      (PORTA &= ~0b00001000)
#define DIGOUT_3_STATE    ((PORTA &  0b00001000) != 0)
#define DIGOUT_3_TOGGLE   (DIGOUT_3_STATE ? DIGOUT_3_OFF : DIGOUT_3_ON)

#define DIGOUT_4_ON       (PORTA |=  0b00010000)
#define DIGOUT_4_OFF      (PORTA &= ~0b00010000)
#define DIGOUT_4_STATE    ((PORTA &  0b00010000) != 0)
#define DIGOUT_4_TOGGLE   (DIGOUT_4_STATE ? DIGOUT_4_OFF : DIGOUT_4_ON)

#define DIGOUT_5_ON       (PORTA |=  0b00100000)
#define DIGOUT_5_OFF      (PORTA &= ~0b00100000)
#define DIGOUT_5_STATE    ((PORTA &  0b00100000) != 0)
#define DIGOUT_5_TOGGLE   (DIGOUT_5_STATE ? DIGOUT_5_OFF : DIGOUT_5_ON)

#define DIGOUT_6_ON       (PORTA |=  0b01000000)
#define DIGOUT_6_OFF      (PORTA &= ~0b01000000)
#define DIGOUT_6_STATE    ((PORTA &  0b01000000) != 0)
#define DIGOUT_6_TOGGLE   (DIGOUT_6_STATE ? DIGOUT_6_OFF : DIGOUT_6_ON)

#define DIGOUT_7_ON       (PORTA |=  0b10000000)
#define DIGOUT_7_OFF      (PORTA &= ~0b10000000)
#define DIGOUT_7_STATE    ((PORTA &  0b10000000) != 0)
#define DIGOUT_7_TOGGLE   (DIGOUT_7_STATE ? DIGOUT_7_OFF : DIGOUT_7_ON)

#define DIGOUT_8_ON       (PORTC |=  0b00000001)
#define DIGOUT_8_OFF      (PORTC &= ~0b00000001)
#define DIGOUT_8_STATE    ((PORTC &  0b00000001) != 0)
#define DIGOUT_8_TOGGLE   (DIGOUT_8_STATE ? DIGOUT_8_OFF : DIGOUT_8_ON)

#define DIGOUT_9_ON       (PORTC |=  0b00000010)
#define DIGOUT_9_OFF      (PORTC &= ~0b00000010)
#define DIGOUT_9_STATE    ((PORTC &  0b00000010) != 0)
#define DIGOUT_9_TOGGLE   (DIGOUT_9_STATE ? DIGOUT_9_OFF : DIGOUT_9_ON)

#define DIGOUT_10_ON       (PORTC |=  0b00000100)
#define DIGOUT_10_OFF      (PORTC &= ~0b00000100)
#define DIGOUT_10_STATE    ((PORTC &  0b00000100) != 0)
#define DIGOUT_10_TOGGLE   (DIGOUT_10_STATE ? DIGOUT_10_OFF : DIGOUT_10_ON)

#define DIGOUT_11_ON       (PORTC |=  0b00001000)
#define DIGOUT_11_OFF      (PORTC &= ~0b00001000)
#define DIGOUT_11_STATE    ((PORTC &  0b00001000) != 0)
#define DIGOUT_11_TOGGLE   (DIGOUT_11_STATE ? DIGOUT_11_OFF : DIGOUT_11_ON)

#define DIGOUT_12_ON       (PORTC |=  0b00010000)
#define DIGOUT_12_OFF      (PORTC &= ~0b00010000)
#define DIGOUT_12_STATE    ((PORTC &  0b00010000) != 0)
#define DIGOUT_12_TOGGLE   (DIGOUT_12_STATE ? DIGOUT_12_OFF : DIGOUT_12_ON)

#define DIGOUT_13_ON       (PORTC |=  0b00100000)
#define DIGOUT_13_OFF      (PORTC &= ~0b00100000)
#define DIGOUT_13_STATE    ((PORTC &  0b00100000) != 0)
#define DIGOUT_13_TOGGLE   (DIGOUT_13_STATE ? DIGOUT_13_OFF : DIGOUT_13_ON)

#define DIGOUT_14_ON       (PORTC |=  0b01000000)
#define DIGOUT_14_OFF      (PORTC &= ~0b01000000)
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
*  typedefs
*/

/*-----------------------------------------------------------------------------
*  Variables
*/                                

/*-----------------------------------------------------------------------------
*  Functions
*/

#endif
