busmaster/homebus/projects/stoveguard/main.c

/*
 * main.c
 *
 * Copyright 2021 Klaus Gusenleitner <klaus.gusenleitner@gmail.com>
 *
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
 *
 */

#include <stdint.h>
#include <stdbool.h>
#include <stdio.h>
#include <string.h>

#include <avr/interrupt.h>
#include <avr/io.h>
#include <avr/sleep.h>
#include <avr/eeprom.h>
#include <avr/wdt.h>
#include <avr/pgmspace.h>

#include "sio.h"
#include "sysdef.h"
#include "bus.h"

/*-----------------------------------------------------------------------------
*  Macros
*/
/* offset addresses in EEPROM */
#define MODUL_ADDRESS       0
#define OSCCAL_CORR         1
#define SWITCH_ADDR         2
#define SWITCH_INPUT        3
#define OFF_CNT_LOW         4
#define OFF_CNT_HIGH        5

#define CLIENT_ADDRESS_BASE     6  /* BUS_MAX_CLIENT_NUM from bus.h (16 byte) */
#define CLIENT_RETRY_CNT        22 /* size: 16 byte (BUS_MAX_CLIENT_NUM)      */

/* our bus address */
#define MY_ADDR            sMyAddr

/* lock/unlock button (pull to GND) on portc.0 and portc.1 */
#define LED_RED_ON         PORTB |= (1 << 0)
#define LED_RED_OFF        PORTB &= ~(1 << 0)
#define LED_GREEN_ON       PORTB |= (1 << 1)
#define LED_GREEN_OFF      PORTB &= ~(1 << 1)

#define BUTTON_RELEASED    ((PIND & (1 << 3)) != 0)
#define BUTTON_PRESSED     ((PIND & (1 << 3)) == 0)

#define OUTPUT_ON          PORTD |= (1 << 5)
#define OUTPUT_OFF         PORTD &= ~(1 << 5)
#define OUTPUT_STATE       ((PIND & (1 << 5)) != 0)

/* clock calibraation */
#define TIMER1_PRESCALER   (0b001 << CS10) // prescaler clk/1
#define MAX_CAL_TEL        31

/* Port D bit 7 controls bus transceiver power down */
#define BUS_TRANSCEIVER_POWER_DOWN  PORTD |= (1 << 7)
#define BUS_TRANSCEIVER_POWER_UP    PORTD &= ~(1 << 7)

/* ADC */
/* RESF1:0 = 01     select AVCC as AREF */
#define ADMUX_CONF         0b01000000
/* use ADC1, ADC2 ADC3 */
#define MIN_ADC            1
#define MAX_ADC            3

/* acual value event */
#define RESPONSE_TIMEOUT_MS         100  /* time in ms */
/* timeout for unreachable client  */
#define RETRY_CYCLE_TIME_MS         200 /* time in ms */

/*-----------------------------------------------------------------------------
*  Typedefs
*/
typedef struct {
    uint16_t oldAdc;
    uint16_t max;
    uint16_t min;
    bool     inc;
    uint16_t diff; // diff of last max and min
} TAdc;

typedef enum {
   ePowerOff,
   ePowerOn
} TPowerState;

typedef enum {
   ePresenceIdle,
   ePresenceReqWait,
   ePresenceReq,
   ePresenceRespWait
} TPresenceState;

typedef enum {
    eInit,
    eSkip,
    eWaitForConfirmation1,
    eWaitForConfirmation2,
    eConfirmationOK
} TState;

typedef struct {
    uint8_t  address;
    uint8_t  maxRetry;
    uint8_t  curRetry;
    enum {
        eEventInit,
        eEventWaitForConfirmation,
        eEventConfirmationOK,
        eEventMaxRetry
    } state;
    uint16_t requestTimeStamp;
} TClient;

/*-----------------------------------------------------------------------------
*  Variables
*/
char version[] = "stoveguard 0.01";

static TBusTelegram   *spRxBusMsg;
static TBusTelegram   sTxBusMsg;

volatile uint8_t      gTimeMs;
volatile uint16_t     gTimeMs16;
volatile uint16_t     gTimeS;

static uint8_t        sMyAddr;
static uint16_t       sOffCnt;

static int            sSioHandle;

#define NUM_ADC       3
static volatile TAdc  sAdc[NUM_ADC];

static uint8_t        sPresenceSwitchAddr;
static uint8_t        sPresenceSwitchInput;
static bool           sPresenceSwitchState;
static bool           sPresenceSwitchStateReceived;

static TPowerState    sPowerState = ePowerOff;
static TPresenceState sPresenceState = ePresenceIdle;
static bool           sOutputOff = false;

static TClient        sClient[BUS_MAX_CLIENT_NUM];
static uint8_t        sNumClients;

/*-----------------------------------------------------------------------------
*  Functions
*/
static void PortInit(void);
static void AdcInit(void);
static void TimerInit(void);
static void ProcessBus(uint8_t ret);
static void SendStartupMsg(void);
static void BusTransceiverPowerDown(bool powerDown);
static void InitTimer1(void);
static void InitComm(void);
static void ExitComm(void);
static void PowerMonitor(void);
static void Output(void);
static void OutputEvent(void);
static void GetClientListFromEeprom(void);

/*-----------------------------------------------------------------------------
*  program start
*/
int main(void) {

    uint8_t ret;

    MCUSR = 0;
    wdt_disable();

    /* get module address */
    sMyAddr = eeprom_read_byte((const uint8_t *)MODUL_ADDRESS);
    sPresenceSwitchAddr = eeprom_read_byte((const uint8_t *)SWITCH_ADDR);
    sPresenceSwitchInput = eeprom_read_byte((const uint8_t *)SWITCH_INPUT);
    sOffCnt = eeprom_read_byte((const uint8_t *)OFF_CNT_LOW) +
              eeprom_read_byte((const uint8_t *)OFF_CNT_HIGH) * 256;

    GetClientListFromEeprom();

    PortInit();
    AdcInit();
    TimerInit();

    InitComm();

    /* enable global interrupts */
    ENABLE_INT;

    SendStartupMsg();

    while (1) {
        ret = BusCheck();
        ProcessBus(ret);
        PowerMonitor();
        Output();
        OutputEvent();
    }
    return 0;  /* never reached */
}

/*-----------------------------------------------------------------------------
*  switch bus transceiver power down/up
*  called from interrupt context or disabled interrupt, so disable interrupt
*  is not required here
*/
static void BusTransceiverPowerDown(bool powerDown) {

    if (powerDown) {
        BUS_TRANSCEIVER_POWER_DOWN;
    } else {
        BUS_TRANSCEIVER_POWER_UP;
    }
}

/*-----------------------------------------------------------------------------
 * wait for first low pulse that is longer than MIN_PULSE_CNT and return the
 * start timestamp of this low pulse
 */

#define MIN_PULSE_CNT 300

#define NOP_10 asm volatile("nop"); \
               asm volatile("nop"); \
               asm volatile("nop"); \
               asm volatile("nop"); \
               asm volatile("nop"); \
               asm volatile("nop"); \
               asm volatile("nop"); \
               asm volatile("nop"); \
               asm volatile("nop"); \
               asm volatile("nop")

#define NOP_4  asm volatile("nop"); \
               asm volatile("nop"); \
               asm volatile("nop"); \
               asm volatile("nop")


uint16_t Synchronize(void) {

    uint16_t cnt;
    uint16_t startCnt;

    do {
        while ((PIND & 0b00000001) != 0);
        PORTB = 1; /* tigger timer capture */
        NOP_4;
        PORTB = 0;
        startCnt = ICR1;
        while ((PIND & 0b00000001) == 0);
        PORTB = 1; /* tigger timer capture */
        NOP_4;
        PORTB = 0;
        cnt = ICR1;
    } while ((cnt - startCnt) < MIN_PULSE_CNT);

    return startCnt;
}

uint16_t ClkMeasure(void) {

    uint16_t stopCnt;
    uint8_t  i;

    for (i = 0; i < 6; i++) {
        while ((PIND & 0b00000001) != 0);
        NOP_4;
        while ((PIND & 0b00000001) == 0);
        NOP_4;
    }
    while ((PIND & 0b00000001) != 0);
    NOP_4;
    while ((PIND & 0b00000001) == 0);
    PORTB = 1;  /* tigger timer capture */
    NOP_4;
    PORTB = 0;
    stopCnt = ICR1;

    return stopCnt;
}

/*-----------------------------------------------------------------------------
*  process received bus telegrams
*/
static void ProcessBus(uint8_t ret) {

    TBusMsgType                msgType;
    uint8_t                    i;
    uint8_t                    val8;
    uint8_t                    *p;
    bool                       msgForMe = false;
    uint8_t                    flags;
    static bool                sTxRetry = false;
    static TBusTelegram        sTxMsg;
    TBusDevRespActualValue     *pAv;
    TClient                    *pClient;

    if (sTxRetry) {
        sTxRetry = BusSend(&sTxMsg) != BUS_SEND_OK;
        return;
    }

    if (ret == BUS_MSG_OK) {
        msgType = spRxBusMsg->type;
        switch (msgType) {
        case eBusDevReqReboot:
        case eBusDevReqInfo:
        case eBusDevReqEepromRead:
        case eBusDevReqEepromWrite:
        case eBusDevReqSetClientAddr:
        case eBusDevReqGetClientAddr:
        case eBusDevReqDoClockCalib:
        case eBusDevReqDiag:
        case eBusDevReqActualValue:
        case eBusDevRespActualValue:
        case eBusDevRespActualValueEvent:
            if (spRxBusMsg->msg.devBus.receiverAddr == MY_ADDR) {
                msgForMe = true;
            }
            break;
        default:
            break;
        }
    }

    if (msgForMe == false) {
        return;
    }

    switch (msgType) {
    case eBusDevReqReboot:
        /* reset controller with watchdog */
        /* set watchdog timeout to shortest value (14 ms) */
        cli();
        wdt_enable(WDTO_15MS);
        /* wait for reset */
        while (1);
        break;
    case eBusDevReqInfo:
        sTxMsg.type = eBusDevRespInfo;
        sTxMsg.senderAddr = MY_ADDR;
        sTxMsg.msg.devBus.receiverAddr = spRxBusMsg->senderAddr;
        sTxMsg.msg.devBus.x.devResp.info.devType = eBusDevTypeSg;
        strncpy((char *)(sTxMsg.msg.devBus.x.devResp.info.version),
                version, BUS_DEV_INFO_VERSION_LEN);
        sTxMsg.msg.devBus.x.devResp.info.version[BUS_DEV_INFO_VERSION_LEN - 1] = '\0';
        sTxRetry = BusSend(&sTxMsg) != BUS_SEND_OK;
        break;
    case eBusDevReqEepromRead:
        sTxMsg.senderAddr = MY_ADDR;
        sTxMsg.type = eBusDevRespEepromRead;
        sTxMsg.msg.devBus.receiverAddr = spRxBusMsg->senderAddr;
        sTxMsg.msg.devBus.x.devResp.readEeprom.data =
            eeprom_read_byte((const uint8_t *)spRxBusMsg->msg.devBus.x.devReq.readEeprom.addr);
        sTxRetry = BusSend(&sTxMsg) != BUS_SEND_OK;
        break;
    case eBusDevReqEepromWrite:
        sTxMsg.senderAddr = MY_ADDR;
        sTxMsg.type = eBusDevRespEepromWrite;
        sTxMsg.msg.devBus.receiverAddr = spRxBusMsg->senderAddr;
        p = &(spRxBusMsg->msg.devBus.x.devReq.writeEeprom.data);
        eeprom_write_byte((uint8_t *)spRxBusMsg->msg.devBus.x.devReq.readEeprom.addr, *p);
        sTxRetry = BusSend(&sTxMsg) != BUS_SEND_OK;
        break;
    case eBusDevReqSetClientAddr:
        sTxMsg.senderAddr = MY_ADDR;
        sTxMsg.type = eBusDevRespSetClientAddr;
        sTxMsg.msg.devBus.receiverAddr = spRxBusMsg->senderAddr;
        for (i = 0; i < BUS_MAX_CLIENT_NUM; i++) {
            uint8_t *p = &(spRxBusMsg->msg.devBus.x.devReq.setClientAddr.clientAddr[i]);
            eeprom_write_byte((uint8_t *)(CLIENT_ADDRESS_BASE + i), *p);
        }
        sTxRetry = BusSend(&sTxMsg) != BUS_SEND_OK;
        GetClientListFromEeprom();
        break;
    case eBusDevReqGetClientAddr:
        sTxMsg.senderAddr = MY_ADDR;
        sTxMsg.type = eBusDevRespGetClientAddr;
        sTxMsg.msg.devBus.receiverAddr = spRxBusMsg->senderAddr;
        for (i = 0; i < BUS_MAX_CLIENT_NUM; i++) {
            uint8_t *p = &(sTxMsg.msg.devBus.x.devResp.getClientAddr.clientAddr[i]);
            *p = eeprom_read_byte((const uint8_t *)(CLIENT_ADDRESS_BASE + i));
        }
        sTxRetry = BusSend(&sTxMsg) != BUS_SEND_OK;
        break;
    case eBusDevReqDoClockCalib: {
        uint8_t         old_osccal;
        static uint8_t  sOsccal = 0;
        uint16_t        startCnt;
        uint16_t        stopCnt;
        uint16_t        clocks;
        uint16_t        diff;
        uint16_t        seqLen;
        static int      sCount = 0;
        static uint16_t sMinDiff = 0xffff;
        static uint8_t  sMinOsccal = 0;
        uint8_t         osccal_corr;

        if (spRxBusMsg->msg.devBus.x.devReq.doClockCalib.command == eBusDoClockCalibInit) {
            sCount = 0;
            sOsccal = 0;
            sMinDiff = 0xffff;
        } else if (sCount > MAX_CAL_TEL) {
            sTxMsg.msg.devBus.x.devResp.doClockCalib.state = eBusDoClockCalibStateError;
            sTxMsg.senderAddr = MY_ADDR;
            sTxMsg.type = eBusDevRespDoClockCalib;
            sTxMsg.msg.devBus.receiverAddr = spRxBusMsg->senderAddr;
            sTxRetry = BusSend(&sTxMsg) != BUS_SEND_OK;
            break;
        }

        flags = DISABLE_INT;

        BUS_TRANSCEIVER_POWER_UP;
        PORTB = 0;

        /* 8 bytes 0x00: 8 * (1 start bit + 8 data bits) + 7 stop bits  */
        seqLen = 8 * 1000000 * 9 / 9600 + 7 * 1000000 * 1 / 9600; /* = 8229 us */
        old_osccal = OSCCAL;

        ExitComm();
        InitTimer1();

        TCCR1B = (1 << ICES1) | TIMER1_PRESCALER;

        OSCCAL = sOsccal;
        NOP_10;

        for (i = 0; i < 8; i++) {
            startCnt = Synchronize();
            stopCnt = ClkMeasure();

            clocks = stopCnt - startCnt;
            if (clocks > seqLen) {
                diff = clocks - seqLen;
            } else {
                diff = seqLen - clocks;
            }
            if (diff < sMinDiff) {
                sMinDiff = diff;
                sMinOsccal = OSCCAL;
            }
            OSCCAL++;
            NOP_4;
        }

        BUS_TRANSCEIVER_POWER_DOWN;

        InitTimer1();
        InitComm();
        sOsccal = OSCCAL;
        OSCCAL = old_osccal;

        RESTORE_INT(flags);

        if (sCount < MAX_CAL_TEL) {
            sTxMsg.msg.devBus.x.devResp.doClockCalib.state = eBusDoClockCalibStateContiune;
            sCount++;
        } else {
            sTxMsg.msg.devBus.x.devResp.doClockCalib.state = eBusDoClockCalibStateSuccess;
            /* save the osccal correction value to eeprom */
            osccal_corr = eeprom_read_byte((const uint8_t *)OSCCAL_CORR);
            osccal_corr += sMinOsccal - old_osccal;
            eeprom_write_byte((uint8_t *)OSCCAL_CORR, osccal_corr);
            OSCCAL = sMinOsccal;
            NOP_10;
        }
        sTxMsg.senderAddr = MY_ADDR;
        sTxMsg.type = eBusDevRespDoClockCalib;
        sTxMsg.msg.devBus.receiverAddr = spRxBusMsg->senderAddr;
        sTxRetry = BusSend(&sTxMsg) != BUS_SEND_OK;
        break;
    }
    case eBusDevReqDiag:
        sTxMsg.senderAddr = MY_ADDR;
        sTxMsg.type = eBusDevRespDiag;
        sTxMsg.msg.devBus.x.devResp.diag.devType = eBusDevTypeSg;
        sTxMsg.msg.devBus.receiverAddr = spRxBusMsg->senderAddr;
        p = sTxMsg.msg.devBus.x.devResp.diag.data;
        *(uint16_t *)(p + 0) = sAdc[0].diff;
        *(uint16_t *)(p + 2) = sAdc[1].diff;
        *(uint16_t *)(p + 4) = sAdc[2].diff;
        *(p + 6) = OUTPUT_STATE;
        *(p + 7) = (uint8_t)sPowerState;
        *(p + 8) = (uint8_t)sPresenceState;
        sTxRetry = BusSend(&sTxMsg) != BUS_SEND_OK;
        break;
    case eBusDevRespActualValue:
        pAv = &spRxBusMsg->msg.devBus.x.devResp.actualValue;
        if ((pAv->devType == eBusDevTypeSw8) &&
            (spRxBusMsg->senderAddr == sPresenceSwitchAddr)) {
            val8 = pAv->actualValue.sw8.state;
            if ((val8 & (1 << sPresenceSwitchInput)) == 0) {
                sPresenceSwitchState = false;
            } else {
                sPresenceSwitchState = true;
            }
            sPresenceSwitchStateReceived = true;
        }
        break;
    case eBusDevReqActualValue:
        /* response packet */
        pAv = &sTxMsg.msg.devBus.x.devResp.actualValue;
        sTxMsg.type = eBusDevRespActualValue;
        sTxMsg.senderAddr = MY_ADDR;
        sTxMsg.msg.devBus.receiverAddr = spRxBusMsg->senderAddr;
        pAv->devType = eBusDevTypeSg;
        pAv->actualValue.sg.output = OUTPUT_STATE;
        sTxRetry = BusSend(&sTxMsg) != BUS_SEND_OK;
        break;
    case eBusDevRespActualValueEvent:
        pClient = sClient;
        for (i = 0; i < sNumClients; i++) {
            if ((pClient->address == spRxBusMsg->senderAddr) &&
                (pClient->state == eEventWaitForConfirmation)) {
                if (spRxBusMsg->msg.devBus.x.devResp.actualValueEvent.actualValue.sg.output == OUTPUT_STATE) {
                    pClient->state = eEventConfirmationOK;
                }
            }
            pClient++;
        }
        break;
    default:
        break;
    }
}

/*-----------------------------------------------------------------------------
*  port init
*/
static void PortInit(void) {

    /* configure pins */
    PORTB = 0b00000000;
    DDRB =  0b11111111;

    PORTC = 0b00000000;
    DDRC =  0b10110000;

    PORTD = 0b10001111;
    DDRD =  0b11110010;
}

/*-----------------------------------------------------------------------------
*  adc init
*/
static void AdcInit(void) {

    volatile TAdc *pAdc;
    uint8_t i;

    for (pAdc = sAdc, i = 0; i <= (MAX_ADC - MIN_ADC); pAdc++, i++) {
        pAdc->min = 0xffff;
        pAdc->max = 0;
        pAdc->inc = false;
        pAdc->diff = 0;
        pAdc->oldAdc = 0;
    }

    /* ADC */
    ADMUX = ADMUX_CONF | MIN_ADC; /* start with ADC1 */

    /* digital input disable for ADC0..3 */
    DIDR0 = 0b00001111;

    /* ADEN = 1         ADC enable */
    /* ADPS2:0 = 100    prescaler, division factor is 16 -> 1MHz/16 = 62500 Hz*/
    ADCSRA = 0b10000100;

    /* trigger first conversion */
    ADCSRA |= (1 << ADSC);
    while (ADCSRA & (1 << ADSC));
    ADCSRA |= (1 << ADIF);
    ADCSRA |= (1 << ADIE);

}

/*-----------------------------------------------------------------------------
*  timer init
*/
static void TimerInit(void) {

    /* prescaler clk/8
     * compare match 125
     * -> Interrupt period 125/1000000 * 8 = 1 ms */
    TCCR0A = 2 << WGM20; // CTC
    TCCR0B = 2 << CS00;
    OCR0A = 125; /* counting 0-124 */
    TIMSK0 = 1 << OCIE0A;
}

static void InitTimer1(void) {
    /* set input clock to system clock */
    /* use software input capture       */
    TCCR1A = 0;
    TCCR1B = 0;
    TCCR1C = 0;
    TIMSK1 = 0;
    TCNT1 = 0;
    OCR1A = 0;
    OCR1B = 0;
    ICR1 = 0;
    TIFR1 = TIFR1;
}

/*-----------------------------------------------------------------------------
*  init bus communication
*/
static void InitComm(void) {

    SioInit();
    SioRandSeed(sMyAddr);
    sSioHandle = SioOpen("USART0", eSioBaud9600, eSioDataBits8, eSioParityNo,
                         eSioStopBits1, eSioModeHalfDuplex);
    SioSetTransceiverPowerDownFunc(sSioHandle, BusTransceiverPowerDown);

    BusTransceiverPowerDown(true);

    BusInit(sSioHandle);
    spRxBusMsg = BusMsgBufGet();
}

/*-----------------------------------------------------------------------------
*  bus communication exit
*/
static void ExitComm(void) {

    BusExit(sSioHandle);
    SioClose(sSioHandle);
    SioExit();
}

/*-----------------------------------------------------------------------------
*  send the startup msg. Delay depends on module address
*/
static void SendStartupMsg(void) {

    uint16_t startCnt;
    uint16_t cntMs;
    uint16_t diff;

    /* send startup message */
    /* delay depends on module address (address * 100 ms) */
    GET_TIME_MS16(startCnt);
    do {
        GET_TIME_MS16(cntMs);
        diff =  cntMs - startCnt;
    } while (diff < ((uint16_t)MY_ADDR * 100));

    sTxBusMsg.type = eBusDevStartup;
    sTxBusMsg.senderAddr = MY_ADDR;
    BusSend(&sTxBusMsg);
}


#define MIN_DIFF 10

static void PowerMonitor(void) {

    uint8_t i;
    bool on;
    static uint16_t sLatestOnTime = 0;
    static uint16_t sPresenceReqTime = 0;
    static uint16_t sPresenceTime = 0;
    uint16_t actualTime;
    uint16_t diff[3];
    uint8_t flags;

    GET_TIME_S(actualTime);

    flags = DISABLE_INT;
    diff[0] = sAdc[0].diff;
    diff[1] = sAdc[1].diff;
    diff[2] = sAdc[2].diff;
    RESTORE_INT(flags);

    switch (sPowerState) {
    case ePowerOff:
        for (i = 0; i <= (MAX_ADC - MIN_ADC); i++) {
            if (diff[i] > MIN_DIFF) {
                sPowerState = ePowerOn;
                sLatestOnTime = actualTime;
                sPresenceTime = actualTime;
                sPresenceState = ePresenceIdle;
                break;
            }
        }
        break;
    case ePowerOn:
        on = false;
        for (i = 0; i <= (MAX_ADC - MIN_ADC); i++) {
            if (diff[i] > MIN_DIFF) {
                on = true;
                break;
            }
        }
        if (on) {
            sLatestOnTime = actualTime;
        } else {
            if (((uint16_t)(actualTime - sLatestOnTime)) > 100) {
                sPowerState = ePowerOff;
                sPresenceState = ePresenceIdle;
            }
        }
        break;
    default:
        break;
    }

    if (sPowerState == ePowerOff) {
        return;
    }

    switch (sPresenceState) {
    case ePresenceIdle:
        sPresenceReqTime = actualTime;
        sPresenceState = ePresenceReqWait;
        break;
    case ePresenceReqWait:
        if (((uint16_t)(actualTime - sPresenceReqTime)) > 60) {
            sPresenceState = ePresenceReq;
            sPresenceSwitchStateReceived = false;
        }
        break;
    case ePresenceReq:
        sPresenceReqTime = actualTime;
        sTxBusMsg.type = eBusDevReqActualValue;
        sTxBusMsg.senderAddr = MY_ADDR;
        sTxBusMsg.msg.devBus.receiverAddr = sPresenceSwitchAddr;
        if (BusSend(&sTxBusMsg) == BUS_SEND_OK) {
            sPresenceState = ePresenceRespWait;
        }
        break;
    case ePresenceRespWait:
        if (sPresenceSwitchStateReceived) {
            sPresenceSwitchStateReceived = false;
            if (sPresenceSwitchState) {
                sPresenceTime = actualTime;
                sPresenceSwitchState = false;
            }
            sPresenceState = ePresenceIdle;
            sPresenceReqTime = actualTime;
        } else if (((uint16_t)(actualTime - sPresenceReqTime)) > 2) {
            // no response from presence detector
            sPresenceState = ePresenceReqWait;
        }
        break;
    default:
        break;
    }

    if (((uint16_t)(actualTime - sPresenceTime)) > 600) {
        // switch off
        sOutputOff = true;
        sPowerState = ePowerOff;
        sPresenceState = ePresenceIdle;
    }
}

static void Output(void) {

    uint16_t actualTime;
    static uint16_t sOffTime;

    GET_TIME_MS16(actualTime);

    if (sOutputOff) {
        OUTPUT_ON; // NC contactor
        sOutputOff = false;
        sOffTime = actualTime;
        sOffCnt++;
        eeprom_write_byte((uint8_t *)OFF_CNT_LOW, sOffCnt & 0xff);
        eeprom_write_byte((uint8_t *)OFF_CNT_HIGH, (sOffCnt & 0xff00) >> 8);
    }

    if (OUTPUT_STATE && (((uint16_t)(actualTime - sOffTime)) > 30000)) {
        OUTPUT_OFF;
    }
}

/*-----------------------------------------------------------------------------
*  get next client array index
*  if all clients are processed 0xff is returned
*/
static uint8_t GetUnconfirmedClient(uint8_t actualClient) {

    uint8_t  i;
    uint8_t  nextClient;
    TClient  *pClient;

    if (actualClient >= sNumClients) {
        return 0xff;
    }

    for (i = 0; i < sNumClients; i++) {
        nextClient = actualClient + i +1;
        nextClient %= sNumClients;
        pClient = &sClient[nextClient];
        if (pClient->state == eEventMaxRetry) {
            continue;
        }
        if (pClient->state != eEventConfirmationOK) {
            break;
        }
    }
    if (i == sNumClients) {
        /* all client's confirmations received or retry count expired */
        nextClient = 0xff;
    }
    return nextClient;
}

static void InitClientState(void) {

    TClient *pClient;
    uint8_t  i;

    for (i = 0, pClient = sClient; i < sNumClients; i++) {
        pClient->state = eEventInit;
        pClient->curRetry = 0;
        pClient++;
    }
}

static void GetClientListFromEeprom(void) {

    TClient *pClient;
    uint8_t i;
    uint8_t numClients;
    uint8_t clientAddr;
    uint8_t retryCnt;

    for (i = 0, numClients = 0, pClient = sClient; i < BUS_MAX_CLIENT_NUM; i++) {
        clientAddr = eeprom_read_byte((const uint8_t *)(CLIENT_ADDRESS_BASE + i));
        retryCnt = eeprom_read_byte((const uint8_t *)(CLIENT_RETRY_CNT + i));
        if (clientAddr != BUS_CLIENT_ADDRESS_INVALID) {
            pClient->address = clientAddr;
            pClient->maxRetry = retryCnt;
            pClient->state = eEventInit;
            pClient++;
            numClients++;
        }
    }
    sNumClients = numClients;
}

/*-----------------------------------------------------------------------------
*  send output state change to registered clients
*/
static void OutputEvent(void) {

    static uint8_t   sActualClient = 0xff; /* actual client's index being processed */
    TClient          *pClient;
    uint16_t         actualTime16;
    static bool      sNewClientCycleDelay = false;
    static uint16_t  sNewClientCycleTimeStamp;
    TBusDevReqActualValueEvent *pActVal;
    bool             getNextClient;
    uint8_t          nextClient;
    static uint8_t   sOldOutputState = 0;
    uint8_t          outputState;

    if (sNumClients == 0) {
        return;
    }

    GET_TIME_MS16(actualTime16);
    outputState = OUTPUT_STATE;
    if (outputState != sOldOutputState) {
       sActualClient = 0;
       sOldOutputState = outputState;
       sNewClientCycleDelay = false;
       InitClientState();
    }

    if (sActualClient == 0xff) {
        return;
    }

    if (sNewClientCycleDelay) {
        if (((uint16_t)(actualTime16 - sNewClientCycleTimeStamp)) < RETRY_CYCLE_TIME_MS) {
            return;
        } else {
            sNewClientCycleDelay = false;
        }
    }

    pClient = &sClient[sActualClient];
    getNextClient = true;
    switch (pClient->state) {
    case eEventInit:
        pActVal = &sTxBusMsg.msg.devBus.x.devReq.actualValueEvent;
        sTxBusMsg.type = eBusDevReqActualValueEvent;
        sTxBusMsg.senderAddr = MY_ADDR;
        sTxBusMsg.msg.devBus.receiverAddr = pClient->address;
        pActVal->devType = eBusDevTypeSg;
        pActVal->actualValue.sg.output = outputState;
        if (BusSend(&sTxBusMsg) == BUS_SEND_OK) {
            pClient->state = eEventWaitForConfirmation;
            pClient->requestTimeStamp = actualTime16;
        } else {
            getNextClient = false;
        }
        break;
    case eEventWaitForConfirmation:
        if ((((uint16_t)(actualTime16 - pClient->requestTimeStamp)) >= RESPONSE_TIMEOUT_MS) &&
            (pClient->state != eEventMaxRetry)) {
            if (pClient->curRetry < pClient->maxRetry) {
                /* try again */
                pClient->curRetry++;
                getNextClient = false;
                pClient->state = eEventInit;
            } else {
                pClient->state = eEventMaxRetry;
            }
        }
        break;
    case eEventConfirmationOK:
        break;
    default:
        break;
    }

    if (getNextClient) {
        nextClient = GetUnconfirmedClient(sActualClient);
        if (nextClient <= sActualClient) {
            sNewClientCycleDelay = true;
            sNewClientCycleTimeStamp = actualTime16;
        }
        sActualClient = nextClient;
    }
}

/*-----------------------------------------------------------------------------
*  Timer 0 COMPA ISR
*  period:  1 ms
*/
ISR(TIMER0_COMPA_vect) {

    static uint16_t intCnt = 0;

    /* ms counter */
    gTimeMs16 += 1;
    gTimeMs += 1;
    intCnt++;
    if (intCnt >= 1000) { /* 1 ms * 1000 = 1 s*/
        intCnt = 0;
        gTimeS++;
    }

    ADCSRA |= (1 << ADSC);
}

/*-----------------------------------------------------------------------------
*  ADC Interrupt
*/
ISR(ADC_vect) {

    static uint8_t mux = MIN_ADC;
    uint16_t adc;
    uint16_t oldAdc;
    volatile TAdc *pAdc;

    /* ADC */
    pAdc = &sAdc[mux - MIN_ADC];
    oldAdc = pAdc->oldAdc;
    adc = ADCW;
    if (pAdc->inc) {
        if (adc <= oldAdc) {
            /* pos maximum */
            pAdc->max = oldAdc;
            pAdc->diff = pAdc->max - pAdc->min;
            pAdc->inc = false;
            pAdc->min = 0xffff;
        }
    } else {
        if (adc >= oldAdc) {
            /* neg maximum */
            pAdc->min = oldAdc;
            pAdc->diff = pAdc->max - pAdc->min;
            pAdc->inc = true;
            pAdc->max = 0;
        }
    }
    pAdc->oldAdc = adc;

    mux++;
    if (mux > MAX_ADC) {
        mux = MIN_ADC;
    }
    ADMUX = ADMUX_CONF | mux;
}
