busmaster/homebus/projects/smartmeterif/ConfigDescriptor.h

/*
             LUFA Library
     Copyright (C) Dean Camera, 2014.

  dean [at] fourwalledcubicle [dot] com
           www.lufa-lib.org
*/

/*
  Copyright 2014  Dean Camera (dean [at] fourwalledcubicle [dot] com)

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
  The author disclaims all warranties with regard to this
  software, including all implied warranties of merchantability
  and fitness.  In no event shall the author be liable for any
  special, indirect or consequential damages or any damages
  whatsoever resulting from loss of use, data or profits, whether
  in an action of contract, negligence or other tortious action,
  arising out of or in connection with the use or performance of
  this software.
*/

/** \file
 *
 *  Header file for ConfigDescriptor.c.
 */

#ifndef _CONFIGDESCRIPTOR_H_
#define _CONFIGDESCRIPTOR_H_

	/* Includes: */
		#include <LUFA/Drivers/USB/USB.h>

	/* Macros: */
		/** Pipe address for the data IN pipe. */
		#define FT232_DATA_IN_PIPE               (PIPE_DIR_IN  | 1)

		/** Pipe address for the data OUT pipe. */
		#define FT232_DATA_OUT_PIPE              (PIPE_DIR_OUT | 2)

	/* Enums: */
		/** Enum for the possible return codes of the \ref ProcessConfigurationDescriptor() function. */
		enum Host_GetConfigDescriptorDataCodes_t
		{
			SuccessfulConfigRead            = 0, /**< Configuration Descriptor was processed successfully */
			ControlError                    = 1, /**< A control request to the device failed to complete successfully */
			DescriptorTooLarge              = 2, /**< The device's Configuration Descriptor is too large to process */
			InvalidConfigDataReturned       = 3, /**< The device returned an invalid Configuration Descriptor */
			NoCompatibleInterfaceFound      = 4, /**< A compatible interface with the required endpoints was not found */
		};

	/* Function Prototypes: */
		uint8_t ProcessConfigDescriptor(void);

#endif
