busmaster/homebus/bus/busvar.c

/*
 * busvar.c
 *
 * Copyright 2018 Klaus Gusenleitner <klaus.gusenleitner@gmail.com>
 *
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
 *
 */
#include <stdint.h>
#include <stdbool.h>
#include <string.h>
#include <sysdef.h>

#include "bus.h"

#define TX_RETRY_TIMEOUT 50  /* ms */
#define RESPONSE_TIMEOUT 100 /* ms */

#define TRANSACTION_FIFO_LEN    8 /* must be power of 2 */

#define NUM_FIFO_FREE     ((sVarFifoRdIdx - sVarFifoWrIdx - 1) & (TRANSACTION_FIFO_LEN - 1))
#define IDX_INC(__idx__)   __idx__++; __idx__ &= (TRANSACTION_FIFO_LEN - 1)

typedef struct {
    uint8_t  size;
    void     *mem;
    uint16_t nvAddr;
} TVarTab;

typedef struct {
    uint8_t addr;
    uint8_t idx;
    void    *buf;     // caller supplied mem
    uint8_t size;
    TBusVarDir dir;
    TBusVarState state;
    uint8_t txRetryCnt;
    uint16_t txTime;
} TVarTransactionDesc;

static TVarTab  sVarTable[BUSVAR_NUMVAR];

static uint8_t  sHeap[BUSVAR_MEMSIZE];
static uint16_t sHeapCurr = 0;
static uint16_t sNvCurr = 0;

static TVarTransactionDesc sVarTransactionFifo[TRANSACTION_FIFO_LEN];
static uint8_t sVarFifoWrIdx;
static uint8_t sVarFifoRdIdx;
static uint8_t sMyAddr;
static TBusBarNvFunc sNvFunc;

void BusVarInit(uint8_t addr, TBusBarNvFunc func) {
    TVarTransactionDesc *vtd = sVarTransactionFifo;
    TVarTab *vt = sVarTable;
    int i;

    sMyAddr = addr;
    sNvFunc = func;

    for (i = 0; i < BUSVAR_NUMVAR; i++, vt++) {
        vt->size = 0;
        vt->mem = 0;
        vt->nvAddr = 0xffff;
    }

    sVarFifoWrIdx = 0;
    sVarFifoRdIdx = 0;
    for (i = 0; i < TRANSACTION_FIFO_LEN; i++, vtd++) {
        vtd->state = eBusVarState_Invalid;
    }
}

/* local access */

bool BusVarAdd(uint8_t idx, uint8_t size, bool persistent) {
    TVarTab *vt;

    if (idx >= (BUSVAR_NUMVAR - 1)) {
        return false;
    }
    if ((sHeapCurr + size) > BUSVAR_MEMSIZE) {
        return false;
    }
    if (persistent && (sNvFunc == 0)) {
        return false;
    }
    vt = &sVarTable[idx];
    /* in use? */
    if (vt->mem != 0) {
        return false;
    }
    vt->size = size;
    vt->mem = &sHeap[sHeapCurr];
    sHeapCurr += size;
    
    /* init from NV memory */
    if (persistent) {
        vt->nvAddr = sNvCurr;
        sNvCurr += size;
        if (!sNvFunc(vt->nvAddr, vt->mem, size, eBusVarRead)) {
            return false;
        }
    }
    
    return true;
}

uint8_t BusVarRead(uint8_t idx, void *buf, uint8_t bufSize, TBusVarResult *result) {
    TVarTab *vt;

    if (idx >= (BUSVAR_NUMVAR - 1)) {
        *result = eBusVarIndexError;
        return 0;
    }
    vt = &sVarTable[idx];
    if (bufSize < vt->size) {
        *result = eBusVarLengthError;
        return 0;
    }
    memcpy(buf, vt->mem, vt->size);
    *result = eBusVarSuccess;
    return vt->size;
}

bool BusVarWrite(uint8_t idx, void *buf, uint8_t bufSize, TBusVarResult *result) {
    TVarTab *vt;

    if (idx >= (BUSVAR_NUMVAR - 1)) {
        *result = eBusVarIndexError;
        return false;
    }
    vt = &sVarTable[idx];
    if (bufSize != vt->size) {
        *result = eBusVarLengthError;
        return false;
    }
    if (vt->nvAddr != 0xffff)  {
        if (!sNvFunc(vt->nvAddr, buf, vt->size, eBusVarWrite)) {
            *result = eBusVarNvError;
            return false;
        }
    }
    memcpy(vt->mem, buf, vt->size);

    *result = eBusVarSuccess;
    return true;
}

/*
 * remote access
 */
TBusVarHdl BusVarTransactionOpen(uint8_t addr, uint8_t idx, void *buf, uint8_t size, TBusVarDir dir) {
    TVarTransactionDesc *vtd;

    if (NUM_FIFO_FREE == 0) {
        return BUSVAR_HDL_INVALID;
    }
    vtd = &sVarTransactionFifo[sVarFifoWrIdx];
    vtd->addr = addr;
    vtd->idx = idx;
    vtd->dir = dir;
    vtd->buf = buf;
    vtd->size = size;
    vtd->state = eBusVarState_Scheduled;
    vtd->txRetryCnt = 5;
    IDX_INC(sVarFifoWrIdx);
    return (TBusVarHdl)vtd;
}

TBusVarState BusVarTransactionState(TBusVarHdl varHdl) {

    TVarTransactionDesc *vtd = (TVarTransactionDesc *)varHdl;

    return vtd->state;
}
void BusVarTransactionClose(TBusVarHdl varHdl) {

    TVarTransactionDesc *vtd = (TVarTransactionDesc *)varHdl;

    vtd->state = eBusVarState_Invalid;

    while (sVarFifoRdIdx != sVarFifoWrIdx) {
        vtd = &sVarTransactionFifo[sVarFifoRdIdx];
        if (vtd->state == eBusVarState_Invalid) {
            IDX_INC(sVarFifoRdIdx);
        } else {
            break;
        }
    }
}

void BusVarRespSet(uint8_t addr, TBusDevRespSetVar *respSet) {
    TVarTransactionDesc *vtd;
    uint8_t rdIdx;

    if (sVarFifoRdIdx == sVarFifoWrIdx) {
        // no response expected
        return;
    }

    rdIdx = sVarFifoRdIdx;
    do {
        vtd = &sVarTransactionFifo[rdIdx];
        if ((addr == vtd->addr) && (vtd->idx != respSet->index)) {
            break;
        }
        IDX_INC(rdIdx);
    } while (rdIdx != sVarFifoWrIdx);

    if (rdIdx != sVarFifoWrIdx) {
        vtd->state = eBusVarState_Ready;
    }
}

void BusVarRespGet(uint8_t addr, TBusDevRespGetVar *respGet) {
    TVarTransactionDesc *vtd;
    uint8_t i;
    uint8_t rdIdx;

    if (sVarFifoRdIdx == sVarFifoWrIdx) {
        // no response expected
        return;
    }

    rdIdx = sVarFifoRdIdx;
    do {
        vtd = &sVarTransactionFifo[rdIdx];
        if ((addr == vtd->addr) && (vtd->idx == respGet->index) && (respGet->length == vtd->size)) {
            break;
        }
        IDX_INC(rdIdx);
    } while (rdIdx != sVarFifoWrIdx);

    if (rdIdx != sVarFifoWrIdx) {
        for (i = 0; i < vtd->size; i++) {
            *((uint8_t *)vtd->buf + i) = respGet->data[i];
        }
        vtd->state = eBusVarState_Ready;
    }
}

static void Process(TVarTransactionDesc *vtd) {

    static TBusTelegram  sTxMsg;
    uint16_t actualTime16;
    uint8_t i;

    GET_TIME_MS16(actualTime16);

    switch (vtd->state) {
    case eBusVarState_Scheduled:
        sTxMsg.senderAddr = sMyAddr;
        sTxMsg.msg.devBus.receiverAddr = vtd->addr;
        if (vtd->dir == eBusVarRead) {
            sTxMsg.type = eBusDevReqGetVar;
            sTxMsg.msg.devBus.x.devReq.getVar.index = vtd->idx;
        } else {
            sTxMsg.type = eBusDevReqSetVar;
            sTxMsg.msg.devBus.x.devReq.setVar.index = vtd->idx;
            sTxMsg.msg.devBus.x.devReq.setVar.length = vtd->size;
            for (i = 0; i < vtd->size; i++) {
                sTxMsg.msg.devBus.x.devReq.setVar.data[i] = *((uint8_t *)vtd->buf + i);
            }
        }
        if (BusSend(&sTxMsg) == BUS_SEND_OK) {
            vtd->state = eBusVarState_Waiting;
        } else {
            vtd->state = eBusVarState_TxRetry;
        }
        vtd->txTime = actualTime16;
        break;
    case eBusVarState_Waiting:
        if ((actualTime16 - vtd->txTime) > RESPONSE_TIMEOUT) {
            vtd->state = eBusVarState_Timeout;
        }
        break;
    case eBusVarState_TxRetry:
        if ((actualTime16 - vtd->txTime) > TX_RETRY_TIMEOUT) {
            if (vtd->txRetryCnt > 0) {
                if (BusSend(&sTxMsg) == BUS_SEND_OK) {
                    vtd->state = eBusVarState_Waiting;
                } else {
                    vtd->state = eBusVarState_TxRetry;
                    vtd->txRetryCnt--;
                }
                vtd->txTime = actualTime16;
            } else {
                vtd->state = eBusVarState_TxError;
            }
        }
        break;
    case eBusVarState_Timeout:
    case eBusVarState_TxError:
    case eBusVarState_Ready:
        // do nothing - transaction shall be closed by user
        break;
    default:
        break;
    }
}

void BusVarProcess(void) {
    uint8_t rdIdx;
    TVarTransactionDesc *vtd;

    if (sVarFifoRdIdx == sVarFifoWrIdx) {
        return;
    }
    for (rdIdx = sVarFifoRdIdx; rdIdx != sVarFifoWrIdx; ) {
        vtd = &sVarTransactionFifo[rdIdx];
        if (vtd->state != eBusVarState_Invalid) {
            Process(vtd);
        }
        IDX_INC(rdIdx);
    }
}

bool BusVarSetInfo(uint8_t idx, const char *name, TBusVarType type, TBusVarMode mode) {
    return true;
}
