busmaster/homebus/projects/klaus_visu_ap420/smartmeterwindow.cpp

#include <stdio.h>
#include "smartmeterwindow.h"
#include "ui_smartmeterwindow.h"

smartmeterwindow::smartmeterwindow(QWidget *parent, ioState *state) :
    QDialog(parent),
    ui(new Ui::smartmeterwindow) {
    ui->setupUi(this);
    io = state;
    isVisible = false;

    connect(parent, SIGNAL(screenSaverActivated()), this, SLOT(onScreenSaverActivation()));
    connect(this, SIGNAL(messagePublish(const char*,const char*)),
            parent, SLOT(onMessagePublish(const char*,const char*)));
    connect(parent, SIGNAL(meterChanged()), this, SLOT(onMeterChanged()));
    connect(parent, SIGNAL(storageChanged()), this, SLOT(onStorageChanged()));
}

smartmeterwindow::~smartmeterwindow() {
    delete ui;
}

void smartmeterwindow::onScreenSaverActivation(void) {
    if (isVisible) {
        hide();
    }
}

void smartmeterwindow::show(void) {

    isVisible = true;
    QString str;
    str = "Speicher";
    ui->label_storage_power->setText(str);
    str = "Speicherstand";
    ui->label_storage_soc->setText(str);
    str = "Netzleistung";
    ui->label_p->setText(str);
    str = "Bezug Tag";
    ui->label_aplus_day->setText(str);
    str = "Einspeisung Tag";
    ui->label_aminus_day->setText(str);
    str = "PV Tag";
    ui->label_solar_day->setText(str);
    str = "PV Leistung";
    ui->label_solar_power->setText(str);

    onMeterChanged();
    onStorageChanged();

    QDialog::show();
}

void smartmeterwindow::hide(void) {

    isVisible = false;
    QDialog::hide();
}

void smartmeterwindow::onMeterChanged(void) {

    uint32_t counter;
    uint32_t power;

    if (!isVisible) {
        return;
    }

    if (io->sm.p_plus > io->sm.p_minus) {
        ui->label_p_val->setStyleSheet("background-color: rgba(255, 255, 255, 0);color: red;font: 24pt \"Sans\"");
        ui->label_p_val->setText(QString::number(io->sm.p_plus - io->sm.p_minus) + " W");
    } else {
        ui->label_p_val->setStyleSheet("background-color: rgba(255, 255, 255, 0);color: green;font: 24pt \"Sans\"");
        ui->label_p_val->setText(QString::number(io->sm.p_minus - io->sm.p_plus) + " W");
    }
    counter = io->sm.a_plus - io->sm.a_plus_midnight;
    ui->label_aplus_day_val->setText(QString::asprintf("%d.%03d kWh", counter / 1000, counter % 1000));
    counter = io->sm.a_minus - io->sm.a_minus_midnight;
    ui->label_aminus_day_val->setText(QString::asprintf("%d.%03d kWh", counter / 1000, counter % 1000));

    counter = io->sy.oben_ost + io->sy.oben_mitte + io->sy.oben_west +
              io->sy.unten_ost + io->sy.unten_mitte + io->sy.unten_west +
              io->pv.yield;
    ui->label_solar_day_val->setText(QString::asprintf("%d.%03d kWh", counter / 1000, counter % 1000));

    power = io->sp.rechts + io->sp.mitte + io->sp.links + io->pv.output_power;
    ui->label_solar_power_val->setText(QString::asprintf("%d.%01d W", power / 10, power % 10));

}

void smartmeterwindow::onStorageChanged(void) {

    QString str;
    int sign;

    if (!isVisible) {
        return;
    }

    ui->label_storage_soc_val->setText(QString::asprintf("%.3f kWh (%.1f %%)", (qreal)io->storage.energy / 1000.0, io->storage.soc));
    if (io->storage.ac_power > 0) {
        ui->label_storage_power_val->setStyleSheet("background-color: rgba(255, 255, 255, 0);color: red;font: 24pt \"Sans\"");
        str = "Speicher entladen";
        sign = 1;
    } else {
        ui->label_storage_power_val->setStyleSheet("background-color: rgba(255, 255, 255, 0);color: green;font: 24pt \"Sans\"");
        str = "Speicher laden";
        sign = -1;
    }
    ui->label_storage_power->setText(str);
    ui->label_storage_power_val->setText(QString::asprintf("%d W", sign * io->storage.ac_power));

}

void smartmeterwindow::on_pushButtonBack_clicked() {
    hide();
}
