busmaster/homebus/projects/klaus_visu_ap420/ogwindow.h

#ifndef OGWINDOW_H
#define OGWINDOW_H

#include <stdint.h>
#include <QDialog>
#include <QMqttClient>
#include "iostate.h"

namespace Ui {
class ogwindow;
}

class ogwindow : public QDialog {
    Q_OBJECT

public:
    explicit ogwindow(QWidget *parent, ioState *state);
    ~ogwindow();
    void show(void);
    void hide(void);

signals:
    void messagePublish(const char *, const char *);

private slots:
    void onIoStateChanged(void);

    void on_pushButtonLightAnna_pressed();
    void on_pushButtonLightSeverin_pressed();
    void on_pushButtonLightWC_pressed();
    void on_pushButtonLightBad_pressed();
    void on_pushButtonLightBadSpiegel_pressed();
    void on_pushButtonLightVorraum_pressed();
    void on_pushButtonLightStiege_pressed();
    void on_pushButtonLightSchlaf_pressed();
    void on_pushButtonLightSchrank_pressed();
    void on_pushButtonBack_clicked();

private:
    Ui::ogwindow *ui;
    ioState *io;
    bool isVisible;
};

#endif // OGWINDOW_H
