busmaster/homebus/include/devices/do8/sio_c.h

/*
 * sio_c.h
 *
 * Copyright 2016 Klaus Gusenleitner <klaus.gusenleitner@gmail.com>
 *
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
 *
 */

#ifndef _SIO_C_H
#define _SIO_C_H

#ifdef __cplusplus
extern "C" {
#endif

/* buffer sizes */
#define SIO_RX_BUF_SIZE 64  /* must be power of 2 */
#define SIO_TX_BUF_SIZE 128 /* must be power of 2 */

/* usart channel */
#define SIO               1
#define SIO_UDRE_INT_VEC  USART1_UDRE_vect
#define SIO_TXC_INT_VEC   USART1_TX_vect
#define SIO_RXC_INT_VEC   USART1_RX_vect

/* ext interrupt */
#define SIO_EI_VEC        INT1_vect
#define SIO_EI_EIMSK      INT1
#define SIO_EI_EIFR       INTF1
#define SIO_EI_EICRA_SC0  ISC10
#define SIO_EI_EICRA_SC1  ISC11

/* timer OC3B - no timer mode and prescaler settings (timer3 OCA is used as system clock) */
#define SIO_TIMER_VEC        TIMER3_COMPB_vect
#define SIO_TIMER_TCNT       TCNT3
#define SIO_TIMER_TIMSK      TIMSK3
#define SIO_TIMER_TIMSK_OCIE OCIE3B
#define SIO_TIMER_OCR        OCR3B
#define SIO_TIMER_TIFR       TIFR3
#define SIO_TIMER_TIFR_OCF   OCF3B

#if (F_CPU == 7372800UL)
#define TIMER_MS1       29     // clock prescaler is 256 (main.c): 29 * 256 / 7372800 = 1
#define TIMER_MS2       58     // clock prescaler is 256 (main.c): 58 * 256 / 7372800 = 2
#elif (F_CPU == 3686400UL)
#define TIMER_MS1       15     // clock prescaler is 256 (main.c): 15 * 256 / 3686400 = 1
#define TIMER_MS2       30     // clock prescaler is 256 (main.c): 30 * 256 / 3686400 = 2
#elif (F_CPU == 1843200UL)
#define TIMER_MS1       8      // clock prescaler is 256 (main.c): 8 * 256 / 1843200 = 1
#define TIMER_MS2       16     // clock prescaler is 256 (main.c): 16 * 256 / 1843200 = 2
#else
#error adjust sio timer settings for your CPU clock frequency
#endif

#ifdef __cplusplus
}
#endif

#endif
