busmaster/homebus/tools/modulservice/main.c

/*
 * main.c
 *
 * Copyright 2013 Klaus Gusenleitner <klaus.gusenleitner@gmail.com>
 *
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
 *
 */

#include <stdint.h>
#include <stdbool.h>
#include <stdio.h>
#include <stdlib.h>
#include <string.h>
#include <time.h>
#include <unistd.h>
#ifdef WIN32
#include <conio.h>
#include <windows.h>
#endif

#include "sio.h"
#include "bus.h"

/*-----------------------------------------------------------------------------
*  Macros
*/

#define SIZE_COMPORT   100

/* eigene Adresse am Bus */
#define MY_ADDR    myAddr

/* default timeout for receiption of response telegram */
#define RESPONSE_TIMEOUT          1000 /* ms */
#define RESPONSE_TIMEOUT_ACTVAL   15000 /* ms */

#define OP_INVALID                          0
#define OP_SET_NEW_ADDRESS                  1
#define OP_SET_CLIENT_ADDRESS_LIST          2
#define OP_GET_CLIENT_ADDRESS_LIST          3
#define OP_RESET                            4
#define OP_EEPROM_READ                      5
#define OP_EEPROM_WRITE                     6
#define OP_GET_ACTUAL_VALUE                 7
#define OP_SET_VALUE_DO31_DO                8
#define OP_SET_VALUE_DO31_SH                9
#define OP_SET_VALUE_SW8                    10
#define OP_SET_VALUE_SW16                   11
#define OP_SET_VALUE_RS485IF                13
#define OP_SET_VALUE_PWM4                   14
#define OP_SET_VALUE_KEYRC                  15
#define OP_INFO                             16
#define OP_EXIT                             17
#define OP_CLOCK_CALIB                      18
#define OP_SWITCH_STATE                     19
#define OP_HELP                             20
#define OP_GET_INFO_RANGE                   21
#define OP_DIAG                             22
#define OP_SET_VAR                          23
#define OP_GET_VAR                          24
#define OP_SET_VALUE_DO8_DO                 25
#define OP_SET_VALUE_DO8_SH                 26

#define SIZE_CLIENT_LIST                    BUS_MAX_CLIENT_NUM

#define SIZE_EEPROM_BUF                     100

#define CMD_SIZE                            300

/*-----------------------------------------------------------------------------
*  Typedefs
*/

/*-----------------------------------------------------------------------------
*  Variables
*/
static uint8_t myAddr = 0;

/*-----------------------------------------------------------------------------
*  Functions
*/
static void PrintUsage(void);
static bool ModuleReset(uint8_t address);
static bool ModuleNewAddress(uint8_t address, uint8_t newAddress);
static bool ModuleReadClientAddress(uint8_t address, uint8_t *pList, uint8_t listLen);
static bool ModuleSetClientAddress(uint8_t address, uint8_t *pList, uint8_t listLen);
static bool ModuleReadEeprom(uint8_t address, uint8_t *pBuf, unsigned int bufLen, unsigned int eepromAddress);
static bool ModuleWriteEeprom(uint8_t address, uint8_t *pBuf, unsigned int bufLen, unsigned int eepromAddress);
static bool ModuleGetActualValue(uint8_t address, TBusDevRespActualValue *pBuf);
static bool ModuleSetValue(uint8_t address, TBusDevReqSetValue *pBuf);
static bool ModuleInfo(uint8_t address, TBusDevRespInfo *pBuf, uint16_t resp_timeout);
static bool ModuleDiag(uint8_t address, TBusDevRespDiag *pBuf, uint16_t resp_timeout);
static bool ModuleClockCalib(uint8_t address, uint8_t calibAddress);
static bool SwitchEvent(uint8_t clientAddr, uint8_t state);
static bool SetVar(uint8_t clientAddr, TBusDevReqSetVar *pBuf, TBusVarResult *result);
static bool GetVar(uint8_t clientAddr, uint8_t index, TBusDevRespGetVar *pBuf);
static int  GetOperation(int argc, char *argv[], int *pArgi);

#ifndef WIN32
static unsigned long GetTickCount(void);
#endif
/*-----------------------------------------------------------------------------
*  program start
*/
int main(int argc, char *argv[]) {

    int                    handle;
    int                    i;
    int                    j;
    int                    k;
    char                   comPort[SIZE_COMPORT] = "";
    int                    operation;
    uint8_t                clientList[SIZE_CLIENT_LIST];
    uint8_t                eepromData[SIZE_EEPROM_BUF];
    uint8_t                moduleAddr;
    uint8_t                newModuleAddr;
    unsigned int           eepromAddress;
    unsigned int           eepromLength;
    uint8_t                *pBuf;
    bool                   ret = false;
    uint8_t                mask;
    TBusDevRespActualValue actVal;
    TBusDevReqSetValue     setVal;
    TBusDevRespInfo        info;
    TBusDevRespDiag        diag;
    TBusDevReqSetVar       setVar;
    TBusDevRespGetVar      getVar;
    TBusVarResult          varResult;
    bool                   server_run = false;
    uint8_t                len;
    int                    argi;
    char                   buffer[CMD_SIZE];
    char                   *p;
    uint8_t                val8;
    uint8_t                defaultMyAddr = 0;

    for (i = 1; i < argc; i++) {
        if (strcmp(argv[i], "-c") == 0) {
            /* get com interface */
            if (argc > i) {
                strncpy(comPort, argv[i + 1], sizeof(comPort) - 1);
                comPort[sizeof(comPort) - 1] = '\0';
                i++;
            }
        } else if (strcmp(argv[i], "-a") == 0) {
            if (argc > i) {
                moduleAddr = atoi(argv[i + 1]);
                i++;
            }
        } else if (strcmp(argv[i], "-o") == 0) {
            if (argc > i) {
                myAddr = atoi(argv[i + 1]);
                defaultMyAddr = myAddr;
                i++;
            }
        } else if (strcmp(argv[i], "-s") == 0) {
            server_run = true;
            break;
        }
    }
    if (strlen(comPort) == 0) {
        PrintUsage();
        return -1;
    }

    SioInit();
    handle = SioOpen(comPort, eSioBaud9600, eSioDataBits8, eSioParityNo, eSioStopBits1, eSioModeHalfDuplex);
    if (handle == -1) {
        printf("cannot open %s\n", comPort);
        return -1;
    }

    // wait for sio input to settle and the flush
    usleep(100000);
    while ((len = SioGetNumRxChar(handle)) != 0) {
        SioRead(handle, &val8, sizeof(val8));
    }
    BusInit(handle);

    do {
        if (server_run) {
            p = fgets(buffer, sizeof(buffer), stdin);
            if (p == 0) {
                printf("error/EOF on reading from stdin. exiting\n");
                ret = 0;
                break;
            }
            /* remove the terminating newline */
            buffer[strlen(buffer) - 1] = '\0';
            p = strtok(buffer, " ");
            argc = 1;
            while (p != 0) {
                argv[argc] = p;
                p = strtok(0, " ");
                argc++;
            }

            myAddr = defaultMyAddr;

            for (i = 0; i < argc; i++) {
                if ((strcmp(argv[i], "-a") == 0) &&
                    (argc > i)) {
                    moduleAddr = atoi(argv[i + 1]);
                } else  if ((strcmp(argv[i], "-o") == 0) &&
                    (argc > i)) {
                    myAddr = atoi(argv[i + 1]);
                }
            }
        }
        operation = GetOperation(argc, argv, &argi);
        switch (operation) {
        case OP_SET_NEW_ADDRESS:
            newModuleAddr = atoi(argv[argi]);
            ret = ModuleNewAddress(moduleAddr, newModuleAddr);
            if (ret) {
                printf("OK\n");
            }
            break;
        case OP_SET_CLIENT_ADDRESS_LIST:
            memset(clientList, 0xff, sizeof(clientList));
            for (j = argi, k = 0; (j < argc) && (k < (int)sizeof(clientList)); j++, k++) {
                clientList[k] = atoi(argv[j]);
            }
            ret = ModuleSetClientAddress(moduleAddr, clientList, sizeof(clientList));
            if (ret) {
                printf("OK\n");
            }
            break;
        case OP_GET_CLIENT_ADDRESS_LIST:
            ret = ModuleReadClientAddress(moduleAddr, clientList, sizeof(clientList));
            if (ret) {
                printf("client list: ");
                for (i = 0; i < (int)sizeof(clientList); i++) {
                    printf("%02x ", clientList[i]);
                }
                printf("\n");
            }
            break;
        case OP_RESET:
            ret = ModuleReset(moduleAddr);
            if (ret) {
                printf("OK\n");
            }
            break;
        case OP_EEPROM_READ:
            eepromAddress = atoi(argv[argi]);
            if (argc > (argi + 1)) {
                eepromLength = atoi(argv[argi + 1]);
                pBuf = (uint8_t *)malloc(eepromLength);
                if (pBuf != 0) {
                    ret = ModuleReadEeprom(moduleAddr, pBuf, eepromLength, eepromAddress);
                    if (ret) {
                        eepromLength += eepromAddress % 16;
                        printf("eeprom dump:");
                        for (i = 0; i < (int)eepromLength; i++) {
                            if ((i % 16) == 0) {
                                printf("\n%04x: ", eepromAddress + i - eepromAddress % 16);
                            }
                            if (i < ((int)eepromAddress % 16)) {
                                printf("   ");
                            } else {
                                printf("%02x ", *(pBuf + i - eepromAddress % 16));
                            }
                        }
                        printf("\n");
                    }
                    free(pBuf);
                } else {
                    printf("cannot allocate memory for command execution\n");
                }
            }
            break;
        case OP_EEPROM_WRITE:
            eepromAddress = atoi(argv[argi]);
            eepromLength = 0;
            for (j = argi + 1, k = 0; (j < argc) && (k < (int)sizeof(eepromData)); j++, k++) {
                int base = 10;
                if ((strncmp(argv[j], "0x", 2) == 0) || (strncmp(argv[j], "0X", 2) == 0)) {
                    base = 16;
                }
                eepromData[k] = (uint8_t)strtoul(argv[j], 0, base);
                eepromLength++;
            }
            ret = ModuleWriteEeprom(moduleAddr, eepromData, eepromLength, eepromAddress);
            if (ret) {
                printf("OK\n");
            }
            break;
        case OP_GET_ACTUAL_VALUE:
            ret = ModuleGetActualValue(moduleAddr, &actVal);
            if (ret) {
                printf("devType: ");
                switch (actVal.devType) {
                case eBusDevTypeDo31:
                    printf("DO31");
                    break;
                case eBusDevTypeDo8:
                    printf("DO8");
                    break;
                case eBusDevTypeSw8:
                    printf("SW8");
                    break;
                case eBusDevTypeSw16:
                    printf("SW16");
                    break;
                case eBusDevTypeLum:
                    printf("LUM");
                    break;
                case eBusDevTypeLed:
                    printf("LED");
                    break;
                case eBusDevTypeWind:
                    printf("WIND");
                    break;
                case eBusDevTypeRs485If:
                    printf("RS485IF");
                    break;
                case eBusDevTypePwm4:
                    printf("PWM4");
                    break;
                case eBusDevTypeSmIf:
                    printf("SMIF");
                    break;
                case eBusDevTypeKeyb:
                    printf("KEYB");
                    break;
                case eBusDevTypeKeyRc:
                    printf("KEYRC");
                    break;
                case eBusDevTypeSg:
                    printf("SG");
                    break;
                default:
                    break;
                }
                switch (actVal.devType) {
                case eBusDevTypeDo31:
                    printf("\ndigout: ");
                    for (i = 0; i < sizeof(actVal.actualValue.do31.digOut); i++) {
                        for (j = 0, mask = 1; j < 8; j++, mask <<= 1) {
                            if ((i == 3) && (j == 7)) {
                                // DO31 has 31 outputs, dont display last bit
                                break;
                            }
                            if (actVal.actualValue.do31.digOut[i] & mask) {
                                printf("1");
                            } else {
                                printf("0");
                            }
                        }
                        printf(" ");
                    }
                    printf("\nshader: ");
                    for (i = 0; i < sizeof(actVal.actualValue.do31.shader); i++) {
                        printf("%02x ", actVal.actualValue.do31.shader[i]);
                    }
                    printf("\n");
                    break;
                case eBusDevTypeDo8:
                    printf("\ndigout: ");
                    for (i = 0; i < sizeof(actVal.actualValue.do8.digOut); i++) {
                        for (j = 0, mask = 1; j < 8; j++, mask <<= 1) {
                            if (actVal.actualValue.do8.digOut[i] & mask) {
                                printf("1");
                            } else {
                                printf("0");
                            }
                        }
                        printf(" ");
                    }
                    printf("\nshader: ");
                    for (i = 0; i < sizeof(actVal.actualValue.do8.shader); i++) {
                        printf("%02x ", actVal.actualValue.do8.shader[i]);
                    }
                    printf("\n");
                    break;
                case eBusDevTypeSw8:
                    printf("\niostate: ");
                    for (j = 0, mask = 1; j < 8; j++, mask <<= 1) {
                        if (actVal.actualValue.sw8.state & mask) {
                            printf("1");
                        } else {
                            printf("0");
                        }
                    }
                    printf("\n");
                    break;
                case eBusDevTypeSw16:
                    printf("\ninput state: ");
                    for (j = 0, mask = 1; j < 8; j++, mask <<= 1) {
                        if (actVal.actualValue.sw16.input_state & mask) {
                            printf("1");
                        } else {
                            printf("0");
                        }
                    }
                    printf("\nled state: ");
                    for (i = 0; i < sizeof(actVal.actualValue.sw16.led_state); i++) {
                        printf("%x %x ", actVal.actualValue.sw16.led_state[i] & 0x0f, 
                                        (actVal.actualValue.sw16.led_state[i] & 0xf0) >> 4);
                    }
                    printf("\n");
                    break;
                case eBusDevTypeLum:
                    printf("\nstate: ");
                    for (j = 0, mask = 1; j < 8; j++, mask <<= 1) {
                        if (actVal.actualValue.lum.state & mask) {
                            printf("1");
                        } else {
                            printf("0");
                        }
                    }
                    printf("\nADC:   0x%04x\n", actVal.actualValue.lum.lum_low | (actVal.actualValue.lum.lum_high << 8));
                    break;
                case eBusDevTypeLed:
                    printf("\nLED state: %02x\n", actVal.actualValue.led.state);
                    break;
                case eBusDevTypeWind:
                    printf("\nstate: ");
                    for (j = 0, mask = 1; j < 8; j++, mask <<= 1) {
                        if (actVal.actualValue.wind.state & mask) {
                            printf("1");
                        } else {
                            printf("0");
                        }
                    }
                    printf("\nWIND:  0x%02x\n", actVal.actualValue.wind.wind);
                    break;
                case eBusDevTypeRs485If:
                    printf("\nstate: ");
                    for (i = 0; i < sizeof(actVal.actualValue.rs485if.state); i++) {
                        printf("%02x ", actVal.actualValue.rs485if.state[i]);
                    }
                    printf("\n");
                    break;
                case eBusDevTypePwm4:
                    printf("\nstate: %02x\n", actVal.actualValue.pwm4.state);
                    printf("pwm: ");
                    for (i = 0; i < BUS_PWM4_PWM_SIZE_ACTUAL_VALUE; i++) {
                        printf("%04x ", actVal.actualValue.pwm4.pwm[i]);
                    }
                    printf("\n");
                    break;
                case eBusDevTypeSmIf:
                    printf("\n");
                    printf("A+: %d Wh\n", actVal.actualValue.smif.countA_plus);
                    printf("A-: %d Wh\n", actVal.actualValue.smif.countA_minus);
                    printf("R+: %d varh\n", actVal.actualValue.smif.countR_plus);
                    printf("R-: %d varh\n", actVal.actualValue.smif.countR_minus);
                    printf("P+: %d W\n", actVal.actualValue.smif.activePower_plus);
                    printf("P-: %d W\n", actVal.actualValue.smif.activePower_minus);
                    printf("Q+: %d var\n", actVal.actualValue.smif.reactivePower_plus);
                    printf("Q-: %d var\n", actVal.actualValue.smif.reactivePower_minus);
                    break;
                case eBusDevTypeKeyRc:
                    printf("\n");
                    printf("lock state: ");
                    switch (actVal.actualValue.keyrc.state) {
                    case eBusLockInternal:     printf("internal"); break;
                    case eBusLockInvalid1:     printf("invalid1"); break;
                    case eBusLockInvalid2:     printf("invalid2"); break;
                    case eBusLockNoResp:       printf("no response"); break;
                    case eBusLockNoConnection: printf("no connection"); break;
                    case eBusLockUncalib:      printf("not calibrated"); break;
                    case eBusLockUnlocked:     printf("unlocked"); break;
                    case eBusLockLocked:       printf("locked"); break;
                    case eBusLockAgain:        printf("again"); break;
                    default:                   printf("unsupported state");break;
                    }
                    printf("\n");
                    break;
                case eBusDevTypeSg:
                    printf("\n");
                    printf("output: %02x\n", actVal.actualValue.sg.output);
                default:
                    break;
                }
                printf("OK\n");
            }
            break;
        case OP_SET_VALUE_DO31_DO:
            setVal.devType = eBusDevTypeDo31;
            memset(setVal.setValue.do31.digOut, 0, sizeof(setVal.setValue.do31.digOut)); // default: no change
            memset(setVal.setValue.do31.shader, 254, sizeof(setVal.setValue.do31.shader)); // default: no change
            for (j = argi, k = 0; (j < argc) && (k < (int)(sizeof(setVal.setValue.do31.digOut) * 4 - 1)); j++, k++) {
                setVal.setValue.do31.digOut[k / 4] |= ((uint8_t)atoi(argv[j]) & 0x03) << ((k % 4) * 2);
            }
            ret = ModuleSetValue(moduleAddr, &setVal);
            if (ret) {
                printf("OK\n");
            }
            break;
        case OP_SET_VALUE_DO31_SH:
            setVal.devType = eBusDevTypeDo31;
            memset(setVal.setValue.do31.digOut, 0, sizeof(setVal.setValue.do31.digOut)); // default: no change
            memset(setVal.setValue.do31.shader, 254, sizeof(setVal.setValue.do31.shader)); // default: no change
            for (j = argi, k = 0; (j < argc) && (k < (int)sizeof(setVal.setValue.do31.shader)); j++, k++) {
                setVal.setValue.do31.shader[k] = (uint8_t)atoi(argv[j]);
            }
            ret = ModuleSetValue(moduleAddr, &setVal);
            if (ret) {
                printf("OK\n");
            }
            break;
        case OP_SET_VALUE_DO8_DO:
            setVal.devType = eBusDevTypeDo8;
            memset(setVal.setValue.do8.digOut, 0, sizeof(setVal.setValue.do8.digOut)); // default: no change
            memset(setVal.setValue.do8.shader, 254, sizeof(setVal.setValue.do8.shader)); // default: no change
            for (j = argi, k = 0; (j < argc) && (k < (int)(sizeof(setVal.setValue.do8.digOut) * 4)); j++, k++) {
                setVal.setValue.do8.digOut[k / 4] |= ((uint8_t)atoi(argv[j]) & 0x03) << ((k % 4) * 2);
            }
            ret = ModuleSetValue(moduleAddr, &setVal);
            if (ret) {
                printf("OK\n");
            }
            break;
        case OP_SET_VALUE_DO8_SH:
            setVal.devType = eBusDevTypeDo8;
            memset(setVal.setValue.do8.digOut, 0, sizeof(setVal.setValue.do8.digOut)); // default: no change
            memset(setVal.setValue.do8.shader, 254, sizeof(setVal.setValue.do8.shader)); // default: no change
            for (j = argi, k = 0; (j < argc) && (k < (int)sizeof(setVal.setValue.do8.shader)); j++, k++) {
                setVal.setValue.do8.shader[k] = (uint8_t)atoi(argv[j]);
            }
            ret = ModuleSetValue(moduleAddr, &setVal);
            if (ret) {
                printf("OK\n");
            }
            break;
        case OP_SET_VALUE_SW8:
            setVal.devType = eBusDevTypeSw8;
            memset(setVal.setValue.sw8.digOut, 0, sizeof(setVal.setValue.sw8.digOut)); // default: no change
            for (j = argi, k = 0; (j < argc) && (k < (int)(sizeof(setVal.setValue.sw8.digOut) * 4)); j++, k++) {
                setVal.setValue.sw8.digOut[k / 4] |= ((uint8_t)atoi(argv[j]) & 0x03) << ((k % 4) * 2);
            }
            ret = ModuleSetValue(moduleAddr, &setVal);
            if (ret) {
                printf("OK\n");
            }
            break;
        case OP_SET_VALUE_SW16:
            setVal.devType = eBusDevTypeSw16;
            memset(setVal.setValue.sw16.led_state, 0, sizeof(setVal.setValue.sw16.led_state));
            for (j = argi, k = 0; (j < argc) && (k < (int)(sizeof(setVal.setValue.sw16.led_state) * 2)); j++, k++) {
                setVal.setValue.sw16.led_state[k / 2] |= ((uint8_t)atoi(argv[j]) & 0x0F) << ((k % 2) * 4);
            }
            ret = ModuleSetValue(moduleAddr, &setVal);
            if (ret) {
                printf("OK\n");
            }
            break;
        case OP_SET_VALUE_RS485IF:
            setVal.devType = eBusDevTypeRs485If;
            memset(setVal.setValue.rs485if.state, 0, sizeof(setVal.setValue.rs485if.state));
            for (j = argi, k = 0; (j < argc) && (k < (int)sizeof(setVal.setValue.rs485if.state)); j++, k++) {
                setVal.setValue.rs485if.state[k] = (uint8_t)atoi(argv[j]);
            }
            ret = ModuleSetValue(moduleAddr, &setVal);
            if (ret) {
                printf("OK\n");
            }
            break;
        case OP_SET_VALUE_PWM4:
            setVal.devType = eBusDevTypePwm4;
            memset(setVal.setValue.pwm4.pwm, 0, sizeof(setVal.setValue.pwm4.pwm));
            setVal.setValue.pwm4.set = 0;
            for (j = argi, k = 0; (j < argc) && (k < (int)sizeof(setVal.setValue.pwm4.pwm)); j++) {
                if ((j % 2) == 0) {
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
