busmaster/homebus/(commit log)

2012-10-26 added missing assembler files and makefile changes
2012-12-23 correction of typing error, upper case file name
    [digout.c]
2012-12-28 new project klaus241, error correction simultanous botton press
    [application.c, application.h, button.c, digout.c, digout.h]
2013-01-28 correction of monitor timestamp
    [main.c]
2013-01-29 correction of kbhit function (long delay)
    [main.c]
2013-03-06 correction of month calculation in monitor log
    [main.c]
2013-04-13 error correction for buttion press timeout, compiler warnings avr sio
    [main.c]
2013-05-23 redesign for bus.c, inserted GPL header, new example projects
    [application.c, application.h, board.h, bus.c, bus.h, button.c, button.h, digout.c]
2013-05-23 bootloader project changes due to bus.c redesign
    [bus.c, main.c, siotype0poll.c]
2013-05-25 toggle lights in living room when the doorbell button is pressed (project klaus240)
2013-05-25 extended switch event evaluation for bit 1 in eBusDevReqSwitchState
2013-05-25 extension of TBusDevRespActualValue by TBusDevActualValueSw8 (usage in project switchv8_garage)
2013-05-27 new project for luminance switch
2013-05-27 removed support for GetState request in switchv2_* projects (replaced by ActualValue request)
    [main.c]
2013-07-16 change of measurement resolution by adding an external pullup (switched by SW)
2013-07-16 do initial ADC conversion twice to get a more precise start value
2013-08-16 based portserver device status changes on inotify
2013-09-08 missing devType printing at info command
    [main.c]
2013-09-08 frame based tx
2013-09-28 problem with index calculation in case of uint8_t overrun (BusSend eBusDevStartup)
    [bus.c]
2013-12-17 register access error in case of txing jam character
2013-12-17 invalid external interrupt setup for start bit detection
2014-01-19 new version strings for switchv2_lum and grg
2014-01-21 set low bits of adc conversion to 0
2014-01-23 control shader on luminance switch events
2014-04-28 voltile definition for variable changed by interrupt routine
2014-06-27 uncomment power fail detection code (unintentional added debug code)
    [main.c]
2014-10-14 new switch for lamp kitchen wall
2014-10-28 new telegram types for RespActualValue and RespInfo for LED devices
2014-10-28 support of LED devices in modulservice
2014-10-28 new project for LED devices
2015-01-19 add support for setvaluesw8 (switchv2_grg)
2015-03-16 extension for device type sw16 (bcu)
2015-03-16 i2c for bcu
2015-03-23 tools makefiles corrections for win32
    [main.c, sio.c]
2015-03-23 fuse bit setting description for usbif
2015-03-24 switch off portserver logging
2015-05-11 correction of DO31 event response timeout and button pressed repeat timeout
    [button.c, main.c]
2015-05-11 error correct for DEBUG_LOG switch
    [main.c]
2015-05-19 protocol extension for wind sensor
2015-05-19 initial version of wind sensor firmware
2015-06-01 set default position to 50% from 100% at power on
2015-06-01 wind sensor application integration
2015-06-15 separate cellar lights of stairs and hall
2015-06-27 decoding of lastest frame type extension, ctrl-c for exit
2015-09-22 uart device error check and reopen
    [main.c]
2015-09-22 log print correction
2015-09-26 there is no need anymore that sio tty device exists at process start
2015-10-05 correction of sending actual state event to multiple clients
    [main.c]
2015-10-05 replace switchState by actualValue events
    [main.c]
2015-11-17 add switchable socket-outlet for reading lamp
2015-11-22 switchable socket-outlet for internet router
2015-11-28 status led integration
2015-11-29 allow client pty while sio device is not yet available
2015-12-01 mega88 clock calibration
2015-12-05 humidity and temperature are sometimes not up to date
2016-01-25 new bus telegram types for clock calibration
2016-01-25 clock calibration
2016-01-25 clock calibraton firmware for atmega88 based devices
2016-01-26 monitor support for clock calibration
2016-02-09 sio driver reports one received character on startup
2016-02-16 hardware design rs485if
    [rs485if.brd, rs485if.sch]
2016-02-19 elko position move
    [rs485if.brd, rs485if.sch]
2016-02-24 missing return value for switchv*_bootloader bus.c
    [bus.c]
2016-02-25 Fix usage message in eventmonitor and monitor
    [main.c]
2016-02-29 firmwareupdate doesn't start due to buffered rx frames in sio device
    [main.c]
2016-03-08 comment correction, whitespace formatting
    [main.c]
2016-03-08 use of siosingle for switchv2
2016-03-13 board definition for rs484if
2016-03-13 board specific modules for rs485if
2016-03-19 correction of BUS_TRANSCEIVER_POWER_UP macro
    [board.h]
2016-03-19 part value actualization
    [rs485if.brd, rs485if.sch]
2016-04-10 correction of DMX test
    [main.c]
2016-05-09 change actval from max wind to current wind
2016-05-16 auto switch off for lamp in garage and bathroom
2016-05-30 correction of select rfds setup
    [main.c]
2016-09-18 change of socket_1 relais connection from NO to NC
2016-09-18 initial verion of pwm4 bootloader
2016-09-18 hardware design pwm4
    [pwm4.brd, pwm4.sch]
2016-09-19 new command: generate a switch event
2016-10-01 changed crystal frequency
    [pwm4.brd, pwm4.sch]
2016-10-01 add support for rs485if and pwm4 devices
2016-10-03 initial version of pwm4 application
2016-10-03 support setval for rs485if and pwm4
2016-10-03 support for rs485f and pwm4
2016-10-15 support rs485if and pwm4 actval
2016-10-15 optocoupler input and output resistor change
    [pwm4.brd, pwm4.sch]
2016-10-17 output restore on power on
2016-10-17 output spike when setting pwm to 0
2016-10-17 pwm for switch 46
2017-01-03 rearrangement of buttons
2017-01-31 pwm4: set pwm frequency to 900 Hz from 225 Hz
    This high frequency is required due to instability of the used power supply
    (Meanwell LRS-50-24).
2017-01-31 rs485if: add timer setting for sio
2017-01-31 pwm4 sio: support for additional cpu clocks
2017-02-18 eventmonitor: support device type PWM4
2017-02-27 changed pwm4setval mask to 2 bit command for each channel
2017-02-27 removed debug print
2017-02-28 pwm: extension of interface: separate function for on/off
2017-02-28 pwm4 application: use extended pwm interface
2017-02-28 visu: support pwm4 device
2017-02-28 new hardware: smartmeter interface
    [smartmeterif.brd, smartmeterif.sch]
2017-03-18 pwm4: renaming mask -> set
2017-03-19 monitor: outpur string correction for diag telegram
    [main.c]
2017-04-04 pwm4 application: delayed switch off of the common power supply
2017-04-04 smartmeterif hardware: value changes
    [smartmeterif.brd, smartmeterif.sch]
2017-04-17 visu: moved 'internet' button to setup window
2017-06-04 tools: mqtt: correction of own address usage
    [config.yaml, main.cpp]
2017-06-05 do31: eBusDevReqSetClientAddr does not work
    [main.c]
2017-06-19 pwm4: unable to switch on after power fail
    [main.c, pwm.c]
2017-06-20 tools: mqtt: correction of example configuration
    [config.yaml, main.cpp]
2017-07-02 tools: mqtt: command line parameter for broker address/port
    [main.cpp]
2017-07-15 tools: buttongpio: wrong telegram processing
    [main.c]
2017-07-15 tools: buttongpio: wait for bus device at startup
2017-07-25 tools: modulservice: support changed pwm4 actval protocol
2017-07-25 pwm4: wrong actval state
    [main.c]
2017-07-25 tools: mqtt: reconnect on broker disconnect
    [main.cpp]
2017-07-29 tools: mqtt: add PWM4 support
2017-08-09 tools: mqtt: sw8 device support
2017-10-17 change door bell from botton to switch
    On startup a switch sends its actual state, so lights connected to the
    door bell toggle once. This would switch on these lights on startup.
2017-10-17 buttongpio: trigger on swtichstate additionally
2017-10-31 switchv2a: replace switchState by actualValue telegrams
    [main.c, sio_c.h]
2017-11-07 switchv2_wind: decrease sensor sample period to 2 ms from 16 ms
2017-11-11 do31: support of TBusDevReqActualValueEvent/TBusDevInfoSw8 as switch input
2017-11-12 buttongpio: add supoort for eBusDevReqActualValueEvent/sw8 telegram
2017-11-20 visu: implement ButtonBackPressed to call dialog's hide methode
2017-11-20 visu: support mjpeg camera
2017-11-21 visu: bell button state is inverted
    [kameraeingangwindow.cpp, mainwindow.cpp]
2017-11-27 visu: remove moduleservice debug prints
2017-12-11 door light: mode select not working
    swtichung between AUTO and ON or AUTO and OFF works only for the first time.
    [application.c, setupwindow.cpp]
2017-12-11 add hardware
    [Cpu_digout_mega128.brd, Cpu_digout_mega128.sch, hub1.brd, hub1.sch, sw8.brd, sw8.sch, usbif2.brd, usbif2.sch]
2018-02-25 switchv2_garage: optimize for size
2018-02-25 switchv2_luminance: optimize for size
2018-04-08 monitor: wrong usage help for option logfile
    [main.c]
2018-10-08 bus: pwm16 protocol support
2019-11-25 do31: set reset state of interrupt mask registers
    The bootloader might leave interrupt mask register settings that
    can trigger unexcepted interrupts. These unexpected interrupt are
    handled by the default handler that calls the reset handler.
    [main.c]
2020-05-29 mqtt: add bus variable support
    bus device sends ReqSetVar to mqtt -> publish variable actual value
    publish variable set value to mqtt -> ReqSetVar to bus device
    To enable subscribtion to bus variables the bus device has to send ReqSetVar
    to mqtt virtual bus device.
2020-05-31 monitor: fix line feed output of RespSetVar
    [main.c]
2020-06-23 visu: replace the proprietary device access with mqtt
    [egwindow.cpp, egwindow.h, garagewindow.cpp, garagewindow.h, iostate.cpp, iostate.h, kameraeingangwindow.cpp, kuechewindow.cpp]
2020-07-03 smif: add ActualValueEvent for smartmeter data
    The ActualValueEvent is enabled by setting bus variable 0 to 1.
    After N seconds bus variable 0 is reset automatically. N is read from
    bus variable 1. The receiver address of the ActualValueEvent is read from
    bus varibale 2.
    [smartmeterif.c]
2020-07-04 smif: fix message type for ActualValueEvent
    [smartmeterif.c]
2020-07-09 bus: save firmware from device to file
2020-07-11 pwm4: support reading of firmware flash image
2020-07-14 firmwaresave: fix compiler warning
    [main.c]
2020-07-17 mqtt: do not call BusCheck multiple times in main loop
    When BusCheck is called it consumes the last packet from the receive queue.
    So serve_bus was disabled to get all packet from bus and some publish messages
    were missing sporadically.
    [main.cpp]
2020-07-21 mqtt: introduce a tx queue to send bus telegrams from subscription callback
    Sending bus telegrams has to wait for the response telegram in order not to
    overtax the target device.
2020-07-23 visu: fix exception on exit
    [statusled.cpp]
2020-07-25 visu: auto reconnect to mqtt broker
    [mainwindow.cpp, mainwindow.h]
2020-07-27 firmwareupdate: fix pointer arithmetics for 64 bit build
    [main.c]
2021-08-23 Integrate support for ABUS CFA3100
    CFA3100 is controlled by CFF3100 bluetooth remote control. Bus access to CFF3100 is implemented by
    cff3100if device. For user code input a keypad is used.
    Use case:
    1) User enters code at the keypad
    2) The keypad bus device, based on switchv2 hardware, sends the key codes entered to the
    cff3100if device
    3) The lock/unlock buttons on CFF3100 get "pressed" by cff3100if
    4) Lock/unlock bluetooth message is sent to CFA3100
    [cff3100if.brd, cff3100if.sch, sw8.brd, sw8.sch]
2021-08-23 hardware: Update sw8
    [sw8.brd, sw8.sch]
2021-09-05 hardware: cff3100if: Beautify schematic
    [cff3100if.sch]
2021-09-05 cff3100if: Reduce CPU load
    - Timer 2ms -> 8m
    - Reduce number of idle ops
2021-09-05 cff3100if: Fix key code handling
    [main.c]
2021-09-26 visu: generalize device support
    hwmon devices are searched by name.
2021-12-08 stoveguard: Add initial hardware revision
    [stoveguard.brd, stoveguard.sch]
2022-03-25 visu: Change to chunked mjpg transfer encoding
    Required due to camera update to Debian 11.
2022-07-30 hardware/smartmeterif: Board version 2
    - voltage regulator housing collision
    - size reduction
    [smartmeterif_2.brd, smartmeterif_2.sch]
2023-04-17 visu: Show current power
2023-08-27 klaus240: Add function for switching 'Licht Eingang' manually
2023-08-31 hardware: Add latest sch and brd file
    [Cpu_digout_mega128.brd, Cpu_digout_mega128.sch, do31.brd, do31.sch]
2024-05-02 hardware: Add usbif schematics png
2025-02-10 klaus240: Swap application button 25-0 and 25-1
    [application.c]
2026-01-02 visu: Fix mjpeg processing
    A completed jpeg image might be contained in a single http chunk.
    [kameraeingangwindow.cpp, kameraeingangwindow.h]
2026-01-18 DO31 sio: undef U2X
    Wrong UART baud rate at mega128@1MHz. Double baud rate not working.
    [sio_c.h]
2026-01-18 DO31 bootloader: Add readme for device setup
2026-01-18 DO31 bootloader: Add bootloader for devices using 1MHz MCU clock
2026-01-25 DO31 bootloader: Fix fuse doc for 1MHz crystal
    [main.c]
2026-03-08 Tools: mqtt: Fix typo
    [main.cpp]
2026-06-28 Hardware: DO8: Add initial version
    [do8.kicad_pcb, do8.kicad_sch]
2026-06-28 Ordered PCB
    [do8.kicad_pcb, do8.kicad_sch]
2026-06-29 visu: Print storage SOC in kWh
2026-10-23 visu: Add Growatt output power
