busmaster/homebus/(notices)

Notices in the files:
bus/test/main.c:
This program is free software; you can redistribute it and/or modify
it under the terms of the GNU General Public License as published by
the Free Software Foundation; either version 2 of the License, or
(at your option) any later version.
parts and their libraries:
EagleLibrary_Wuerth_Elektronik_eiSos_V6_: Copyright: Würth Elektronik
COPYRIGHT: Copyright (C) 2016 Accelerated Designs. All rights reserved
